arma966/ProgettazioneMeccanica2020/README.md

# ProgettazioneMeccanica2020

Versione SolidWorks: 2018

Versione MathCad: Prime 3.0
