arma966/ProgettazioneMeccanica2020/Relazione/imgs/Mathcad7.pdf

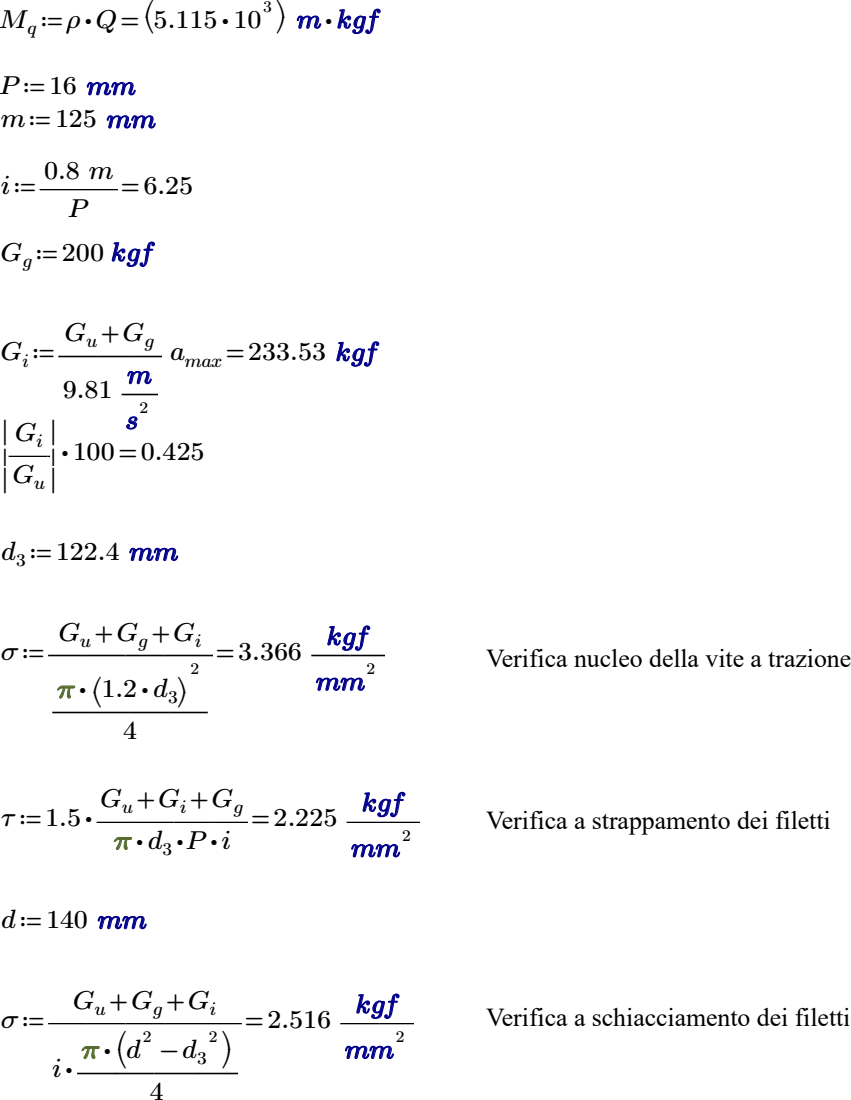
[picture p1: page 1]
m⋅ kgf; Gg≔200 kgf; amax; 233.53 kgf

Verifica nucleo della vite a trazione

Verifica a strappamento dei filetti

Verifica a schiacciamento dei filetti
