arma966/ProgettazioneMeccanica2020/Relazione/ProgettazioneMeccanica.tex

\documentclass[11pt]{article}
\usepackage[italian]{babel}
\usepackage[utf8]{inputenc}
\usepackage[margin=2.54cm]{geometry}
\usepackage{amsfonts,amsmath,amssymb}
\usepackage[none]{hyphenat}
\usepackage{fancyhdr}
\usepackage{booktabs}
\usepackage{graphicx}
\usepackage{float}
\usepackage{parskip}
\usepackage{subcaption}
\usepackage{amsmath}
\usepackage{wrapfig}
\usepackage{multicol}
%\usepackage{chngcntr}
\counterwithin{figure}{section}
\counterwithin{equation}{section}
\usepackage{quoting}
\quotingsetup{font=small}
\usepackage[official]{eurosym}
\usepackage{mathtools}
\usepackage{hyperref}
\hypersetup{
    colorlinks,
    citecolor=black,
    filecolor=black,
    linkcolor=black,
    urlcolor=black
}
\usepackage{multirow}
\usepackage{siunitx}

\pagestyle{fancy}
\fancyhead{}
\fancyfoot{}
\fancyhead[L]{\slshape \MakeUppercase{Progettazione meccanica}}
\fancyhead[R]{\slshape Davide Armenante}
\fancyfoot[C]{\thepage}

\begin{document}
\begin{titlepage}

\begin{center}
\vspace{1cm}
\large{\textbf{UNIVERSITA DEGLI STUDI DI TRIESTE}}\\[3mm]
\large{\textbf{Dipartimento di Ingegneria e Architettura}}\\[.7mm]
\large{\textbf{Corso di studi in Ingegneria Meccanica}}\\

\begin{figure}
\centering
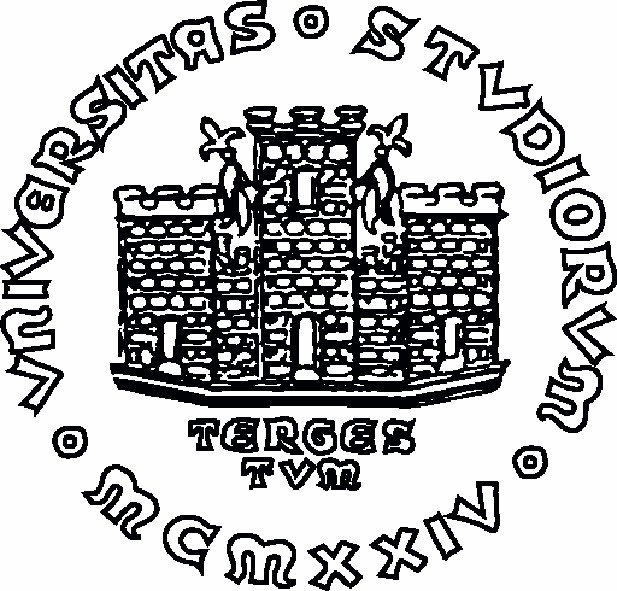
[picture p2: Relazione/imgs/unilogo.jpg]
  
\end{figure}

\vfill
\line(1,0){400}\\
\huge{\textbf{Progettazione di un bozzello con gancio per una portata di 55 tonnellate}}\\
\line(1,0){400}\\
\vfill
\hfill \normalsize Davide Armenante\\
\line(1,0){400}\\
Anno Accademico 2019-2020

\end{center}
\end{titlepage}
\pagebreak
\tableofcontents 
\thispagestyle{empty}
\pagebreak
\setcounter{page}{1}

\include{Capitoli/Introduzione}
\pagebreak
\include{Capitoli/SADT}
\pagebreak
\include{Capitoli/PrelimDim}
\pagebreak
\include{Capitoli/AnalisiFEM}
\pagebreak
\include{Capitoli/ModFin}
\pagebreak
\include{Capitoli/Conclusioni}

\appendix
\section{Golfari}
\begin{figure}[h!]
\centering
  
\end{figure}
\begin{figure}[h!]
\centering
  
\end{figure}

\end{document}
