arma966/ProgettazioneMeccanica2020/Relazione/Capitoli/Ciao.tex

\section{Ciao}
In fase di modellazione sono state modificate le quote del lamone-piastrone per permettere l'accoppiamento con le carrucole e la traversa. 
La distanza tra il foro per l'asse della traversa e quello dell'asse delle carrucole risultavano infatti troppo vicini, il carter superiore andava poi a compenetrare le carrucole.
