arma966/ProgettazioneMeccanica2020/SolidWorks/Ref/carter_circolare_00_assonometria_evidenza_profili.pdf

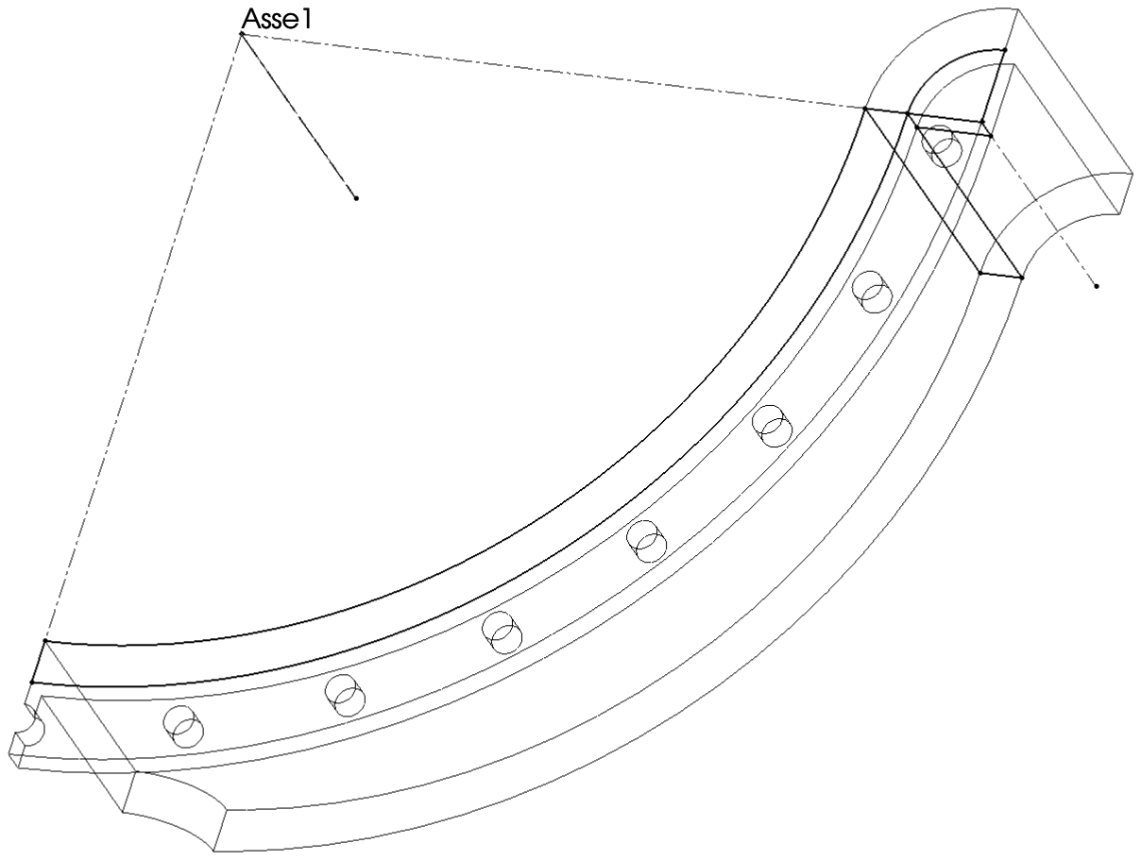
[picture p23: page 1]

Asse1
