arma966/ProgettazioneMeccanica2020/SolidWorks/Ref/irrigidimento_circolare_esterno_00_assonometria.pdf

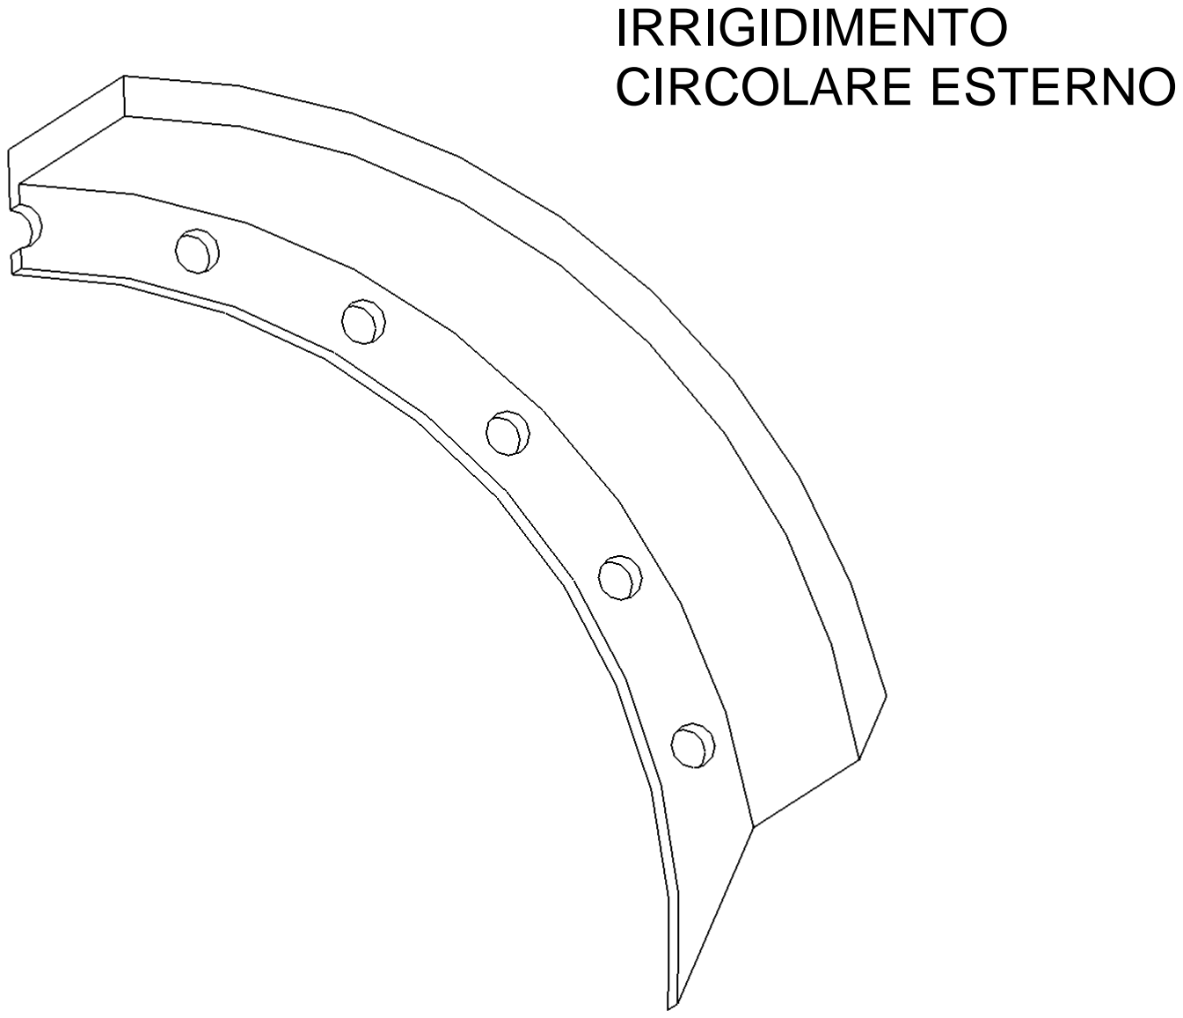
[picture p24: page 1]
