arma966/ProgettazioneMeccanica2020/SolidWorks/Ref/irrigidimento_circolare_esterno_00_evidenza_profili.pdf

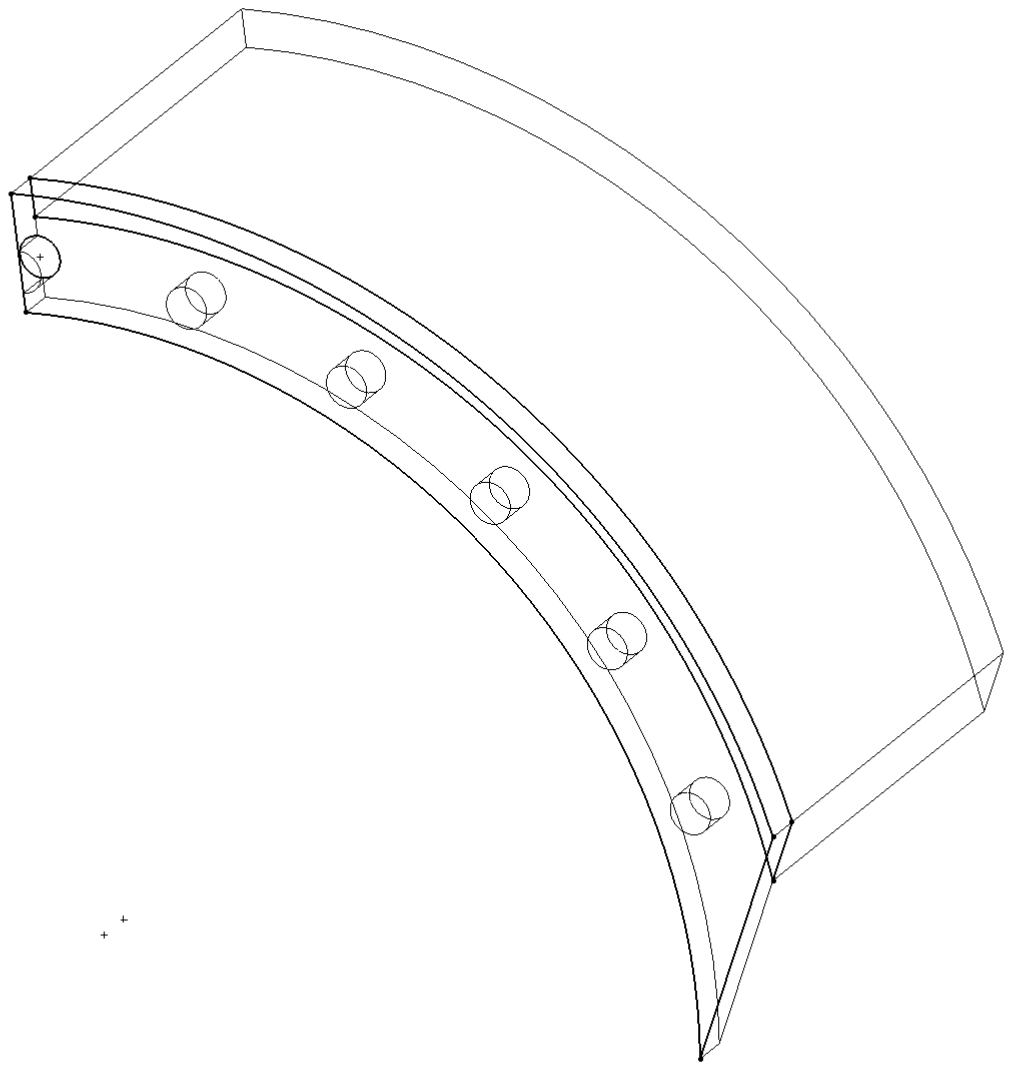
[picture p25: page 1]
