arma966/ProgettazioneMeccanica2020/SolidWorks/Ref/irrigidimento_esterno_00_assonometria.pdf

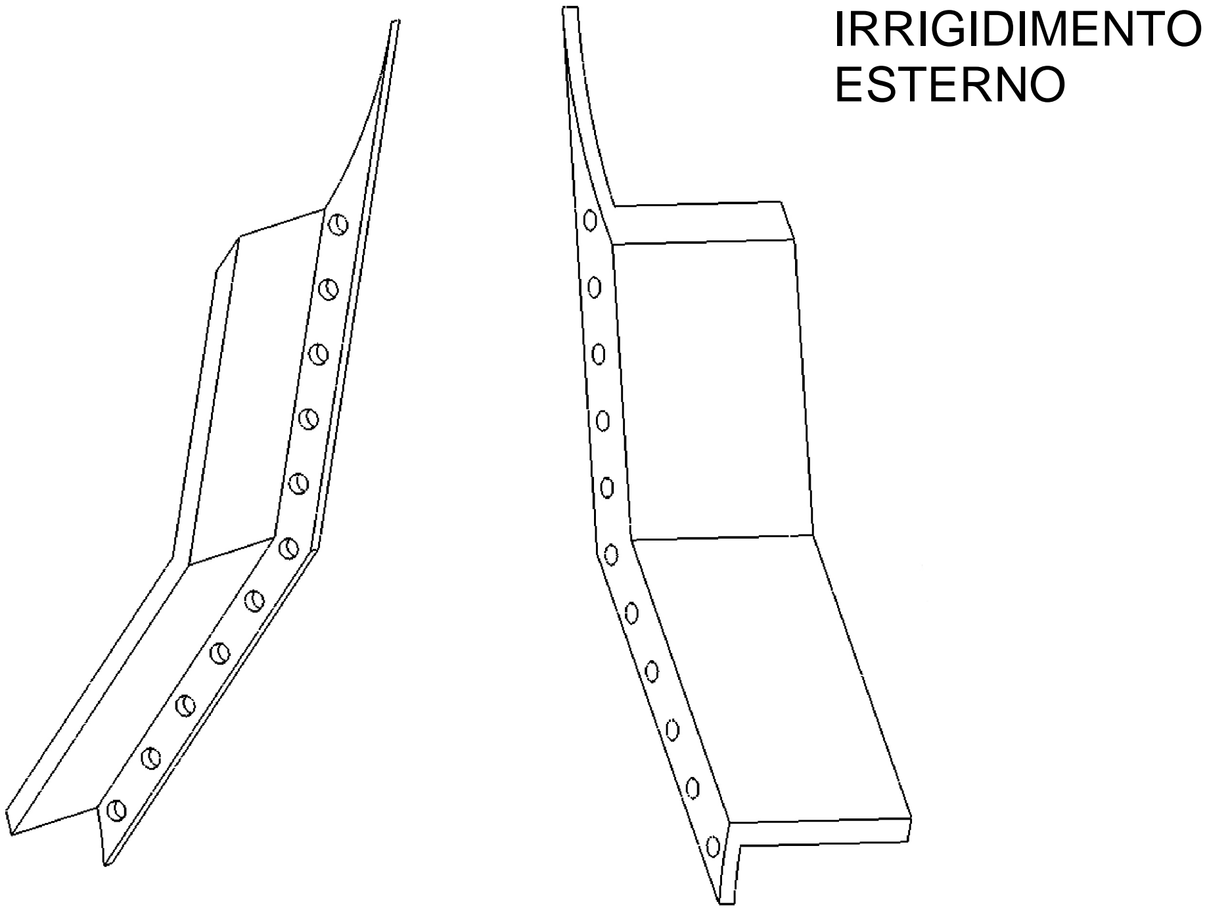
[picture p26: page 1]
