arma966/ProgettazioneMeccanica2020/SolidWorks/Ref/irrigidimento_esterno_00_evidenza_profili.pdf

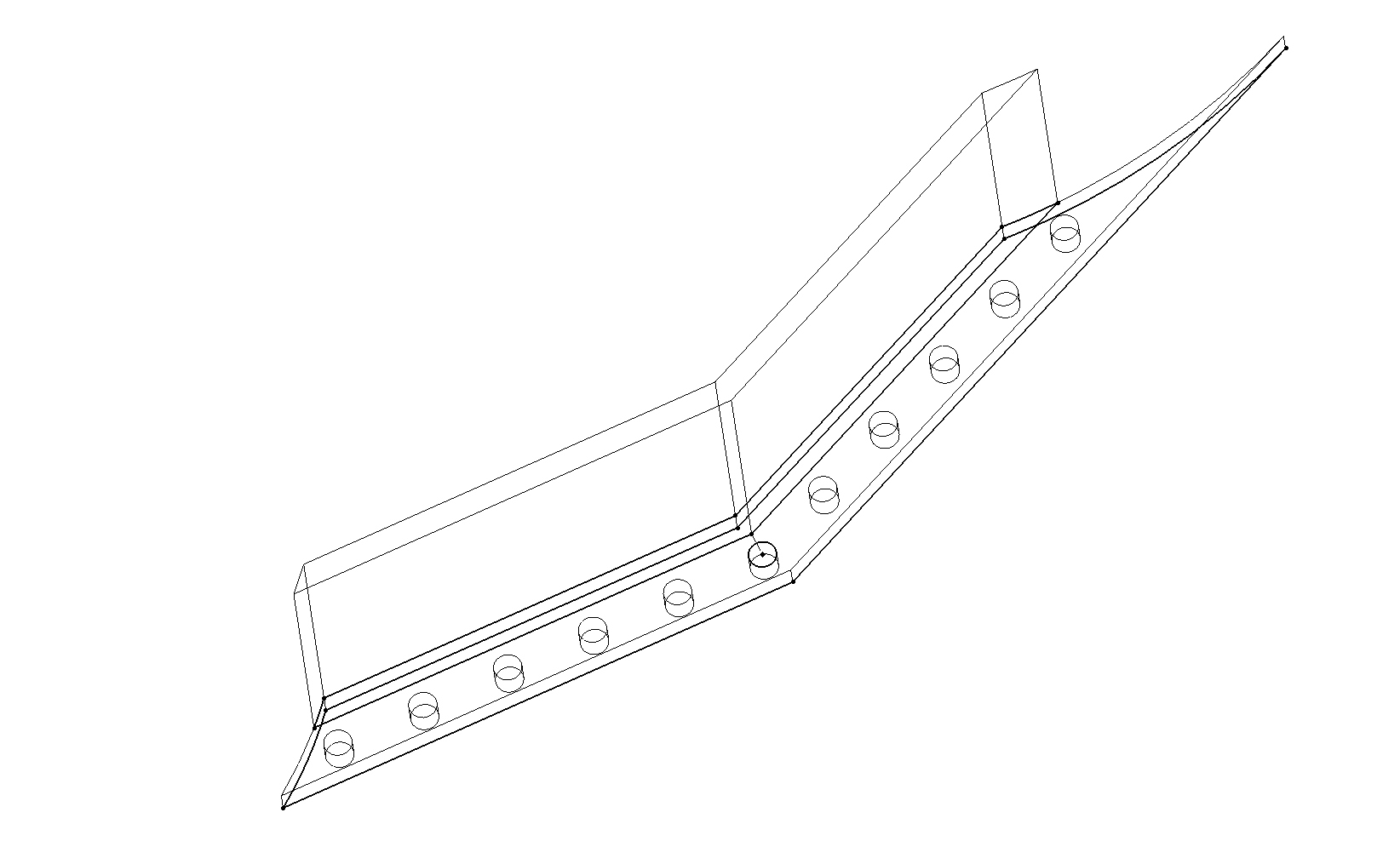
[picture p27: page 1]
