arma966/ProgettazioneMeccanica2020/SolidWorks/Ref/piastrone_00_assonometria.pdf

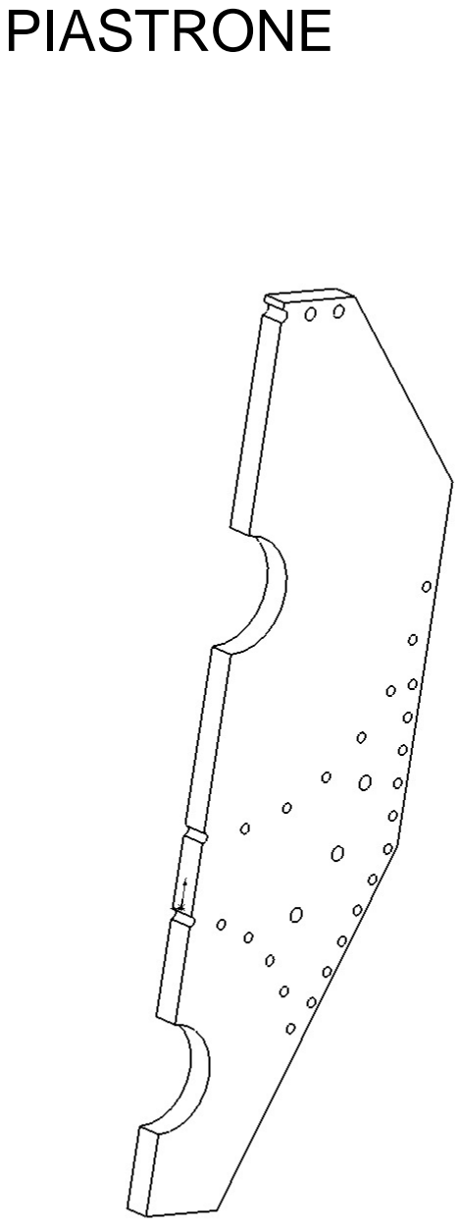
[picture p28: page 1]
