arma966/ProgettazioneMeccanica2020/SolidWorks/Ref/puleggia_00_assonometria.pdf

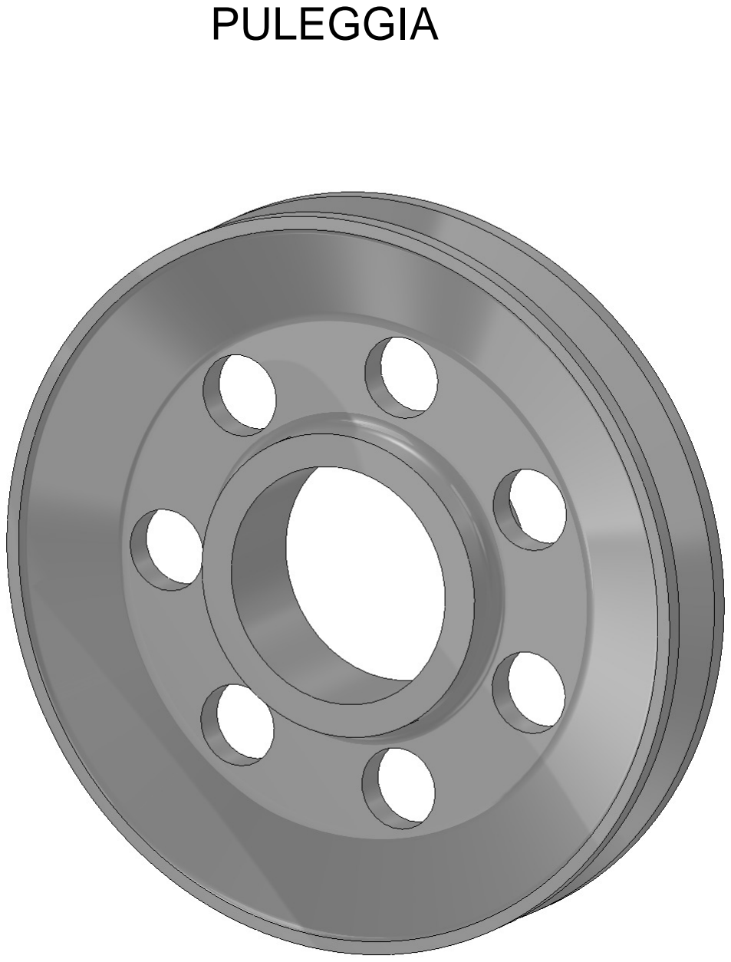
[picture p29: page 1]
