arma966/ProgettazioneMeccanica2020/SolidWorks/Ref/puleggia_00_evidenza_profili.pdf

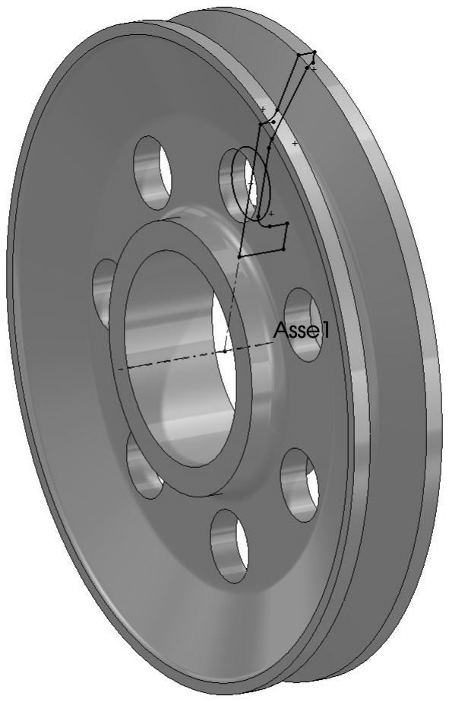
[picture p30: page 1]

Asse1
