arma966/ProgettazioneMeccanica2020/SolidWorks/Ref/traversa_00_assonometria.pdf

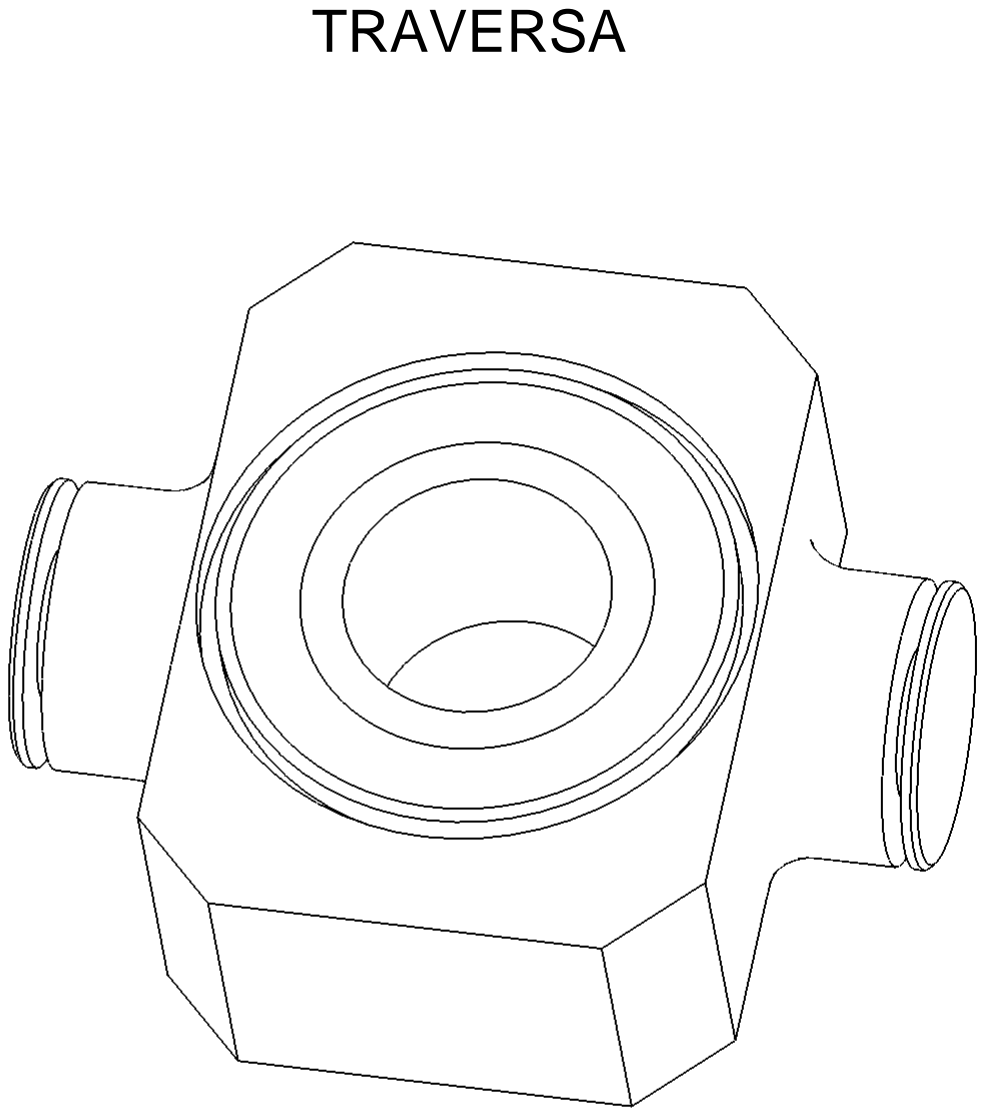
[picture p31: page 1]
