arma966/ProgettazioneMeccanica2020/SolidWorks/Ref/traversa_00_evidenza_profili.pdf

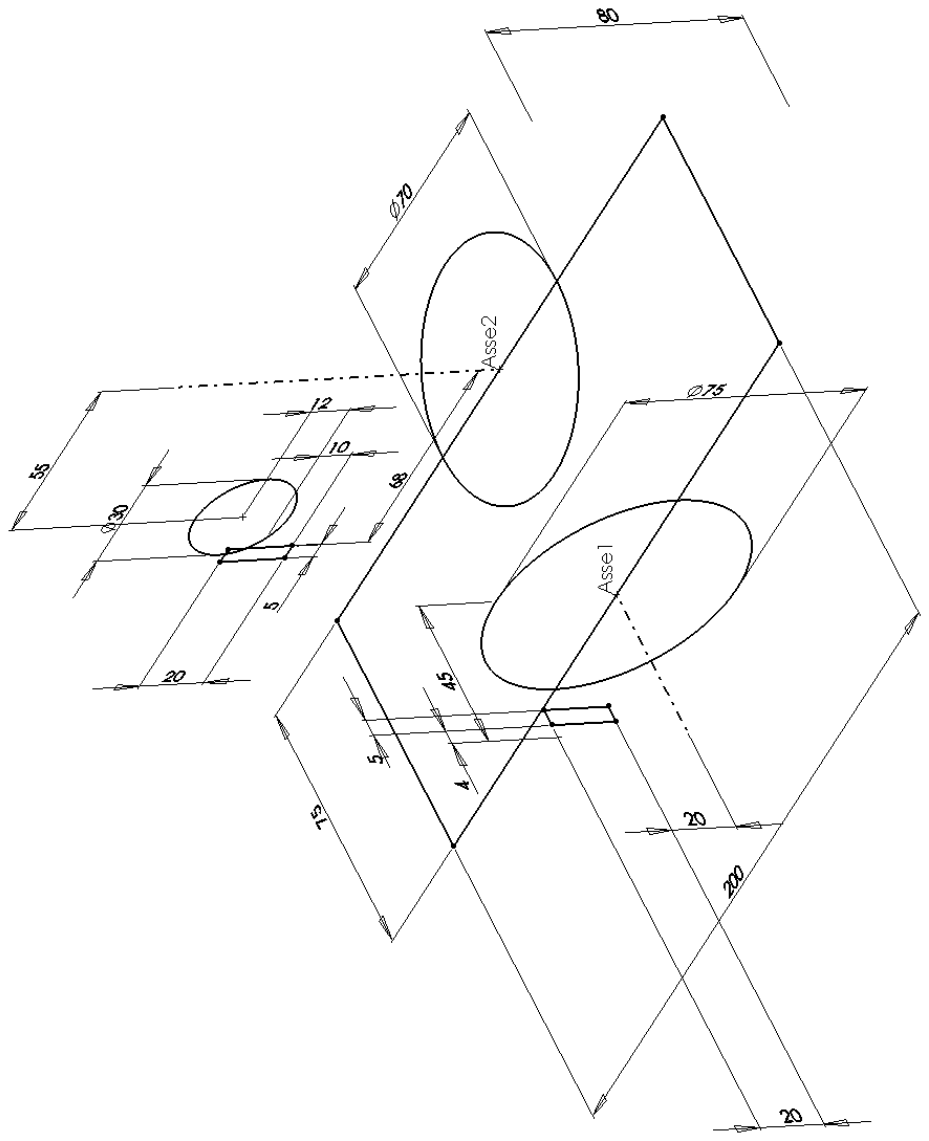
[picture p32: page 1]
