arma966/ProgettazioneMeccanica2020/Relazione/imgs/FilettaturaTabella.pdf

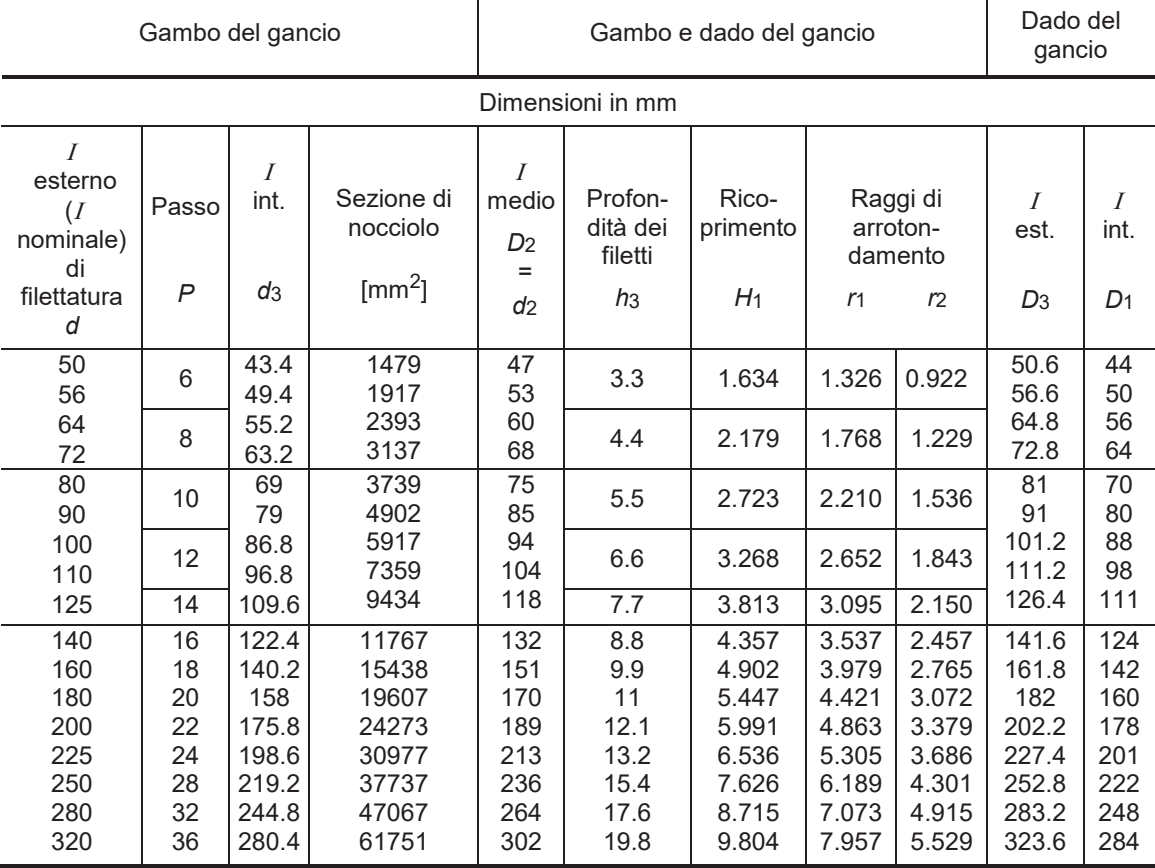
[picture p33: figure]
Gambo del gancio; Gambo e dado del gancio; ado del gancio; Dimensioni in mm;  esterno ( nominale) di filettatura d; Passo;  int.; Sezione di nocciolo; [mm² ];  medio; Profon- dità dei filetti; Rico- primento; Raggi di arroton- damento;  est.
