arma966/ProgettazioneMeccanica2020/Relazione/imgs/MathAsse2.pdf

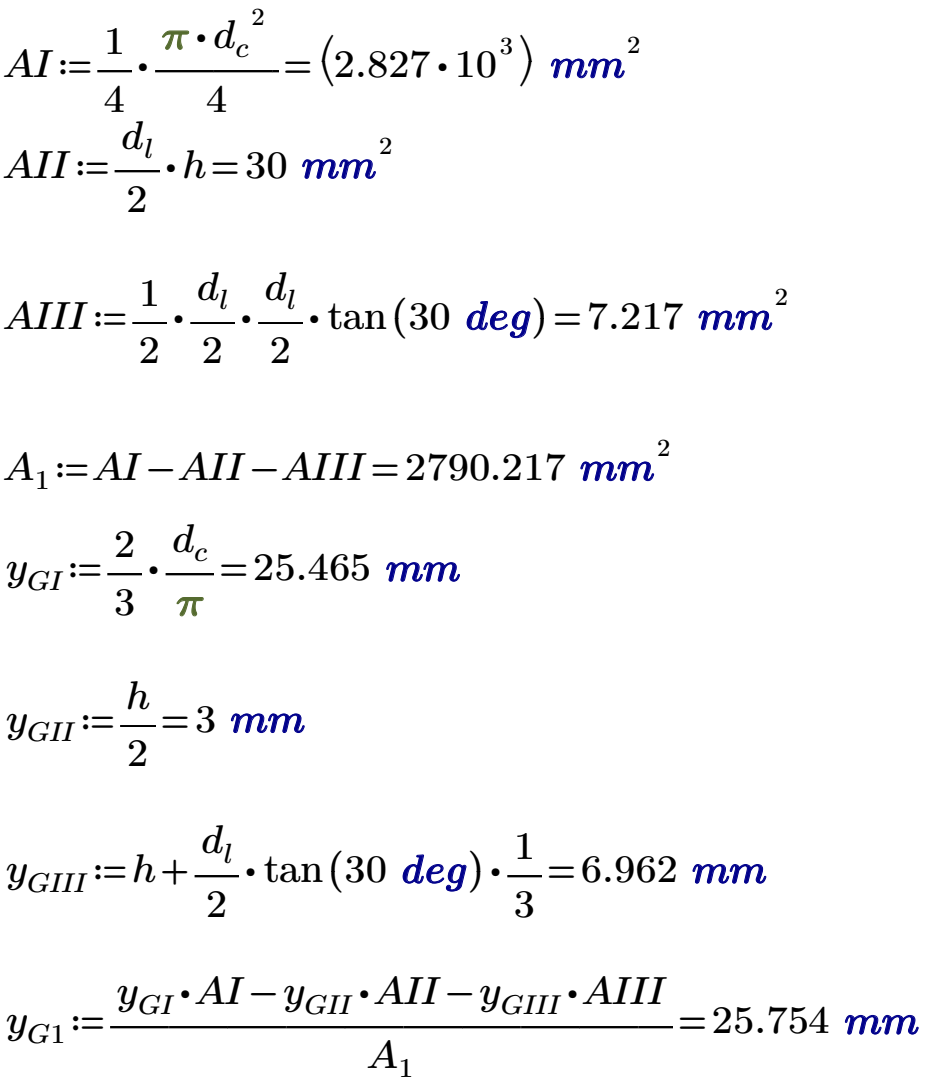
[picture p34: page 1]
AII≔―⋅ = dl 2; AIII≔―⋅ ⋅ ⋅; tan; 30 deg; A1≔AI AII AIII −−; yGI≔―⋅; yGII≔―= h 2; yGIII≔h; ( 30 deg; yG1≔――――――――――= yGI AI yGII ⋅AII−−⋅; yGIII ⋅AIII
