arma966/ProgettazioneMeccanica2020/Relazione/imgs/MathAsse4.pdf

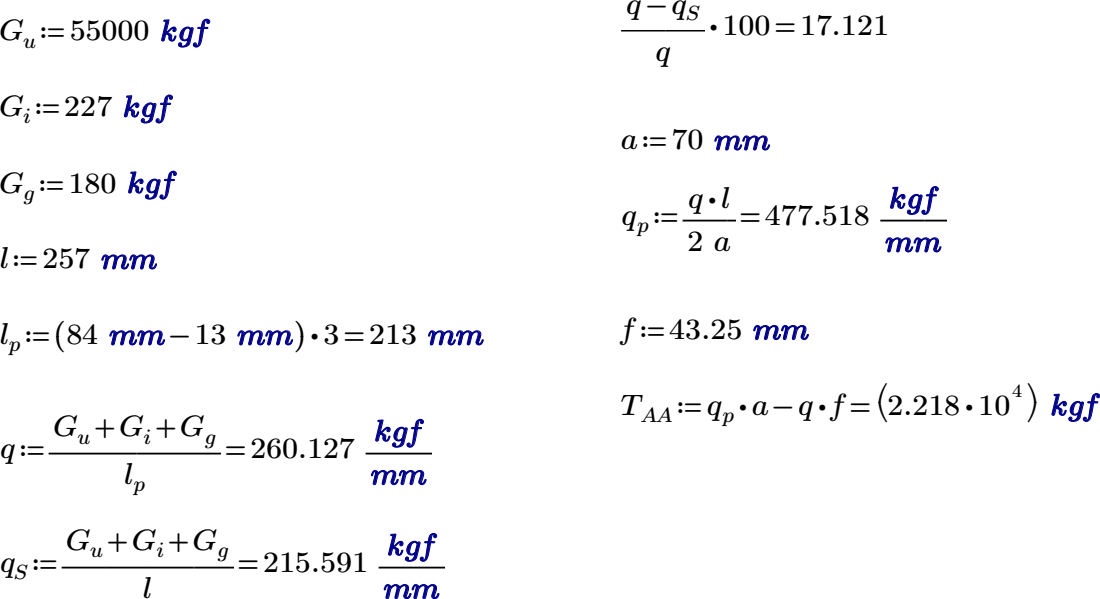
[picture p35: page 1]
Gu≔55000 kgf; Gi≔227 kgf; Gg≔180 kgf; 260.127 ―kgf ―mm; 215.591 ―kgf ―mm; 477.518 ―kgf ―mm; TAA≔qp ⋅a−q f⋅ =⎛ ⎝; kgf
