arma966/ProgettazioneMeccanica2020/Relazione/imgs/MathAsse4_0.pdf

S1ACn

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
H y +
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
y y −
G

⎞⎠

2
r

⎞⎠
y
