arma966/ProgettazioneMeccanica2020/Relazione/imgs/MathAsse5_0.pdf

S2ACn

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
h y −
G

⎞⎠

H y +
Gy
⋅

⎛⎝
−

R

−

2
⎛⎝y y −
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
h y −
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
――――― |y|−⎛⎝
h y −
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
