arma966/ProgettazioneMeccanica2020/Relazione/imgs/MathAsse5_1.pdf

α

⎛⎝
ybr

⎞⎠
≔

――⋅ 180π
atan

⎛⎜⎜⎝

―――――――― ||ybr||+yG br ⎛⎝ybr⎞⎠+――――― ||ybr||−⎛⎝h y − G⎞⎠

tan

(
30
d

e

g

)

⎞⎟⎟⎠
