arma966/ProgettazioneMeccanica2020/Relazione/imgs/MathAsse6_0.pdf

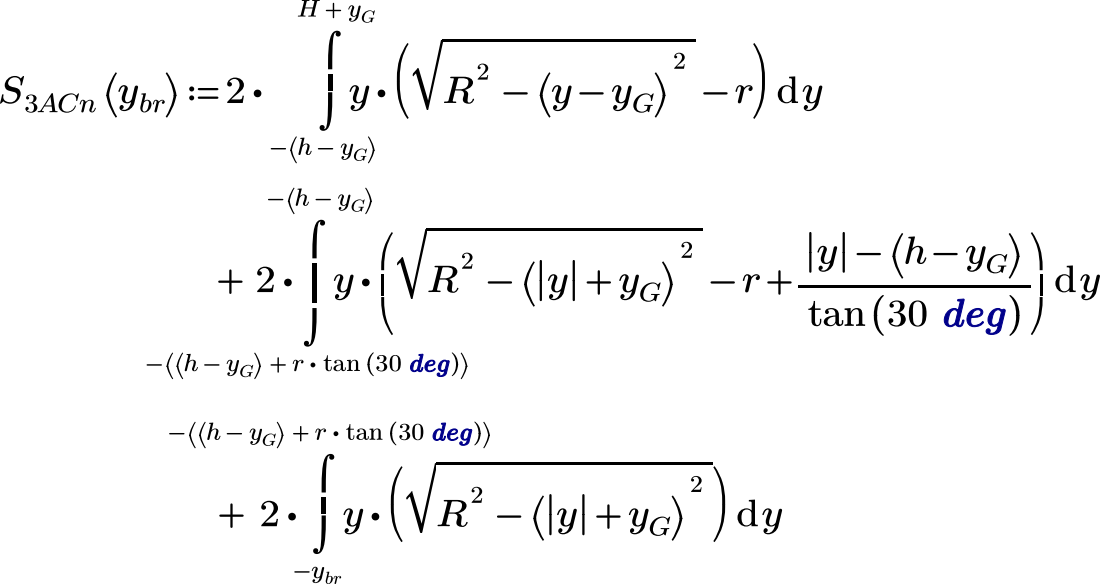
[picture p36: page 1]
