arma966/ProgettazioneMeccanica2020/Relazione/imgs/MathAsse6_1.pdf

br ⎛
⎝

ybr

⎞⎠≔2⋅ R −²
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
⎞⎠≔―180―π

atan⎛
⎜
⎜
⎝

――― ||
ybr
+yG
――― br ⎛
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
