arma966/ProgettazioneMeccanica2020/Relazione/imgs/MathAsse7.pdf

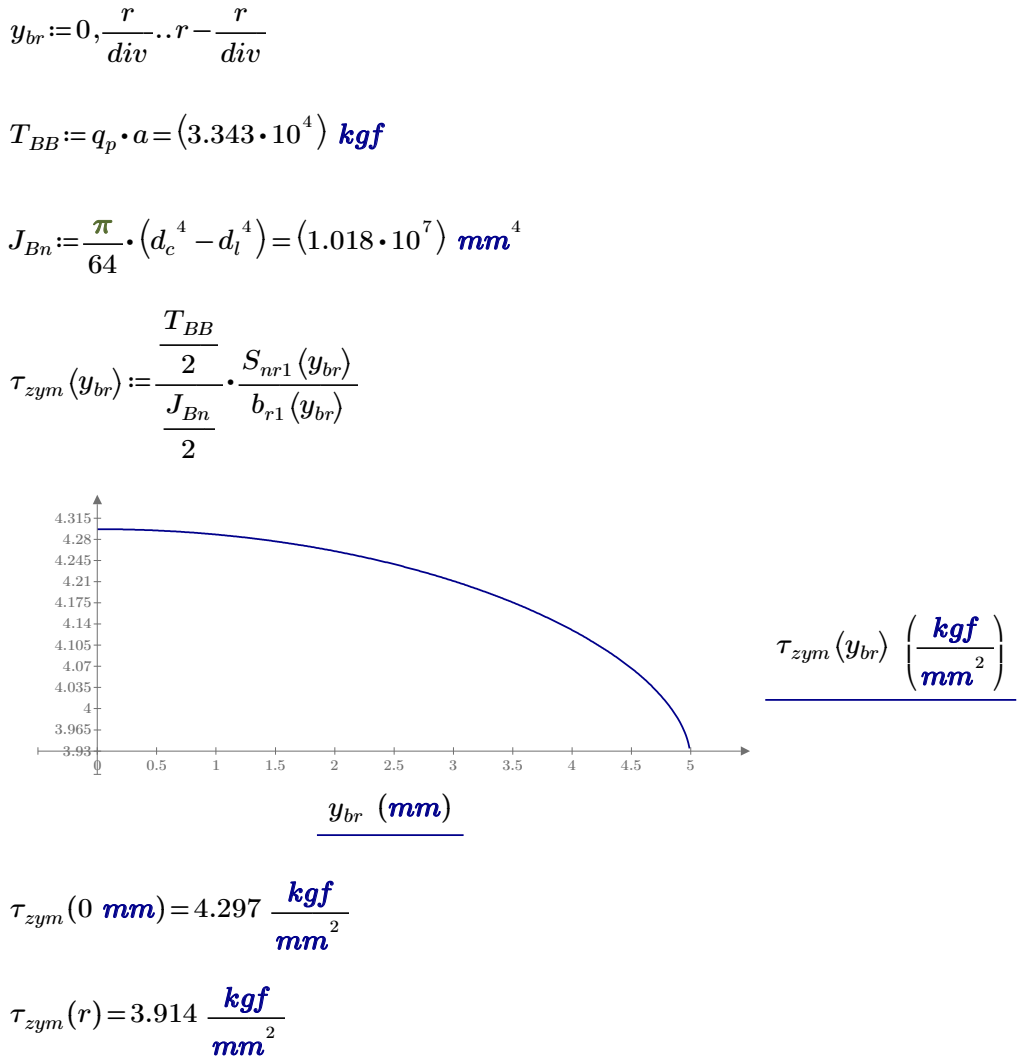
[picture p37: page 1]
TBB≔qp ⋅a=⎛ ⎝; kgf; JBn≔―⋅; τzym; ybr; ――TBB 2 ――JBn 2; ――― Snr1; ybr≔0,――‥ r div; r−―r ―div
