arma966/ProgettazioneMeccanica2020/Relazione/imgs/Mathcad5.pdf

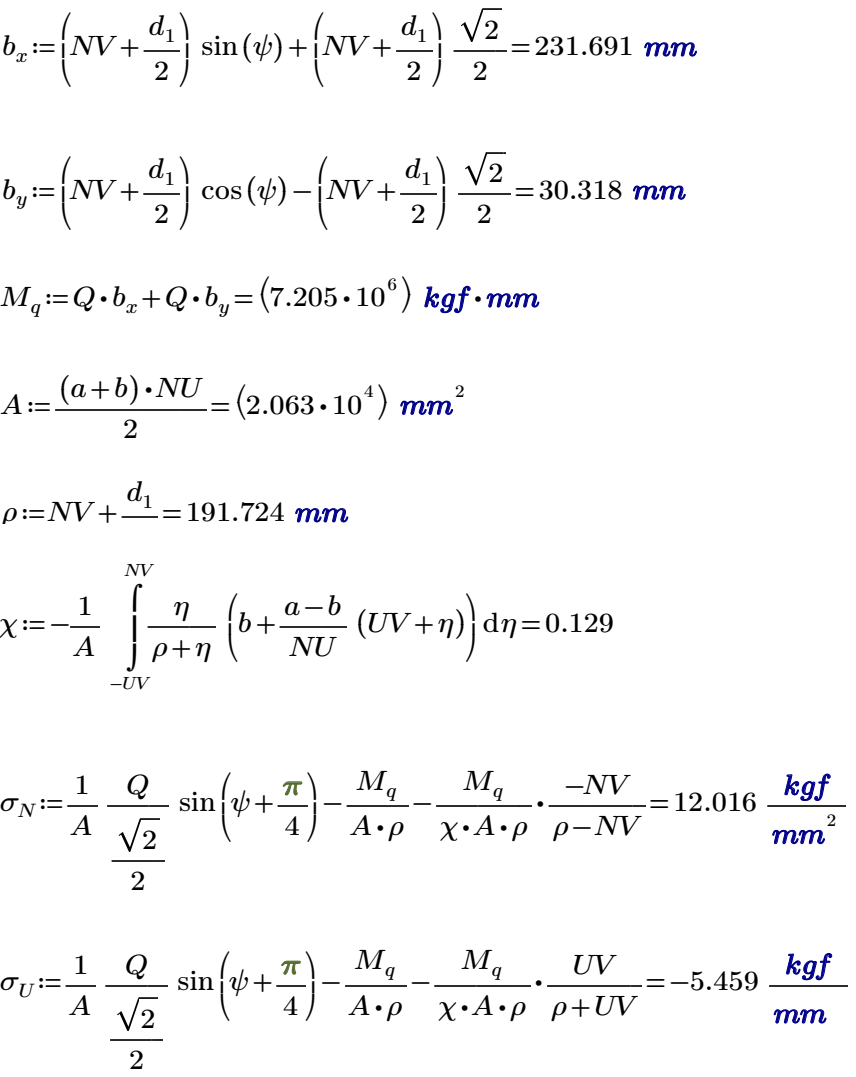
[picture p38: page 1]
sin; cos; kgf ⋅mm; sin⎛ ⎜ ⎝
