arma966/ProgettazioneMeccanica2020/Relazione/imgs/Mathcad6.pdf

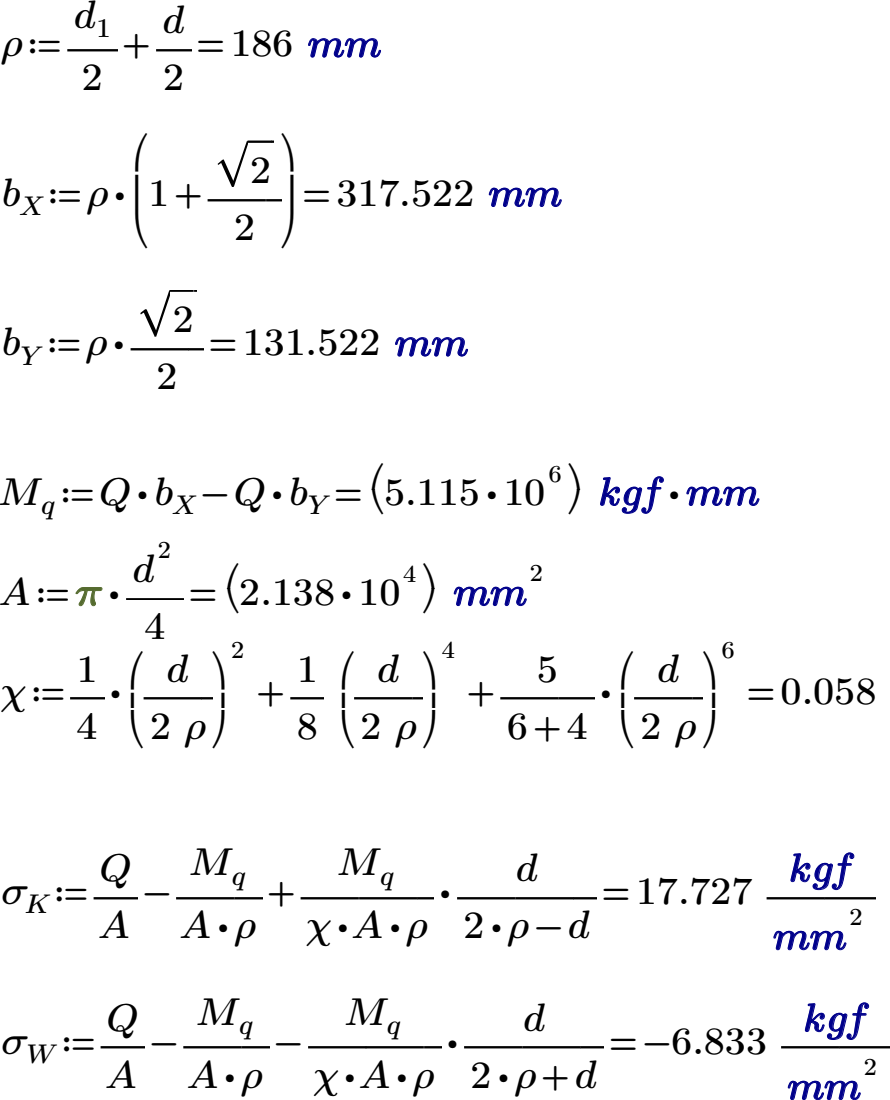
[picture p39: page 1]
kgf ⋅mm
