arma966/ProgettazioneMeccanica2020/Relazione/imgs/MathLP4.pdf

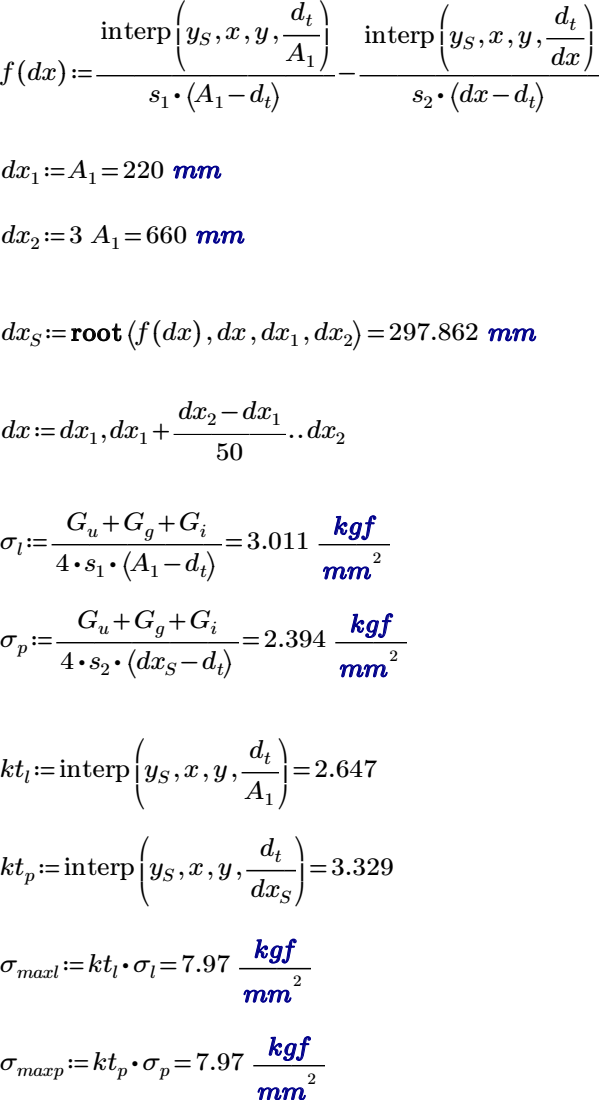
[picture p40: page 1]
interp⎛ ⎜ ⎝; dxS≔ root; dxS−dt; ktl≔; =interp⎛; ktp≔interp; y , , , S x y ――dt dxS

σmaxl≔ktl⋅σl=7.97 ―kg

σmaxp≔ktp ⋅σp=7.97 ―kg
