arma966/ProgettazioneMeccanica2020/Relazione/imgs/MathTrav1.pdf

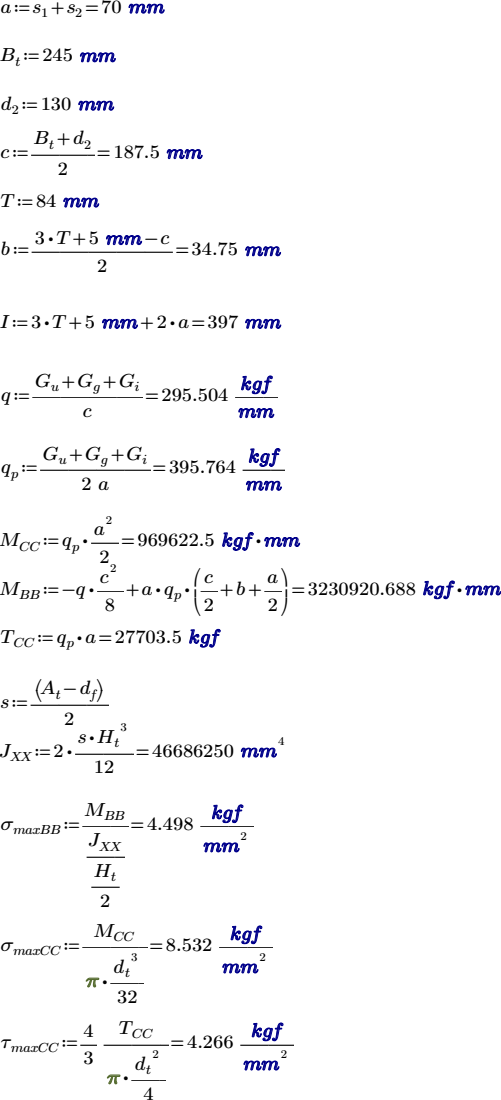
[picture p41: page 1]
295.504 ―kgf ―mm; 395.764 ―kgf ―mm; MCC≔qp ⋅―= a; 969622.5 kgf ⋅mm; MBB≔−q ⋅―; 3230920.688 kgf ⋅ mm; 2 JXX≔2 ⋅―――= s H⋅ t; σmaxBB≔――= MBB ――JXX; σmaxCC≔―――= MCC; τmaxCC≔―; 3 ――― TCC

TCC≔qp ⋅a=27703.5 kgf
