arma966/ProgettazioneMeccanica2020/Relazione/imgs/MathTrav4.pdf

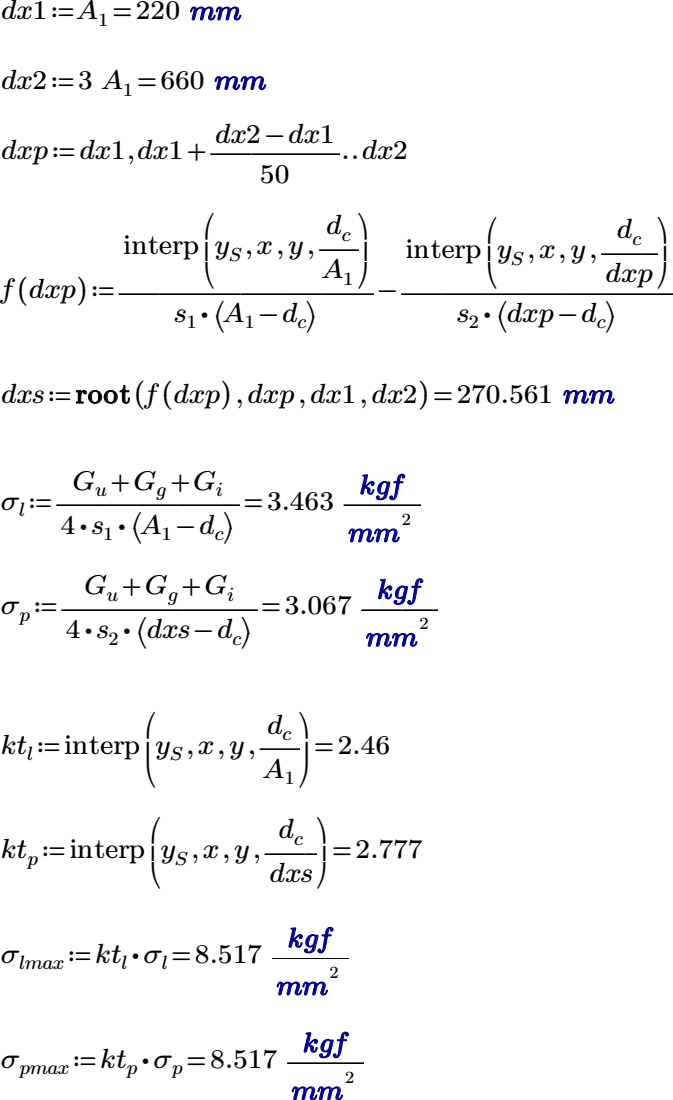
[picture p42: page 1]
dxp≔dx1,dx1+――――‥ dx2 dx1 − 50; dxp; interp⎛ ⎜ ⎝; dxp d − c⎞⎠; dxs≔root; ) ,dxp dx1 dx2 ,; dxs d − c⎞⎠; ktl≔interp; ktp≔interp; dxs

σlmax≔ktl⋅σl=8.517 ―kg

σpmax≔ktp ⋅σp=8.517 ―kg
