arma966/ProgettazioneMeccanica2020/Relazione/imgs/fem/GancioCarico1.jpg

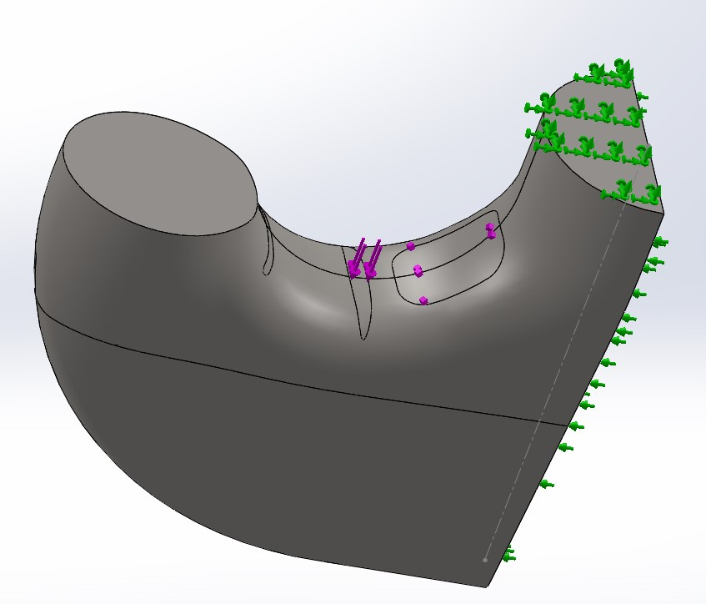
Relazione/imgs/fem/GancioCarico1.jpg
