arma966/ProgettazioneMeccanica2020/Relazione/imgs/fem/GancioCarico2.jpg

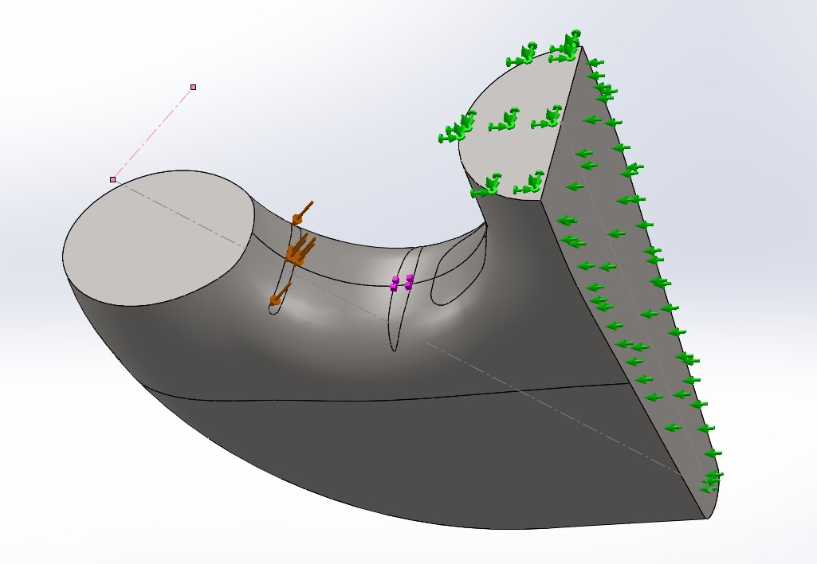
Relazione/imgs/fem/GancioCarico2.jpg
