arma966/ProgettazioneMeccanica2020/Relazione/imgs/fem/QuartoHD.jpg

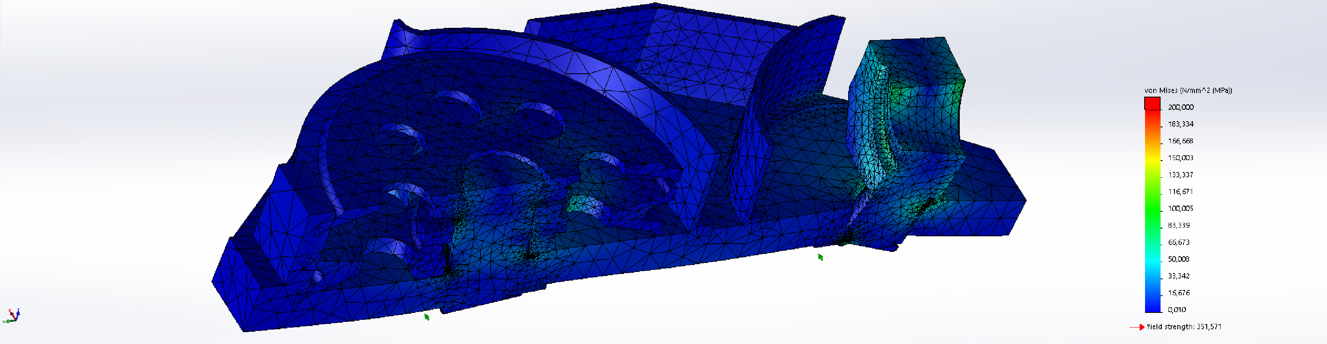
Relazione/imgs/fem/QuartoHD.jpg
