arma966/ProgettazioneMeccanica2020/Relazione/imgs/fem/SimGambo2.PNG

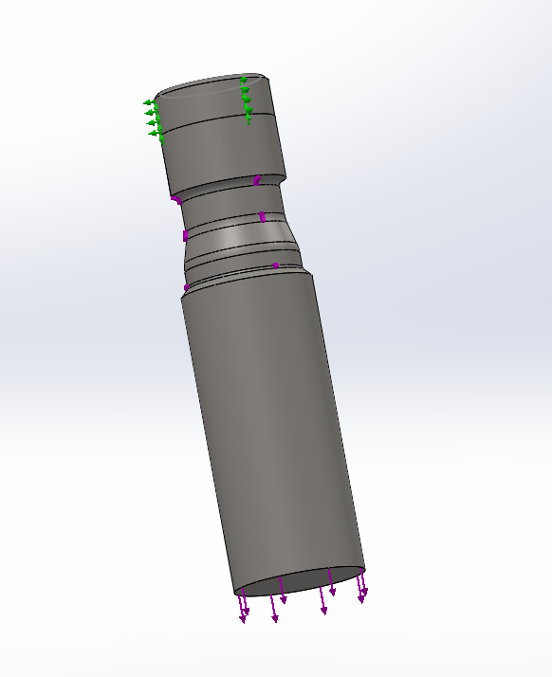
Relazione/imgs/fem/SimGambo2.PNG
