arma966/ProgettazioneMeccanica2020/Relazione/imgs/fem/SimTraversa2.PNG

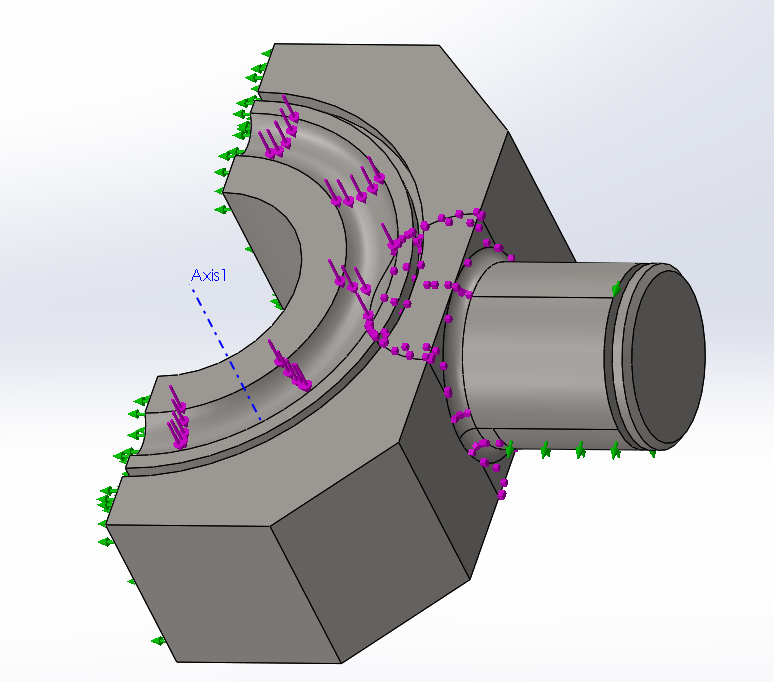
Relazione/imgs/fem/SimTraversa2.PNG
