arma966/ProgettazioneMeccanica2020/Relazione/imgs/fem/SimTraversa3.PNG

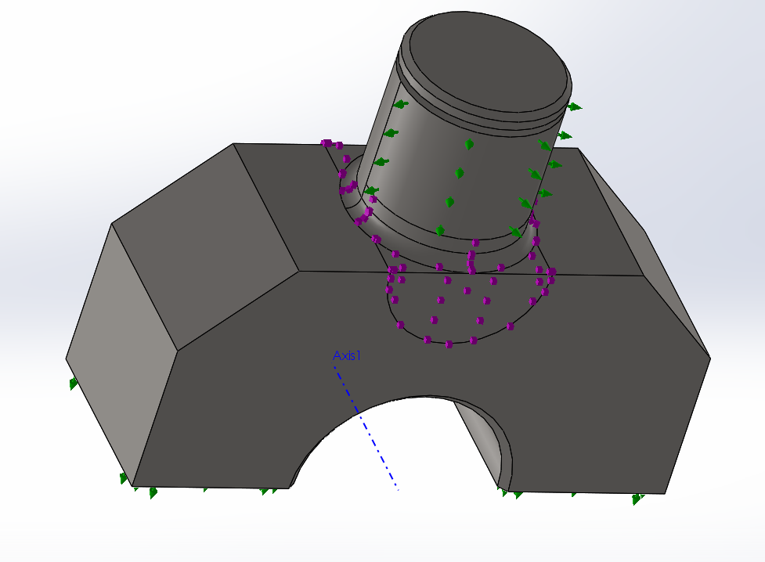
Relazione/imgs/fem/SimTraversa3.PNG
