arma966/ProgettazioneMeccanica2020/Relazione/imgs/fem/TraversaSim1.jpg

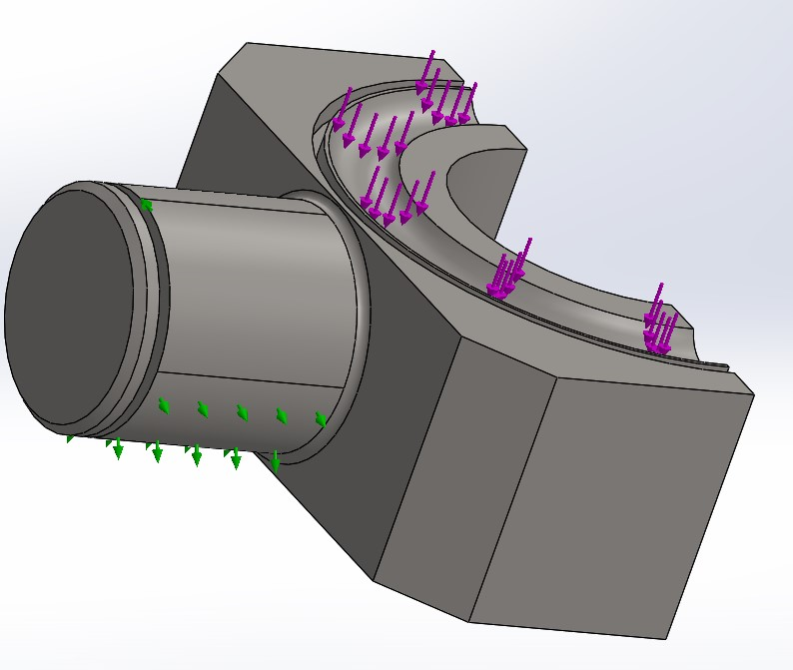
Relazione/imgs/fem/TraversaSim1.jpg
