arma966/ProgettazioneMeccanica2020/Relazione/imgs/fem/TraversaSim1.png

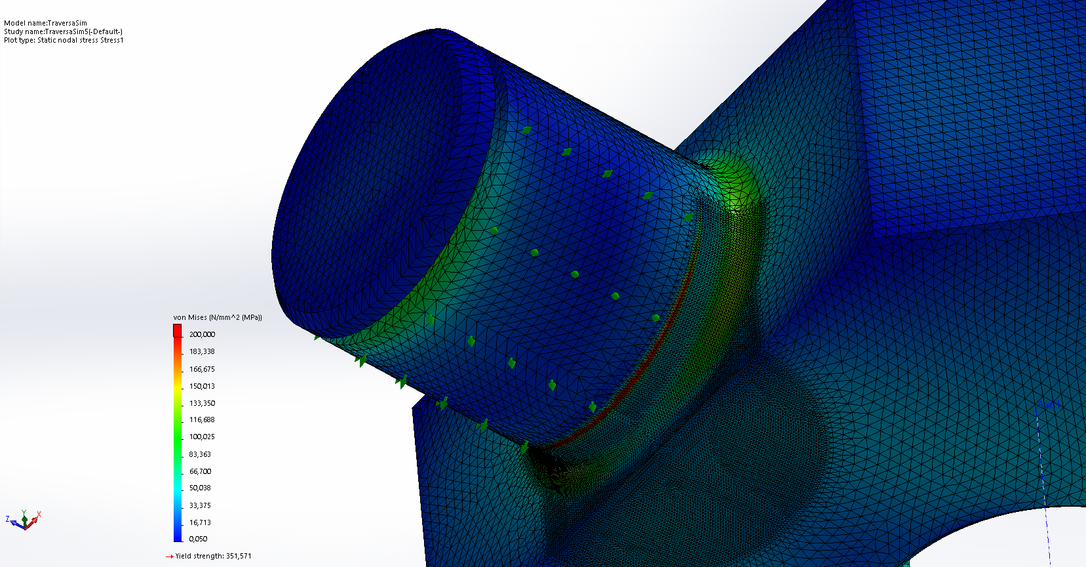
Relazione/imgs/fem/TraversaSim1.png
