arma966/ProgettazioneMeccanica2020/Relazione/render/Gancio1.png

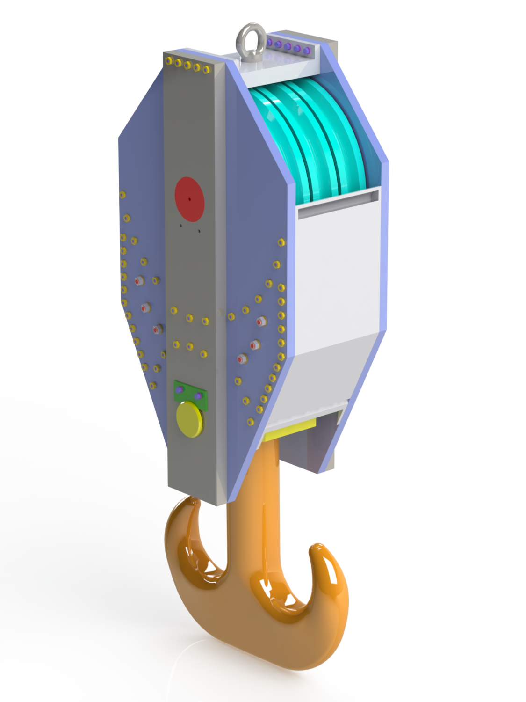
Relazione/render/Gancio1.png
