arma966/ProgettazioneMeccanica2020/Relazione/render/zoom1.png

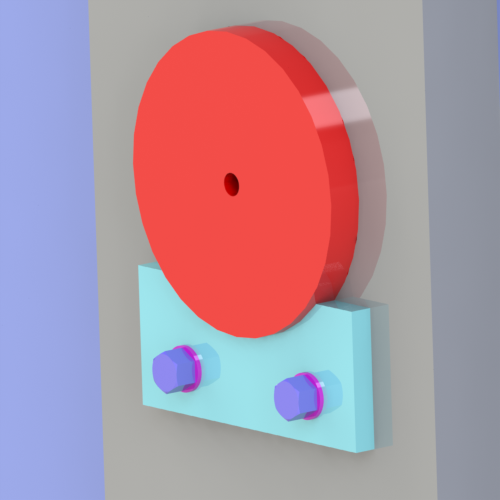
Relazione/render/zoom1.png
