arma966/ProgettazioneMeccanica2020/Relazione/render/zoom2.png

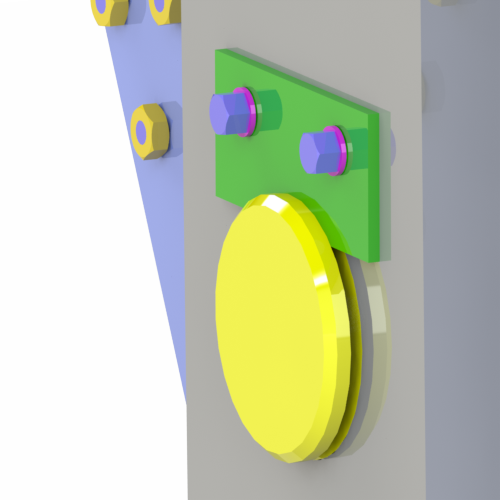
Relazione/render/zoom2.png
