arma966/ProgettazioneMeccanica2020/SolidWorks/Simulazioni/RisultatiGancio/GancioSim-Static 1/GancioFea1.png

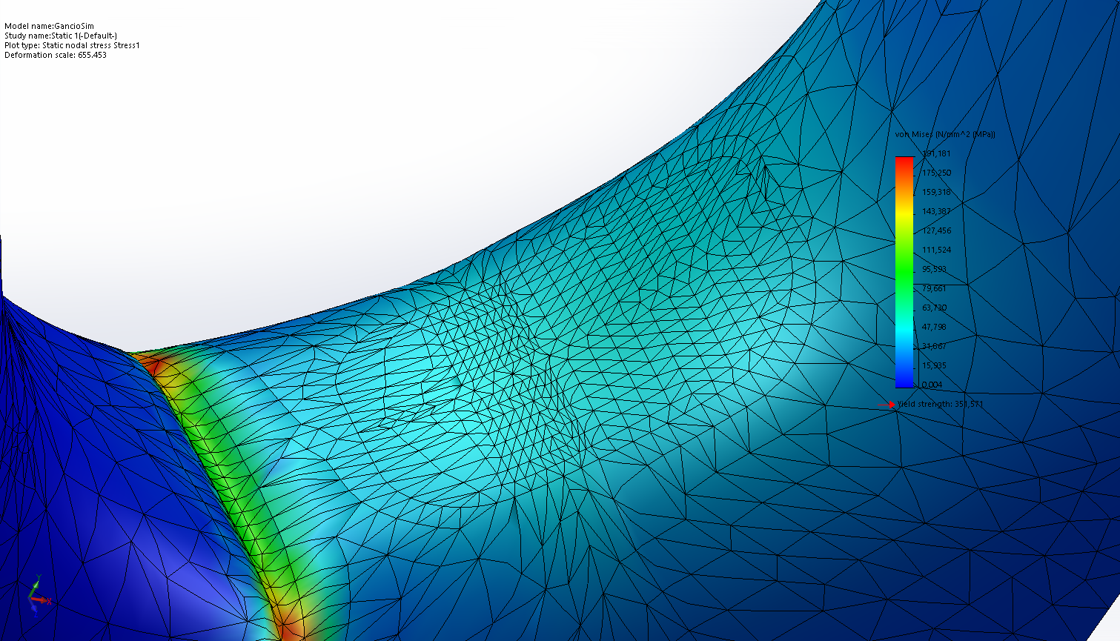
SolidWorks/Simulazioni/RisultatiGancio/GancioSim-Static 1/GancioFea1.png
