arma966/ProgettazioneMeccanica2020/SolidWorks/Simulazioni/RisultatiGancio/GancioSim-Static 1/GancioFEA2.png

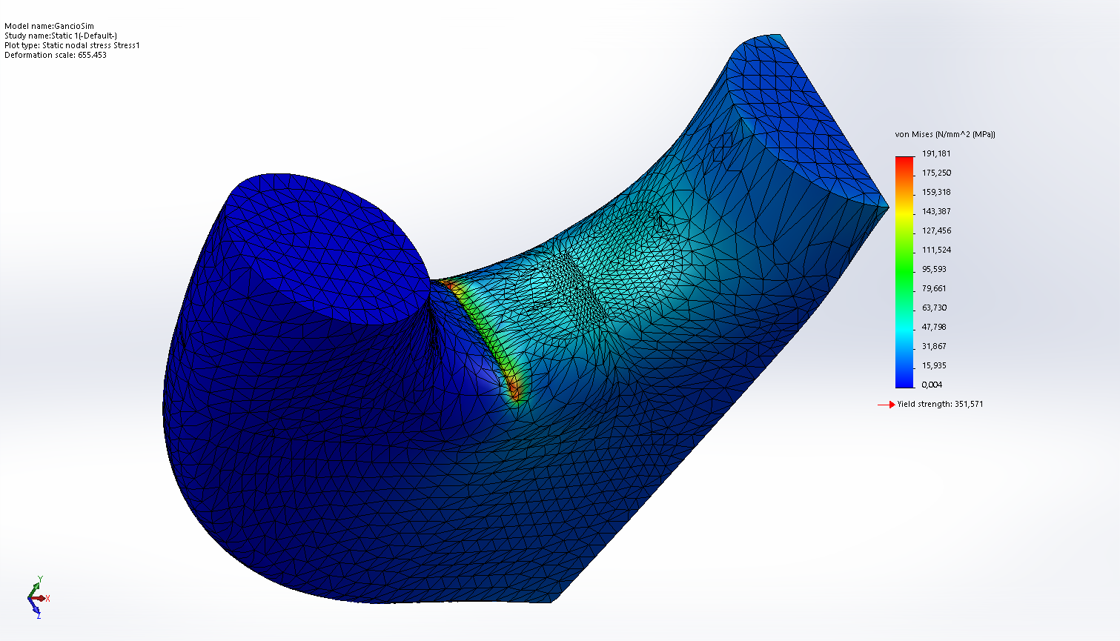
SolidWorks/Simulazioni/RisultatiGancio/GancioSim-Static 1/GancioFEA2.png
