arma966/ProgettazioneMeccanica2020/SolidWorks/Assembly.SLDASM

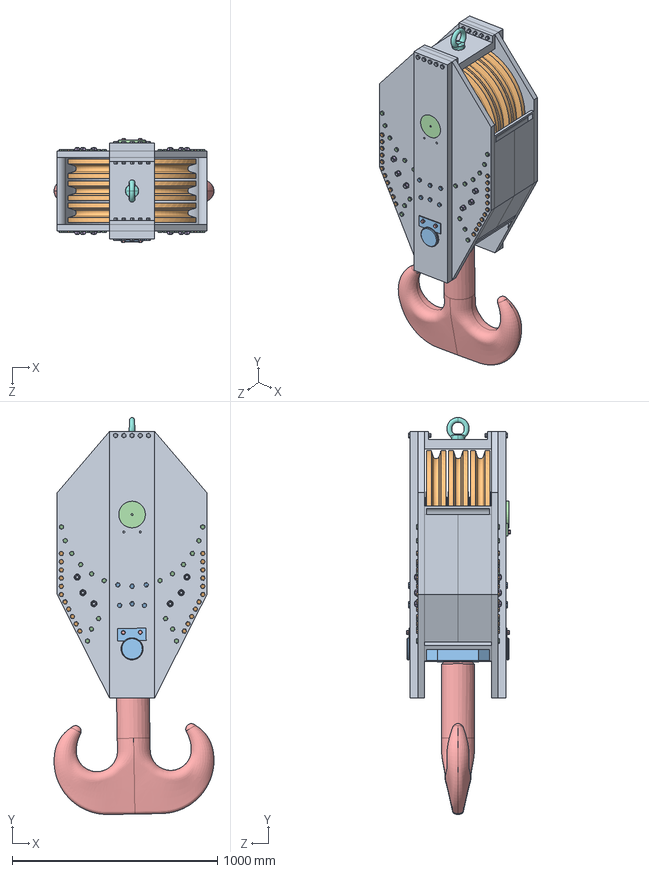
[picture p56: CAD file, 2020-09-05]
SolidWorks/Assembly.SLDASM
779.9 x 1935.7 x 507.0 mm
Piastrone
Puleggia x 3
Traversa
Asse
Gancio
Dado x 15
Boccola x 6
Golfare
M10 x 10
M10 - Corta x 44
M10 - Media x 14
M10 - 50mm x 36
M10 - Mordente x 6
