arma966/ProgettazioneMeccanica2020/SolidWorks/Simulazioni/MezzoBozzello/MezzoBozzelloSM.SLDASM

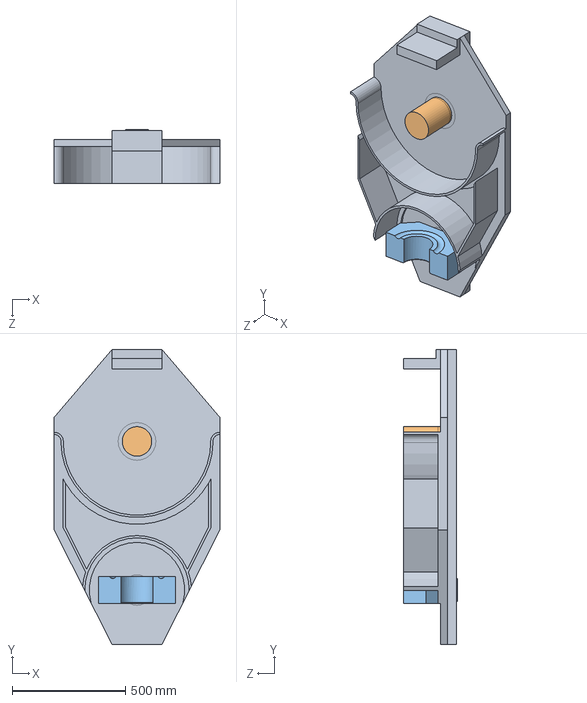
[picture p57: CAD file, 2020-09-05]
SolidWorks/Simulazioni/MezzoBozzello/MezzoBozzelloSM.SLDASM
730.0 x 1300.0 x 240.0 mm
PiastroneMB
AsseMB
