arma966/ProgettazioneMeccanica2020/SolidWorks/Simulazioni/Quarto/QuartoDiBozzello.SLDASM

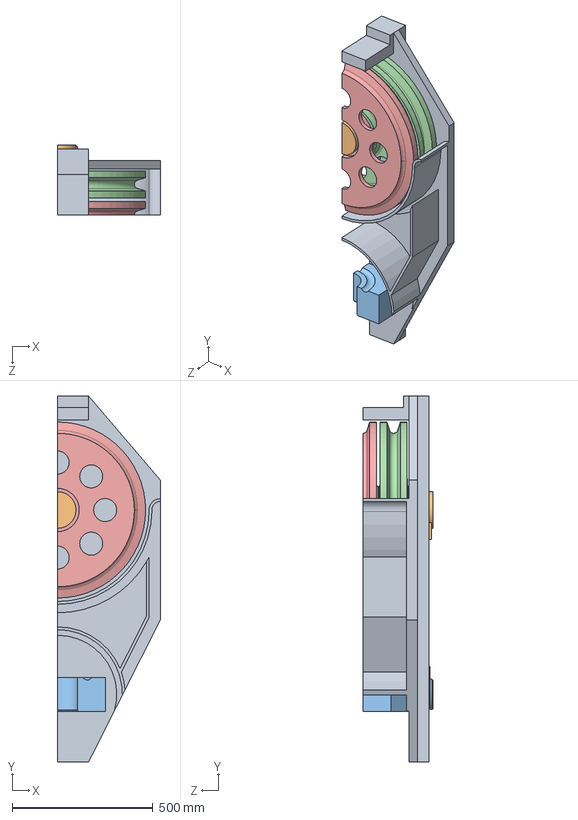
[picture p58: CAD file, 2020-09-05]
SolidWorks/Simulazioni/Quarto/QuartoDiBozzello.SLDASM
365.0 x 1300.0 x 249.0 mm
PiastroneQ
AsseQ
TraversaQ
PuleggiaQ
PuleggiaMezzaQ
