arma966/ProgettazioneMeccanica2020/SolidWorks/M10.SLDPRT

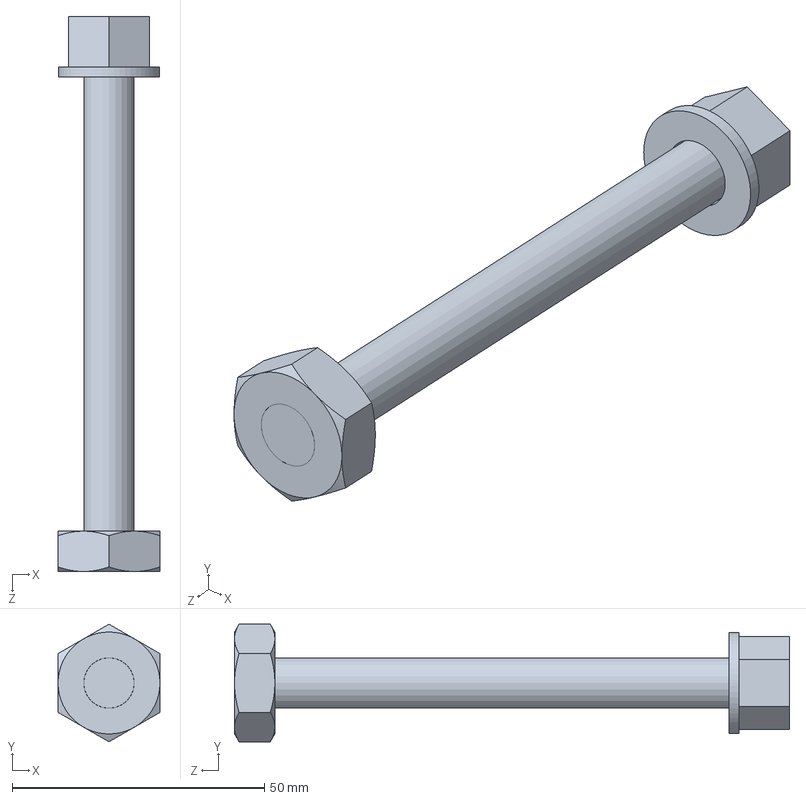
[picture p59: CAD file, 2020-09-05]
SolidWorks/M10.SLDPRT
20.2 x 23.3 x 110.0 mm
