arma966/ProgettazioneMeccanica2020/SolidWorks/Ref/YT_Flangia.SLDPRT

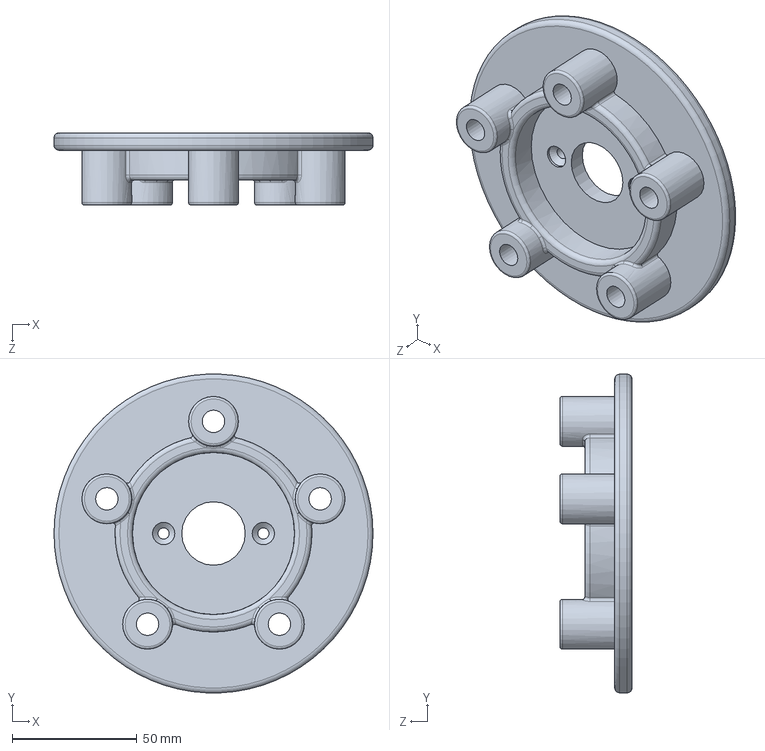
[picture p60: CAD file, 2020-09-05]
SolidWorks/Ref/YT_Flangia.SLDPRT
128.0 x 127.9 x 29.0 mm
