arma966/ProgettazioneMeccanica2020/SolidWorks/Simulazioni/AsseSim.SLDPRT

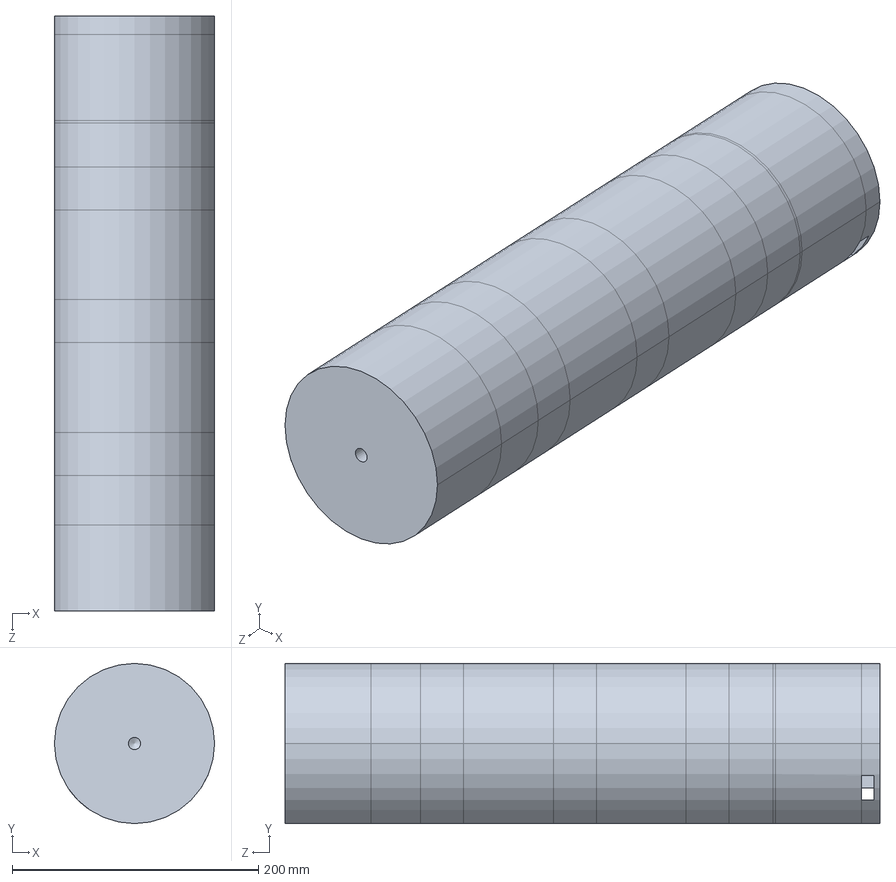
[picture p61: CAD file, 2020-09-05]
SolidWorks/Simulazioni/AsseSim.SLDPRT
130.0 x 130.0 x 483.0 mm
