arma966/ProgettazioneMeccanica2020/SolidWorks/Simulazioni/MezzoBozzello/TraversaMB.SLDPRT

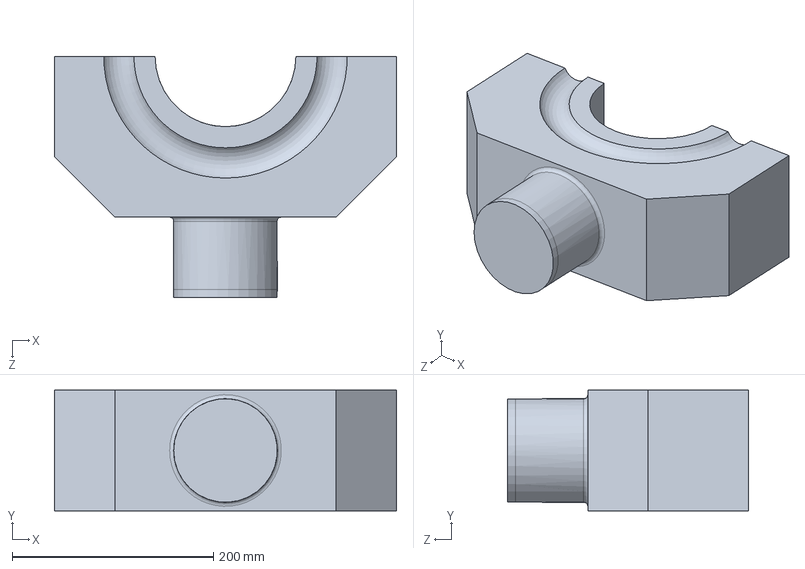
[picture p62: CAD file, 2020-09-05]
SolidWorks/Simulazioni/MezzoBozzello/TraversaMB.SLDPRT
340.0 x 120.0 x 240.0 mm
