arma966/ProgettazioneMeccanica2020/SolidWorks/Simulazioni/Quarto/GancioQ.SLDPRT

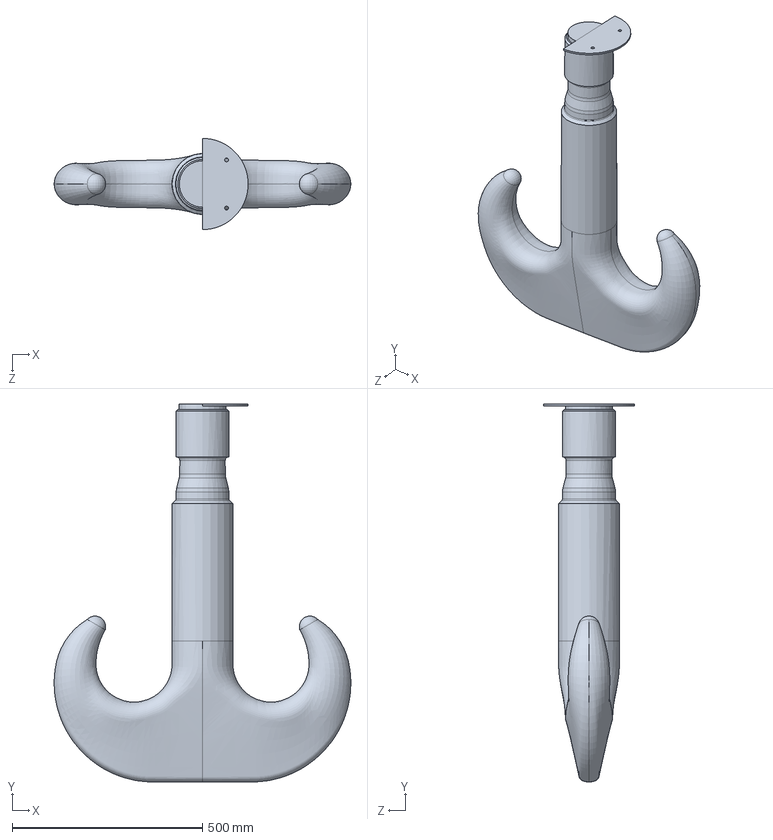
[picture p63: CAD file, 2020-09-05]
SolidWorks/Simulazioni/Quarto/GancioQ.SLDPRT
779.9 x 993.6 x 240.0 mm
