arma966/ProgettazioneMeccanica2020/SolidWorks/Piastrone.SLDPRT

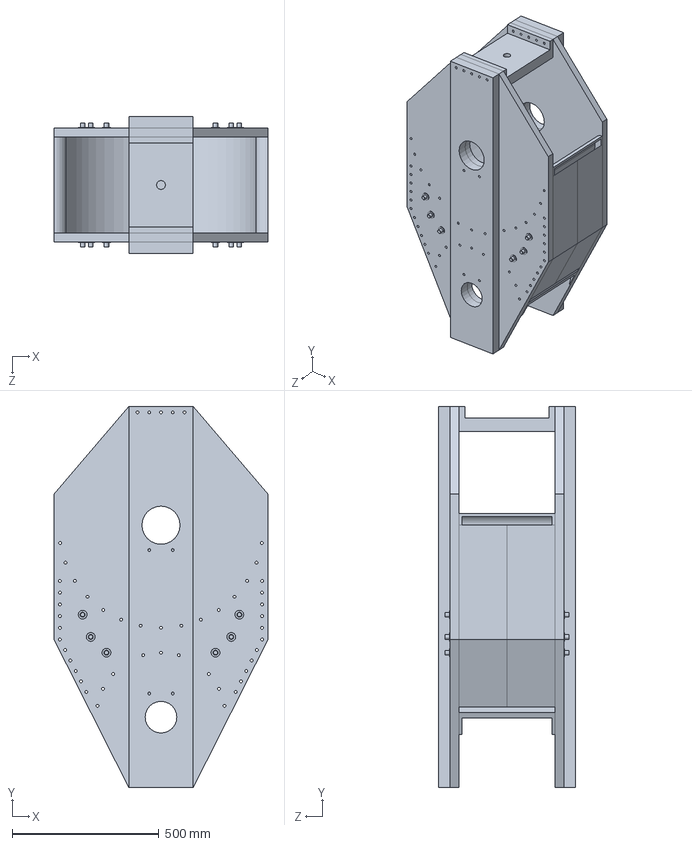
[picture p64: CAD file, 2020-09-05]
SolidWorks/Piastrone.SLDPRT
730.0 x 1300.0 x 468.0 mm
