arma966/ProgettazioneMeccanica2020/SolidWorks/Ref/YT_Lamierapiegata.SLDPRT

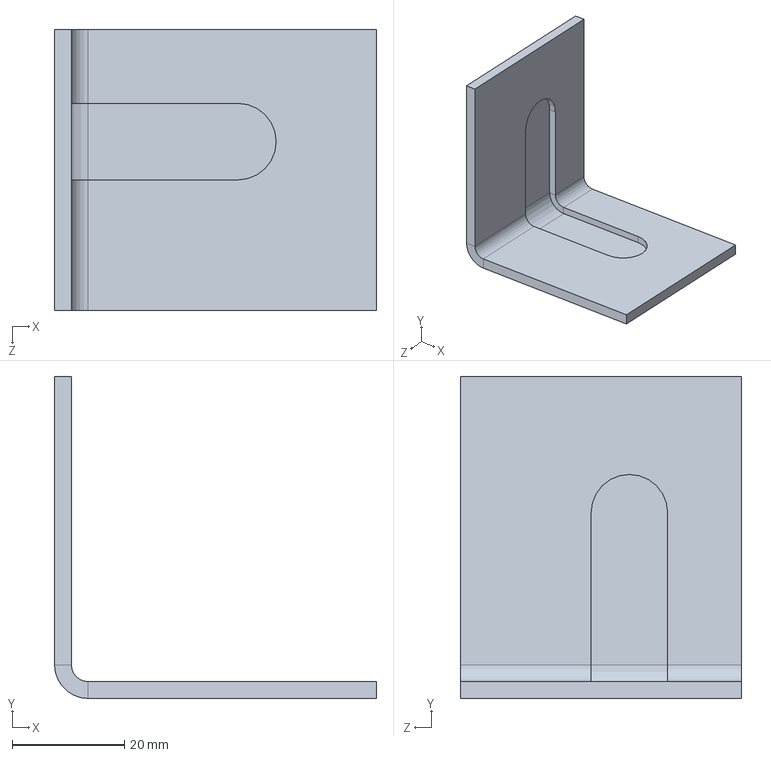
[picture p65: CAD file, 2020-09-05]
SolidWorks/Ref/YT_Lamierapiegata.SLDPRT
57.3 x 57.3 x 50.0 mm
