arma966/ProgettazioneMeccanica2020/SolidWorks/Simulazioni/MezzoBozzello/AsseMB.SLDPRT

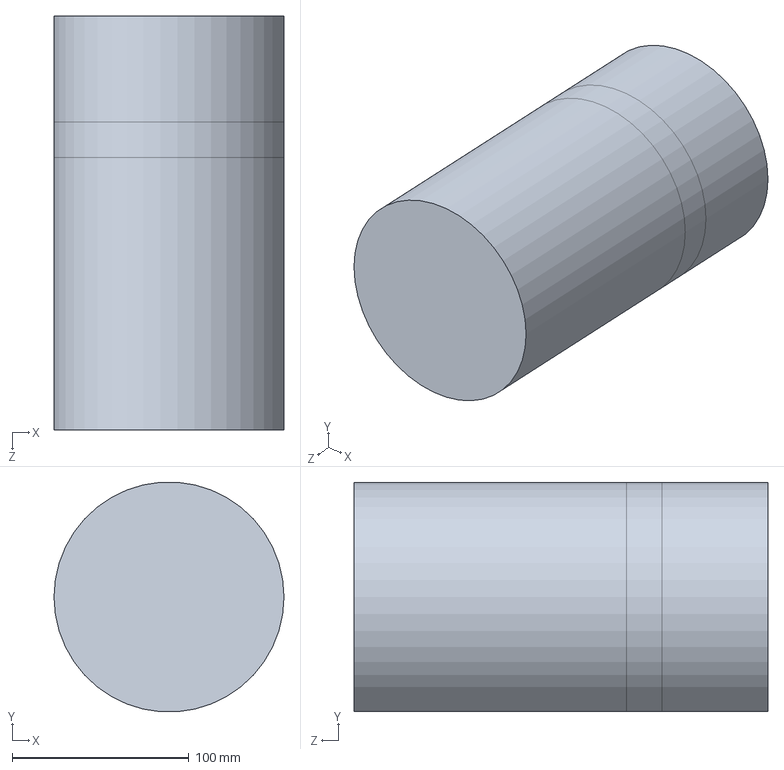
[picture p66: CAD file, 2020-09-05]
SolidWorks/Simulazioni/MezzoBozzello/AsseMB.SLDPRT
130.0 x 129.6 x 234.0 mm
