arma966/ProgettazioneMeccanica2020/SolidWorks/Simulazioni/Quarto/PiastroneQ.SLDPRT

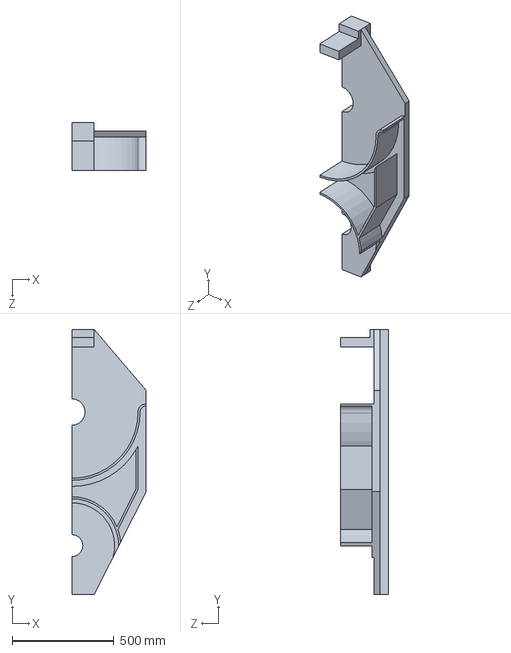
[picture p67: CAD file, 2020-09-05]
SolidWorks/Simulazioni/Quarto/PiastroneQ.SLDPRT
365.0 x 1300.0 x 234.0 mm
