arma966/ProgettazioneMeccanica2020/SolidWorks/Simulazioni/TraversaSim.SLDPRT

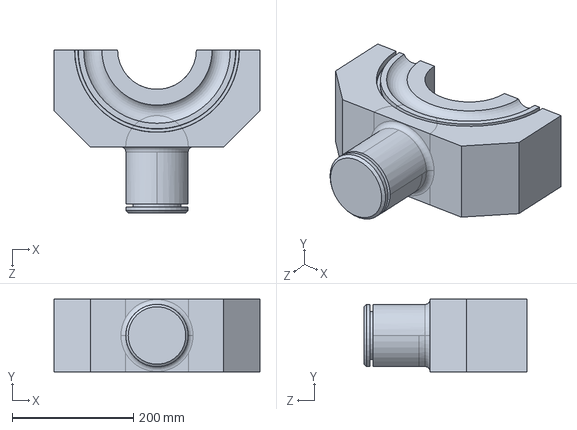
[picture p68: CAD file, 2020-09-05]
SolidWorks/Simulazioni/TraversaSim.SLDPRT
340.0 x 120.0 x 269.0 mm
