arma966/ProgettazioneMeccanica2020/SolidWorks/Asse.SLDPRT

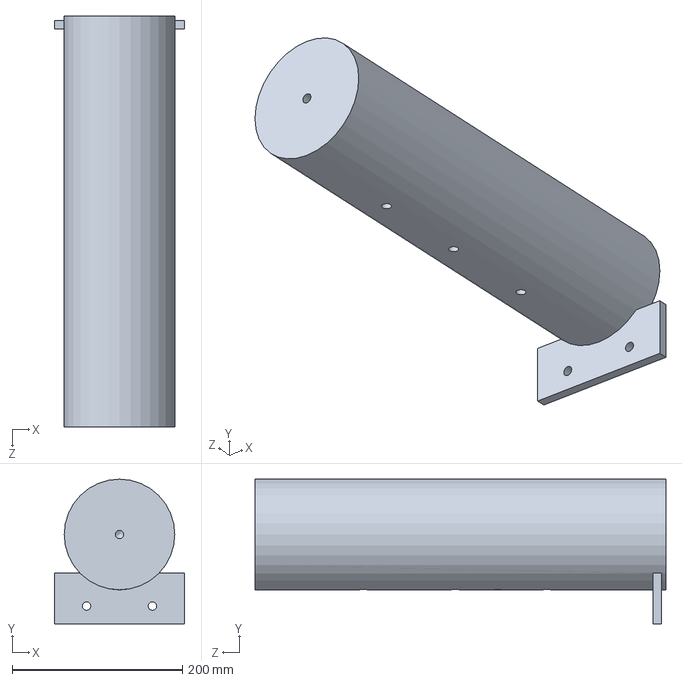
[picture p69: CAD file, 2020-09-05]
SolidWorks/Asse.SLDPRT
153.1 x 170.0 x 483.0 mm
