arma966/ProgettazioneMeccanica2020/SolidWorks/Ref/YT_Rondella.SLDPRT

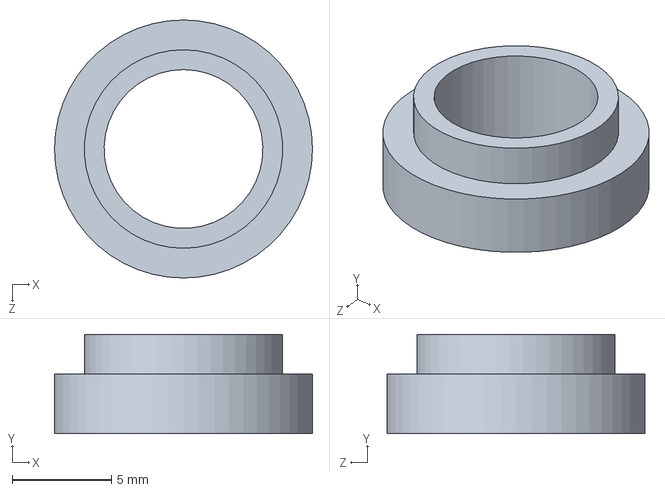
[picture p70: CAD file, 2020-09-05]
SolidWorks/Ref/YT_Rondella.SLDPRT
13.0 x 5.00 x 13.0 mm
