arma966/ProgettazioneMeccanica2020/SolidWorks/Simulazioni/GamboSim.SLDPRT

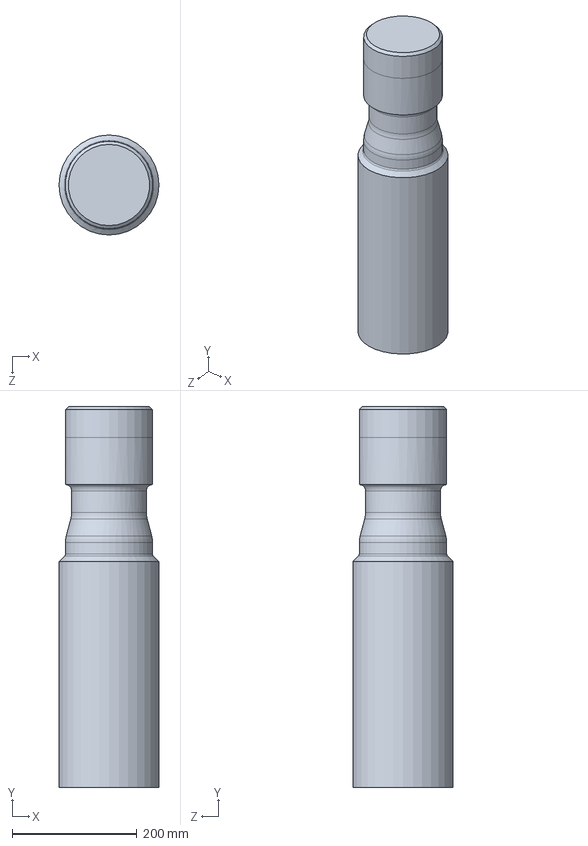
[picture p71: CAD file, 2020-09-05]
SolidWorks/Simulazioni/GamboSim.SLDPRT
160.0 x 609.6 x 160.0 mm
