arma966/ProgettazioneMeccanica2020/SolidWorks/Simulazioni/MezzoBozzello/PiastroneMB.SLDPRT

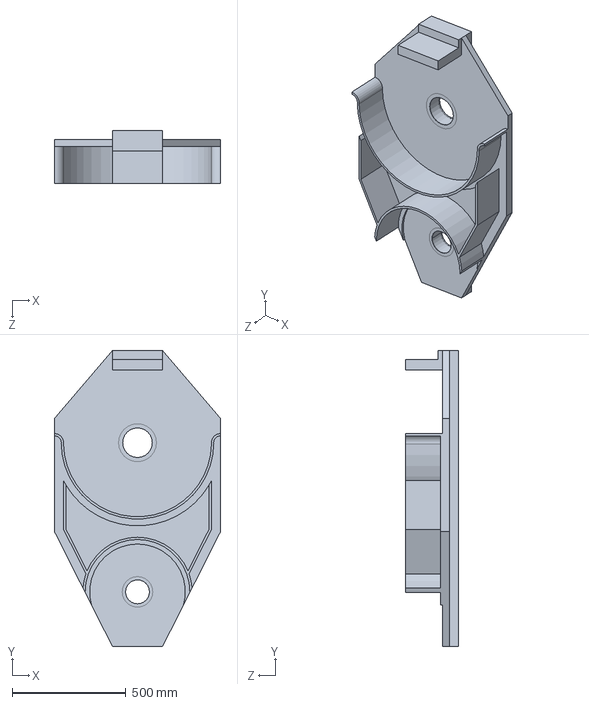
[picture p72: CAD file, 2020-09-05]
SolidWorks/Simulazioni/MezzoBozzello/PiastroneMB.SLDPRT
730.0 x 1300.0 x 234.0 mm
