arma966/ProgettazioneMeccanica2020/SolidWorks/Simulazioni/Quarto/PuleggiaMezzaQ.SLDPRT

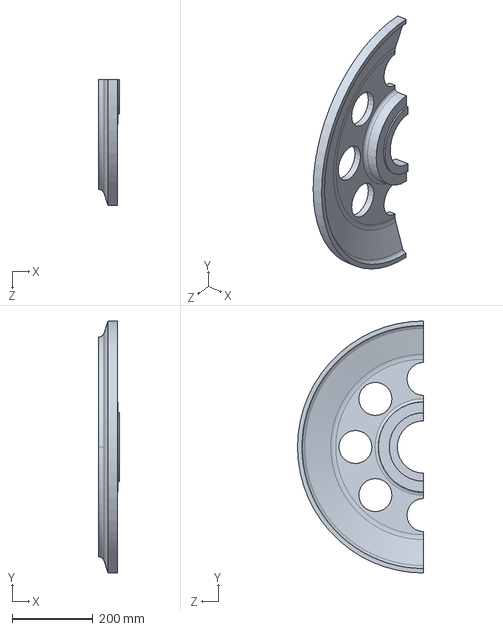
[picture p73: CAD file, 2020-09-05]
SolidWorks/Simulazioni/Quarto/PuleggiaMezzaQ.SLDPRT
52.9 x 625.0 x 312.5 mm
