arma966/ProgettazioneMeccanica2020/SolidWorks/Simulazioni/GancioSim.SLDPRT

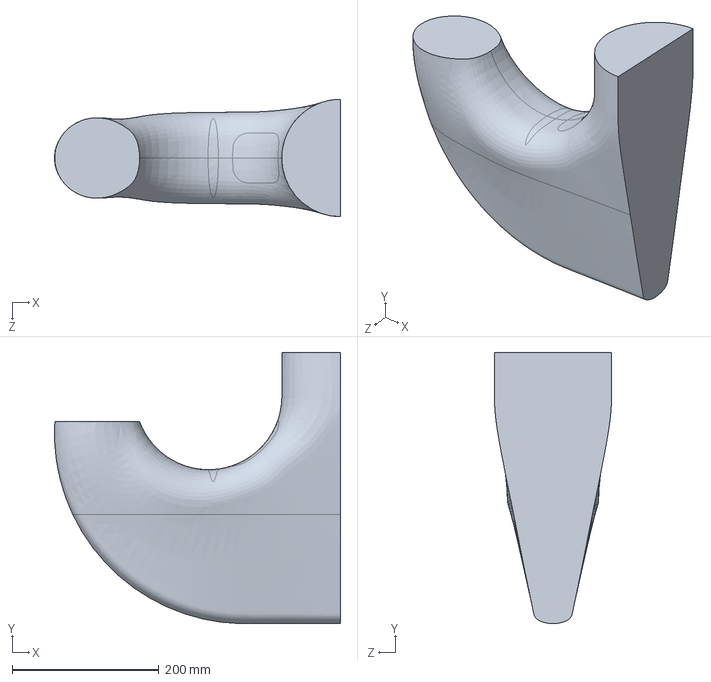
[picture p74: CAD file, 2020-09-05]
SolidWorks/Simulazioni/GancioSim.SLDPRT
389.9 x 370.0 x 160.2 mm
