arma966/ProgettazioneMeccanica2020/SolidWorks/Simulazioni/Quarto/TraversaQ.SLDPRT

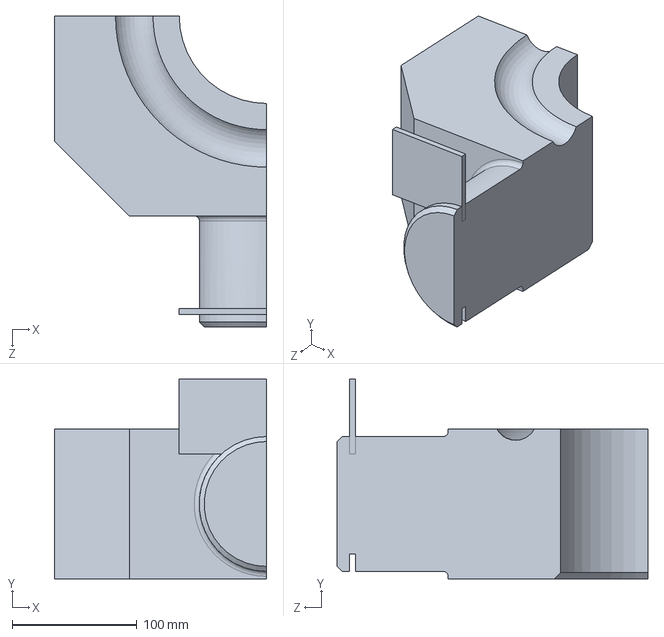
[picture p75: CAD file, 2020-09-05]
SolidWorks/Simulazioni/Quarto/TraversaQ.SLDPRT
170.0 x 160.0 x 249.0 mm
