arma966/ProgettazioneMeccanica2020/SolidWorks/M10 - 50mm.SLDPRT

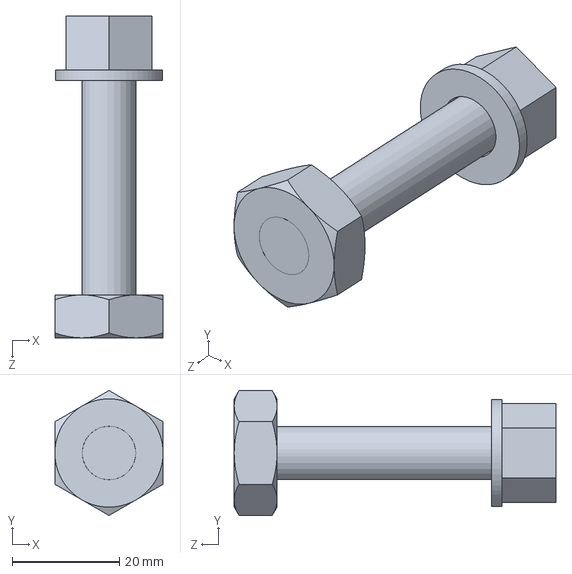
[picture p76: CAD file, 2020-09-05]
SolidWorks/M10 - 50mm.SLDPRT
20.2 x 23.3 x 60.0 mm
