arma966/ProgettazioneMeccanica2020/SolidWorks/Simulazioni/Quarto/BoccolaQ.SLDPRT

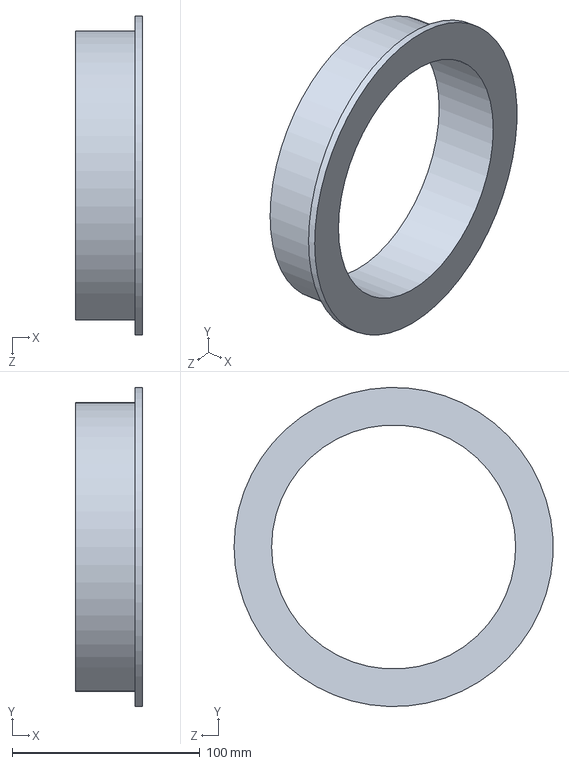
[picture p77: CAD file, 2020-09-05]
SolidWorks/Simulazioni/Quarto/BoccolaQ.SLDPRT
35.5 x 169.9 x 169.9 mm
