arma966/ProgettazioneMeccanica2020/SolidWorks/Simulazioni/Quarto/PuleggiaQ.SLDPRT

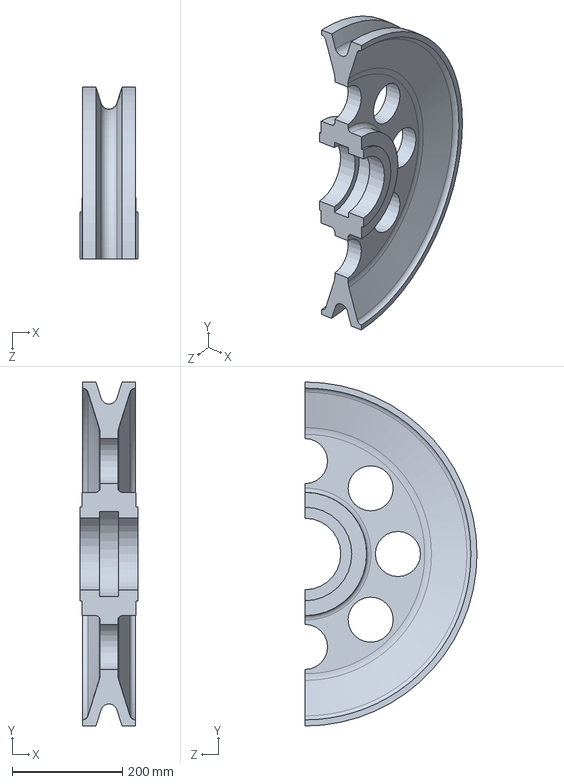
[picture p78: CAD file, 2020-09-05]
SolidWorks/Simulazioni/Quarto/PuleggiaQ.SLDPRT
105.8 x 625.0 x 312.5 mm
