arma966/ProgettazioneMeccanica2020/SolidWorks/Dado.SLDPRT

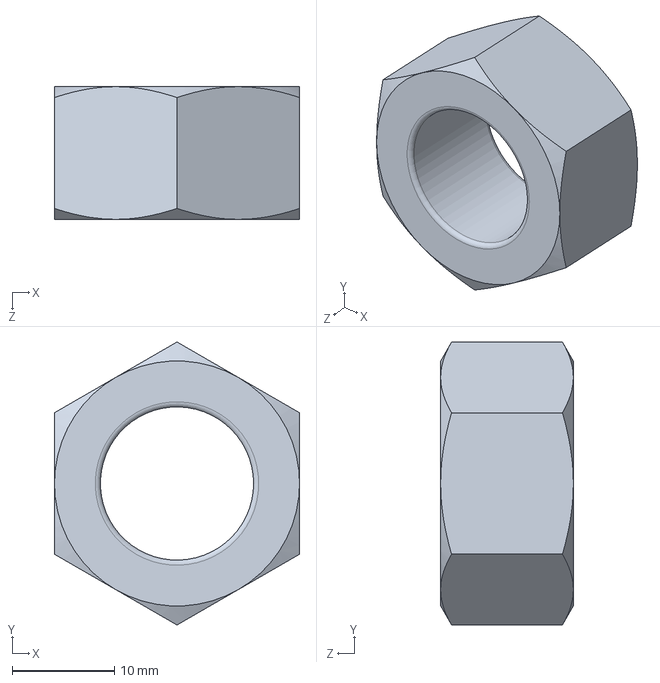
[picture p79: CAD file, 2020-09-05]
SolidWorks/Dado.SLDPRT
24.0 x 27.7 x 13.0 mm
