arma966/ProgettazioneMeccanica2020/SolidWorks/Simulazioni/Quarto/AsseQ.SLDPRT

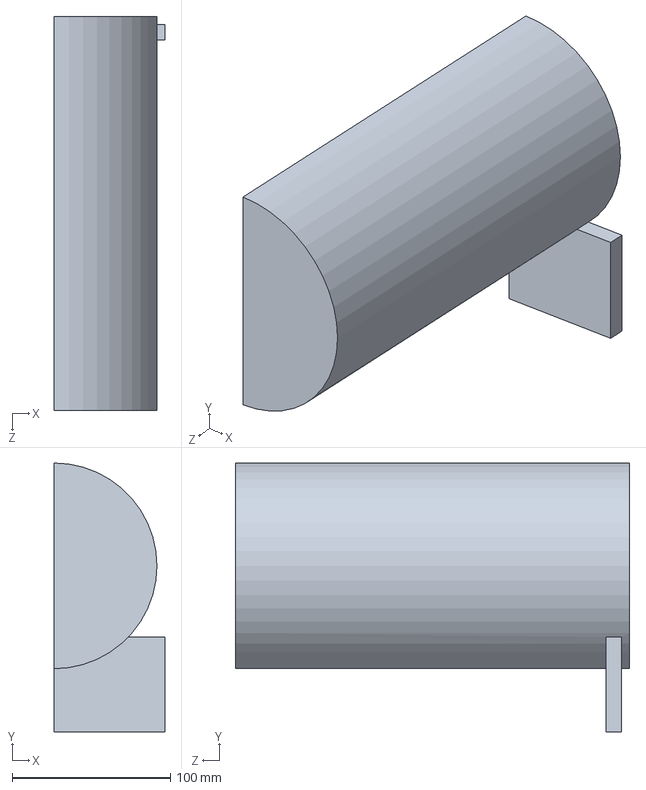
[picture p80: CAD file, 2020-09-05]
SolidWorks/Simulazioni/Quarto/AsseQ.SLDPRT
70.0 x 170.0 x 249.0 mm
