arma966/ProgettazioneMeccanica2020/SolidWorks/Traversa.SLDPRT

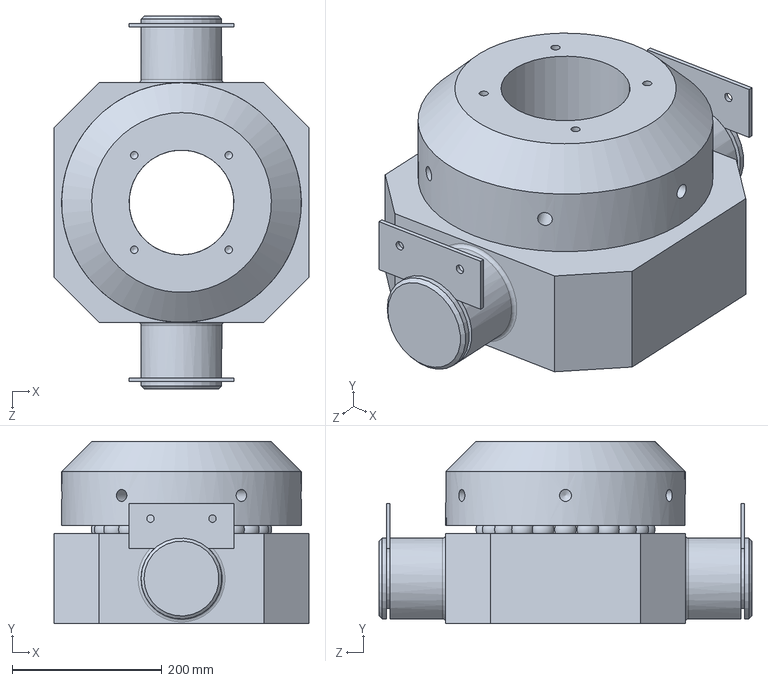
[picture p81: CAD file, 2020-09-05]
SolidWorks/Traversa.SLDPRT
340.0 x 243.0 x 498.0 mm
