arma966/ProgettazioneMeccanica2020/SolidWorks/M10 - Mordente.SLDPRT

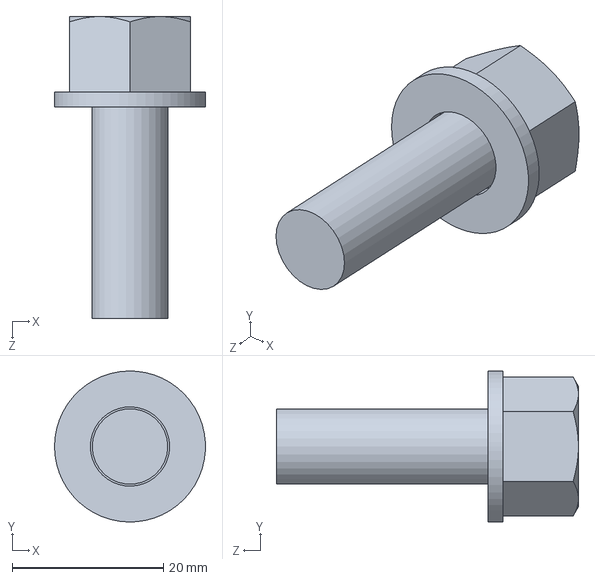
[picture p82: CAD file, 2020-09-05]
SolidWorks/M10 - Mordente.SLDPRT
20.0 x 20.0 x 40.0 mm
