arma966/ProgettazioneMeccanica2020/SolidWorks/Gancio.SLDPRT

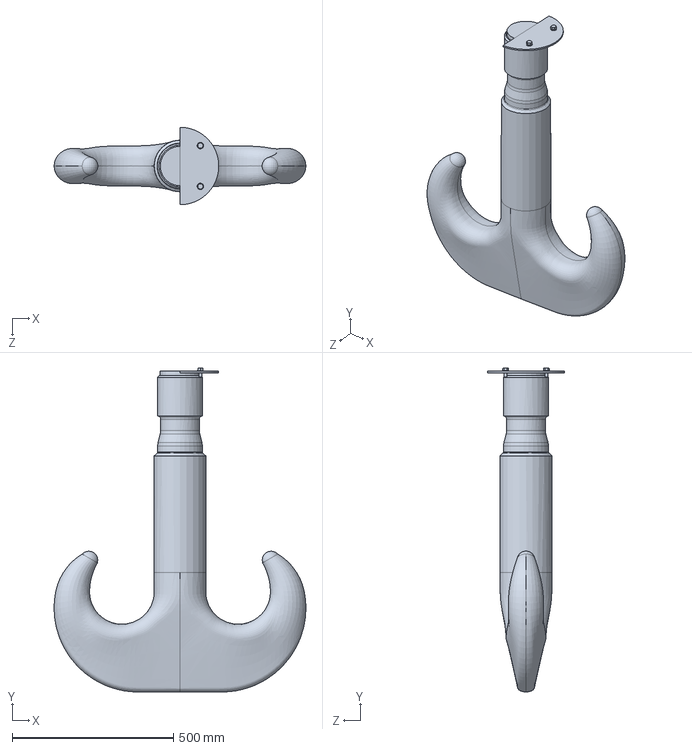
[picture p83: CAD file, 2020-09-05]
SolidWorks/Gancio.SLDPRT
779.9 x 1003.6 x 240.0 mm
