arma966/ProgettazioneMeccanica2020/SolidWorks/Golfare.SLDPRT

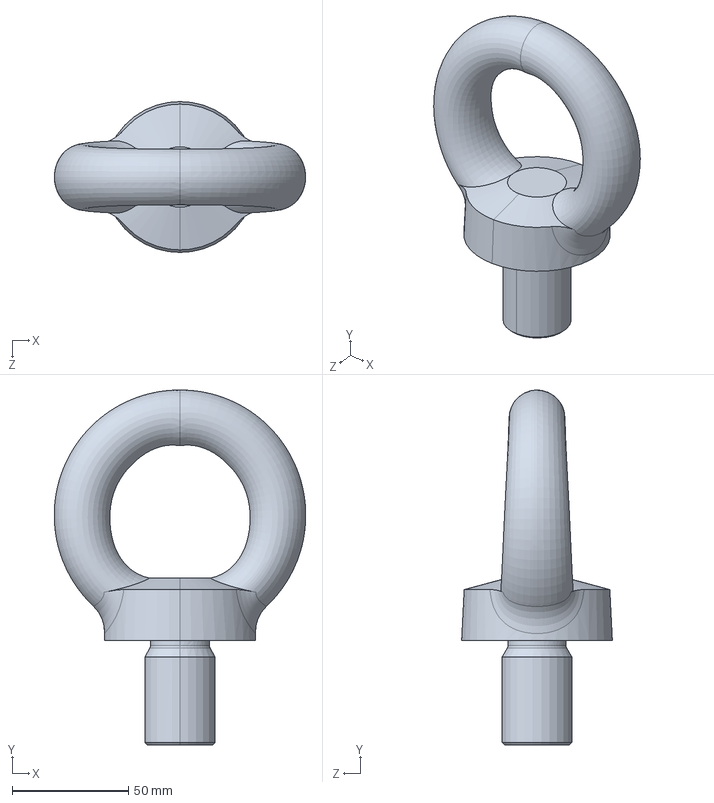
[picture p84: CAD file, 2020-09-05]
SolidWorks/Golfare.SLDPRT
108.4 x 153.0 x 65.0 mm
