arma966/ProgettazioneMeccanica2020/SolidWorks/M10 - Media.SLDPRT

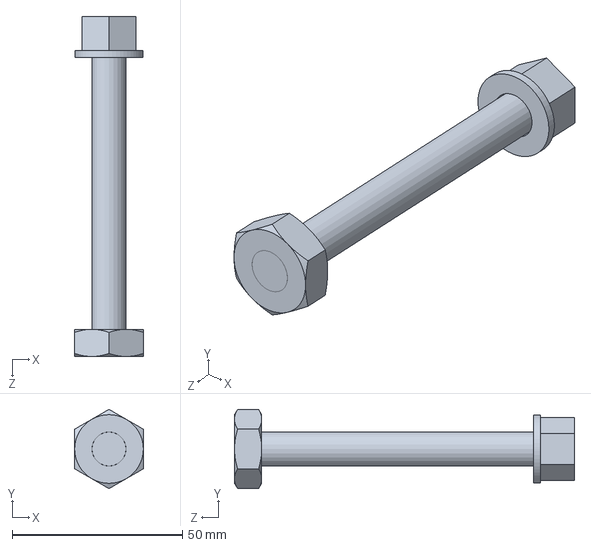
[picture p85: CAD file, 2020-09-05]
SolidWorks/M10 - Media.SLDPRT
20.2 x 23.3 x 100.0 mm
