arma966/ProgettazioneMeccanica2020/SolidWorks/Puleggia.SLDPRT

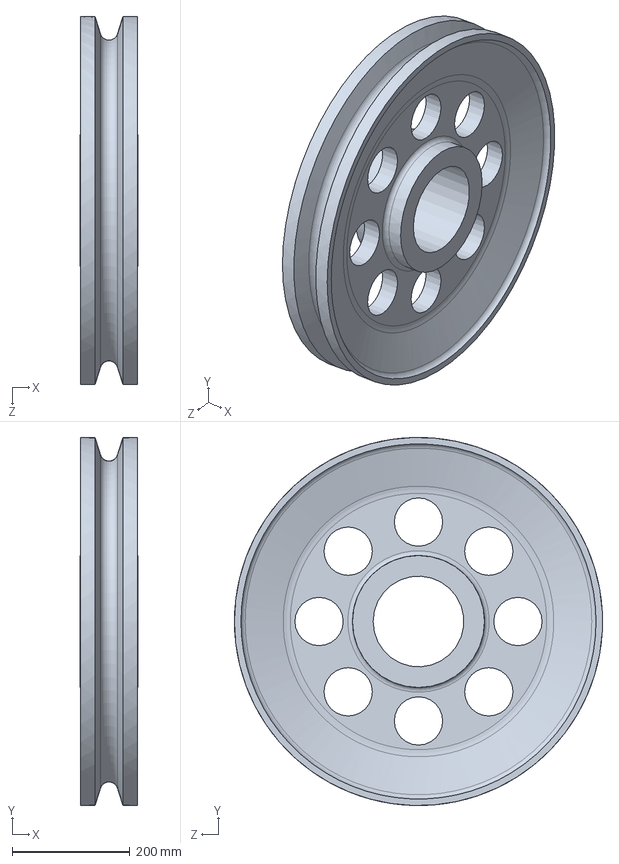
[picture p86: CAD file, 2020-09-05]
SolidWorks/Puleggia.SLDPRT
97.8 x 624.7 x 625.0 mm
