arma966/ProgettazioneMeccanica2020/(list of files, cad)

Other CAD files:
SolidWorks/M10 - Corta.SLDPRT
SolidWorks/Boccola.SLDPRT
Relazione/Doc/Asse.SLDPRT
Relazione/Doc/Piastrone.SLDPRT
Relazione/Doc/Traversa.SLDPRT
