arma966/ProgettazioneMeccanica2020/Mathcad/Verifica asse_print.pdf

dc≔120 mm

div≔500

dl≔10 mm

R≔―

dc
2

r≔―

dl
2
H≔ | =

R −

2
r

2
59.791 mm
SA2x≔ | =

⌠
⌡ | d

0

H
y⋅

⎛
⎝ | −

R −

2
y

2

| r ⎞
| ⎠ y 63020.811 mm

3

A2≔ | =

⌠
⌡ | d

0

R r −
⎛
⎝ | −

R −

2
y

2
r

⎞
⎠ y 2471.812 mm

2

yG2≔――=

SA2x
A2

25.496 mm

h≔6 mm

AI≔―⋅ | =

1
4 | ―――

π⋅dc

2
4

⎛
⎝2.827 10 ⋅

3 ⎞
⎠ mm

2

AII≔―⋅ =

dl
2 | h 30 mm

2

AIII≔―⋅ | ⋅ | ⋅ | =

1
2 | ―

dl
2
| | ―

dl
2
| | | tan(30 deg) 7.217 mm

2

A1≔AI AII AIII − | − | =2790.217 mm

2

yGI≔―⋅ =

2
3

―

dc
π

25.465 mm

yGII≔―=

h
2

### 3 mm

yGIII≔h+―⋅ | ⋅ =

dl

2 | tan(30 deg) ―1
| 3 6.962 mm

yG1≔――――――――――=

yGI ⋅AI−yGII ⋅AII−yGIII ⋅AIII

A1

| 25.754 mm

ypG≔―――――=

A ⋅ 2

⎛⎝yG1+yG2⎞⎠ A1+A2 | 24.074 mm

yG≔yG1−ypG =1.68 mm

JA2n≔2⋅ | =

⌠
⎮⌡ | d

0

H y + G

y ⋅

2

⎛
⎝ | −

R −

2
⎛⎝y y − G

⎞⎠

2
r

⎞
⎠ y

⎛
⎝4.81 10 ⋅

6 ⎞
⎠ mm

4

JA1pn≔ ⋅2 | =

⌠
⎮⌡

d

0

R y − G

y ⋅

2 ⎛
⎝ | −

R −

2
⎛⎝y y + G

⎞⎠

2
r

⎞
⎠ y

⎛
⎝3.96 10 ⋅

6 ⎞
⎠ mm

4

Jrn≔――――+ | =

d ⋅l

⎛⎝h y − G

⎞⎠

3

12

⎛⎝h y − G

⎞⎠ ⋅d ⋅l

⎛
⎜
⎝
| ―――

h y − G
2

⎞
⎟
⎠

2
268.783 mm

4

JTn≔―――――――+ | =

d ⋅l

(r ⋅ tan(30 deg))

3

36

――――――⋅

d ⋅ ⋅ l

r tan(30 deg)
2

⎛
⎜
⎝

―――――+

r ⋅ tan(30 deg)
3

⎛⎝h y − G

⎞⎠

⎞
⎟
⎠

2
409.452 mm

4

JACn≔JA2n+JA1pn−Jrn−JTn=⎛
⎝8.769 10 ⋅

6 ⎞
⎠ mm

4

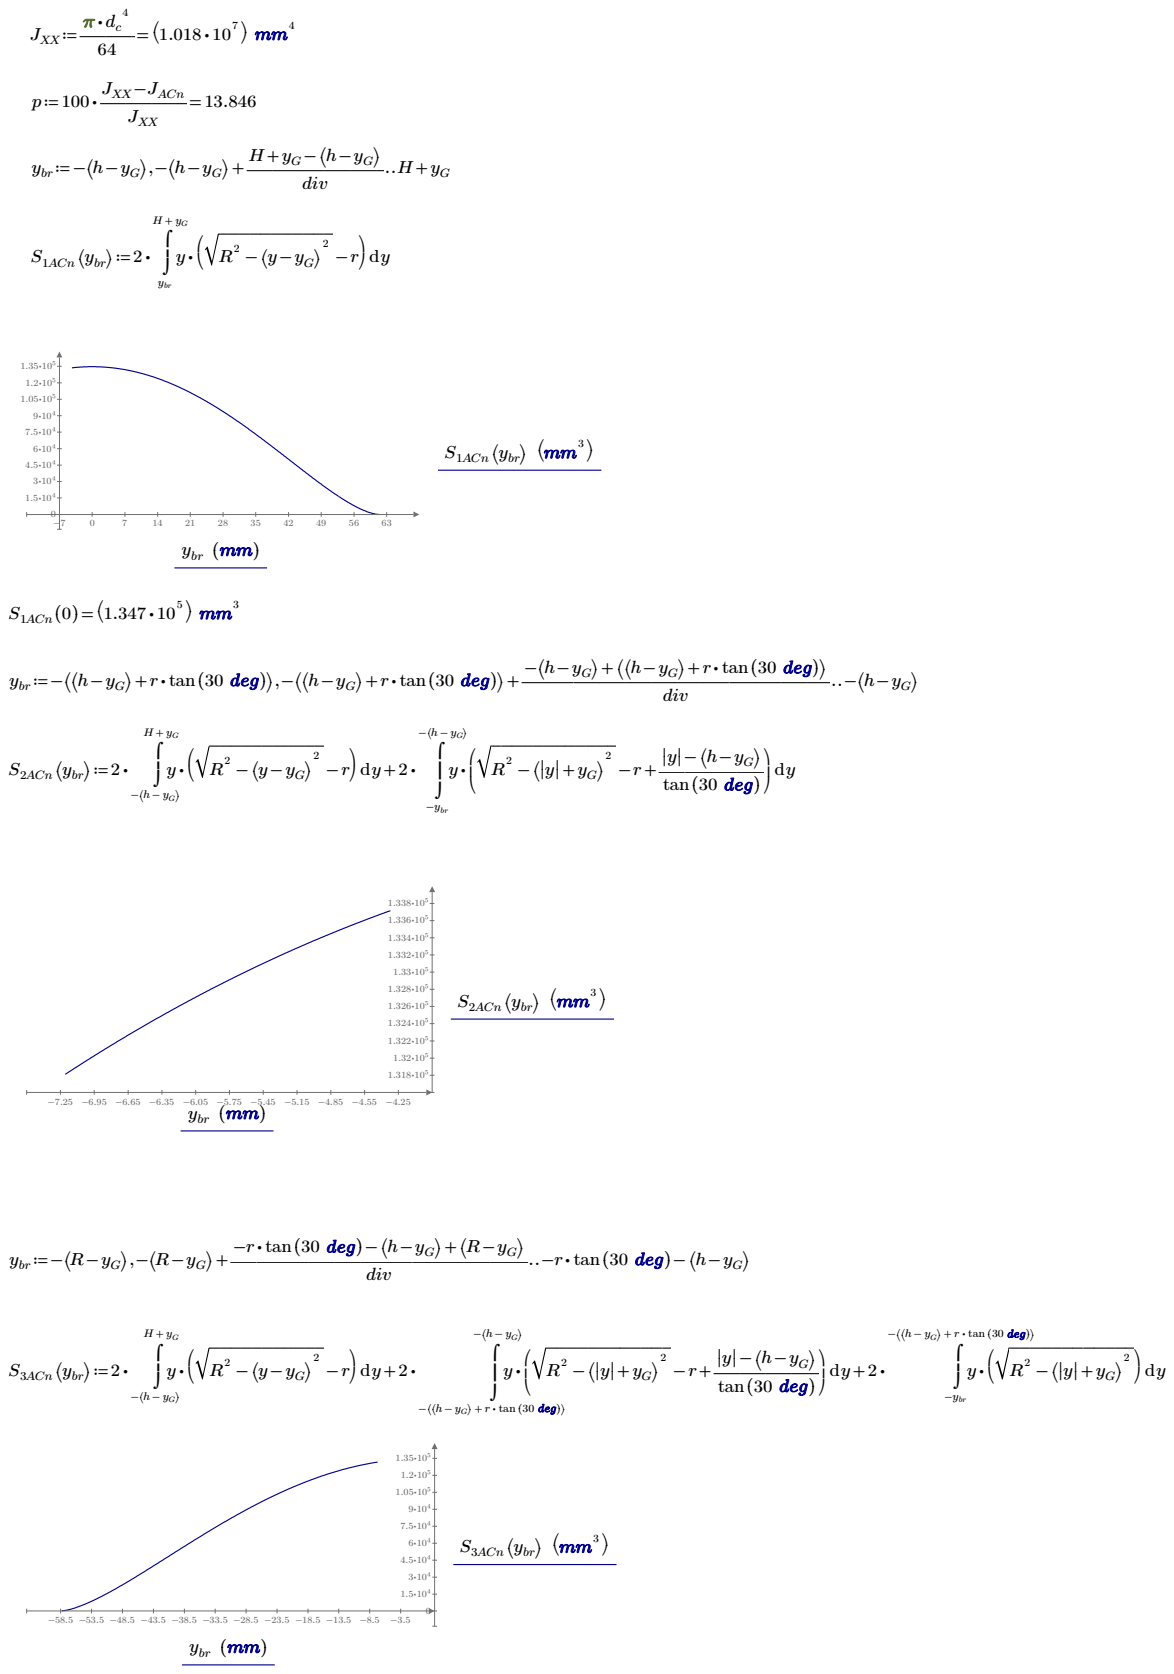
[picture p102: page 2]
JXX≔―――=; JXX −JACn; JXX; ybr≔−⎛⎝h y − G; div; S1ACn ⎛⎝ybr⎞⎠≔2 ⋅; ybr; ybr (mm); S1ACn ⎛⎝ybr⎞⎠; S1ACn (0)=⎛ ⎝1.347 10 ⋅; ybr≔−⎛⎝; ⎛⎝h y − G⎞⎠+r ⋅ tan(30 deg)⎞⎠,−⎛⎝; ⎛⎝h y − G⎞⎠+r ⋅ tan(30 deg)⎞⎠+――――――――――――‥; ⎞⎠+r ⋅ tan(30 deg)⎞⎠; S2ACn ⎛⎝ybr⎞⎠≔2⋅; −ybr; ⎞⎠ tan(30 deg); -7.25 -6.95 -6.65 -6.35 -6.05 -5.75 -5.45 -5.15 -4.85 -4.55 -4.25 ybr (mm); S2ACn ⎛⎝ybr⎞⎠; ybr≔−⎛⎝R y − G; −r ⋅ tan(30 deg)−⎛⎝h y − G; S3ACn ⎛⎝ybr⎞⎠≔2⋅; y − G⎞⎠ + r ⋅ tan (30 deg)⎞⎠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

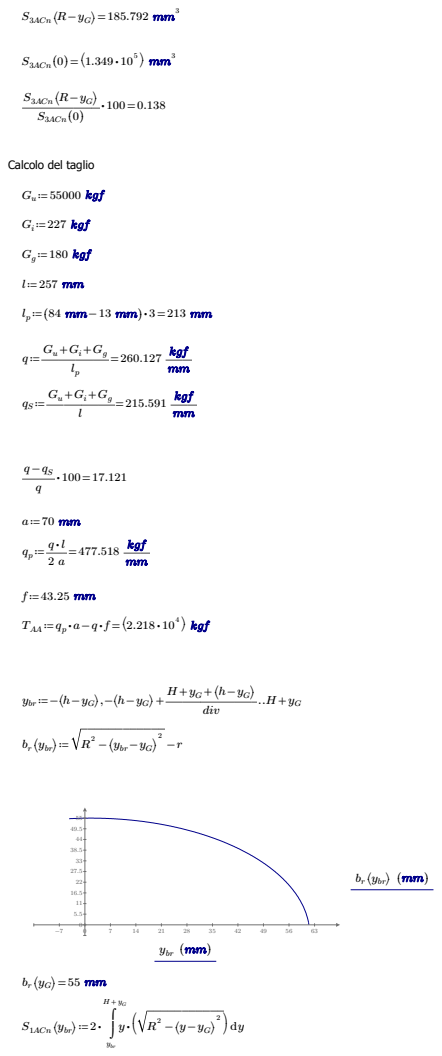
[picture p103: page 3]
S3ACn ⎛⎝R y − G; S3ACn (0)=⎛ ⎝1.349 10 ⋅; S3ACn (0); Gu≔55000 kgf; Gi≔227 kgf; Gg≔180 kgf; 260.127 ―kgf―mm; 215.591 ―kgf―mm; 477.518 ―kgf―mm; TAA≔qp; 4 ⎞ ⎠ kgf; ybr≔−⎛⎝h y − G; div; ⎛⎝ybr⎞⎠≔; ⎛⎝ybr−yG; ybr (mm); ⎛⎝ybr⎞⎠; S1ACn ⎛⎝ybr⎞⎠≔ ⋅2; ybr

Calcolo del taglio

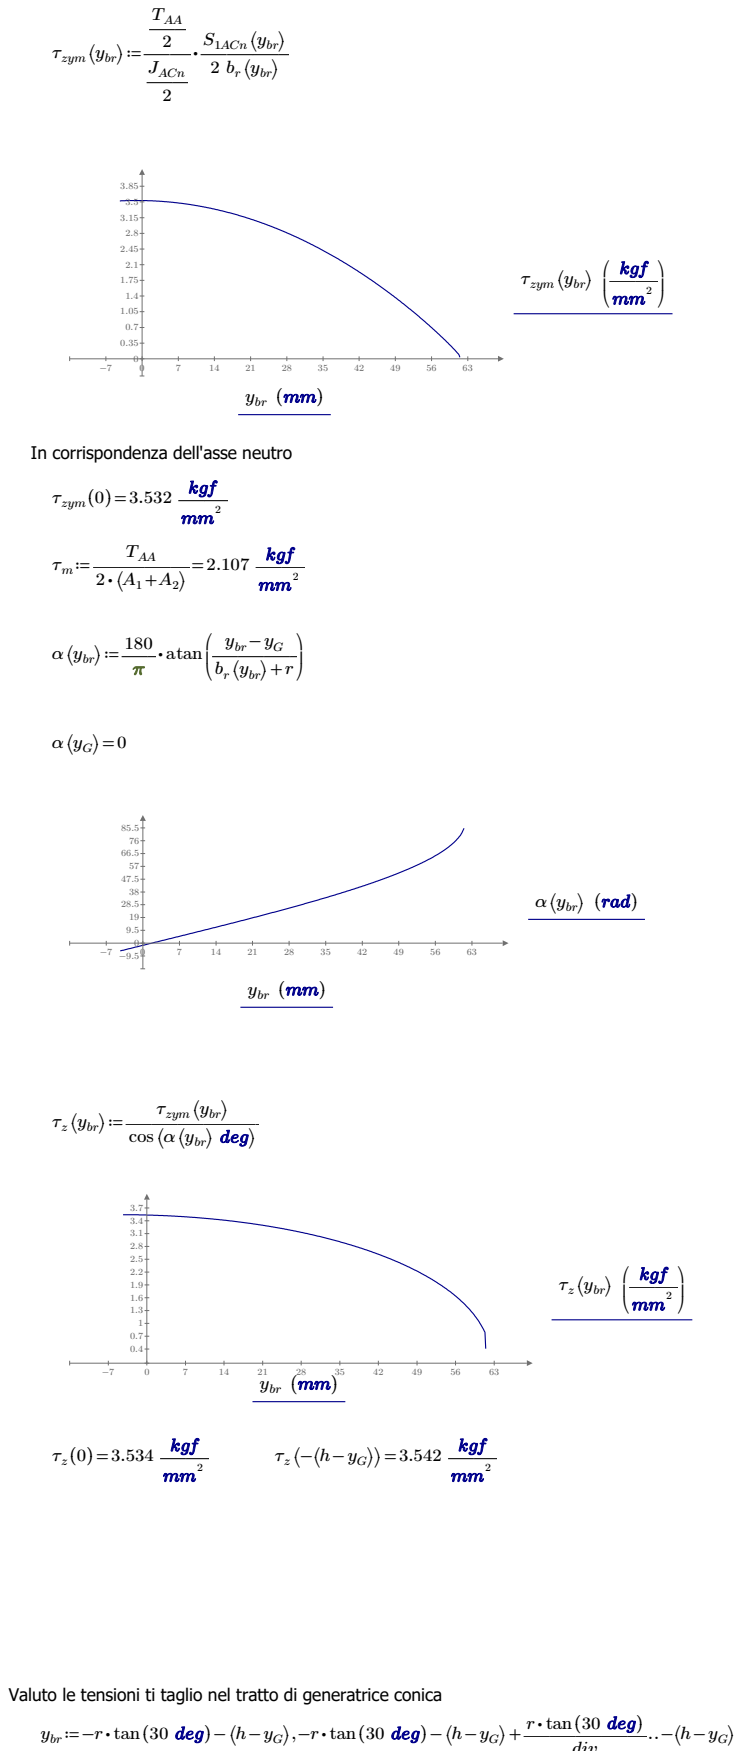
[picture p104: page 4]
τzym ⎛⎝ybr⎞⎠≔――⋅; TAA 2; JACn 2; S1ACn ⎛⎝ybr⎞⎠ 2 br; ⎛⎝ybr⎞⎠; ybr (mm); τzym ⎛⎝ybr⎞⎠; ―kgf―mm; TAA 2⋅ ⎛⎝A1+A2; 2.107 ―kgf―mm; α⎛⎝ybr⎞⎠≔――⋅; atan; ybr−yG; ⎛⎝ybr⎞⎠+r; α⎛⎝ybr⎞⎠; (rad); ⎛⎝ybr⎞⎠≔――――――; (0)=3.534 ―kgf―mm; ⎞⎠=3.542 ―kgf―mm; ⎞⎠,−r ⋅ tan(30 deg)−⎛⎝h y − G; r ⋅ tan(30 deg); div

In corrispondenza dell'asse neutro
τzym (0)=3.532 ―kgf―mm

τzym ⎛⎝ybr⎞⎠
cos ⎛⎝α⎛⎝ybr⎞⎠ deg⎞⎠

Valuto le tensioni ti taglio nel tratto di generatrice conica
ybr≔−r ⋅ tan(30 deg)−⎛⎝h y − G

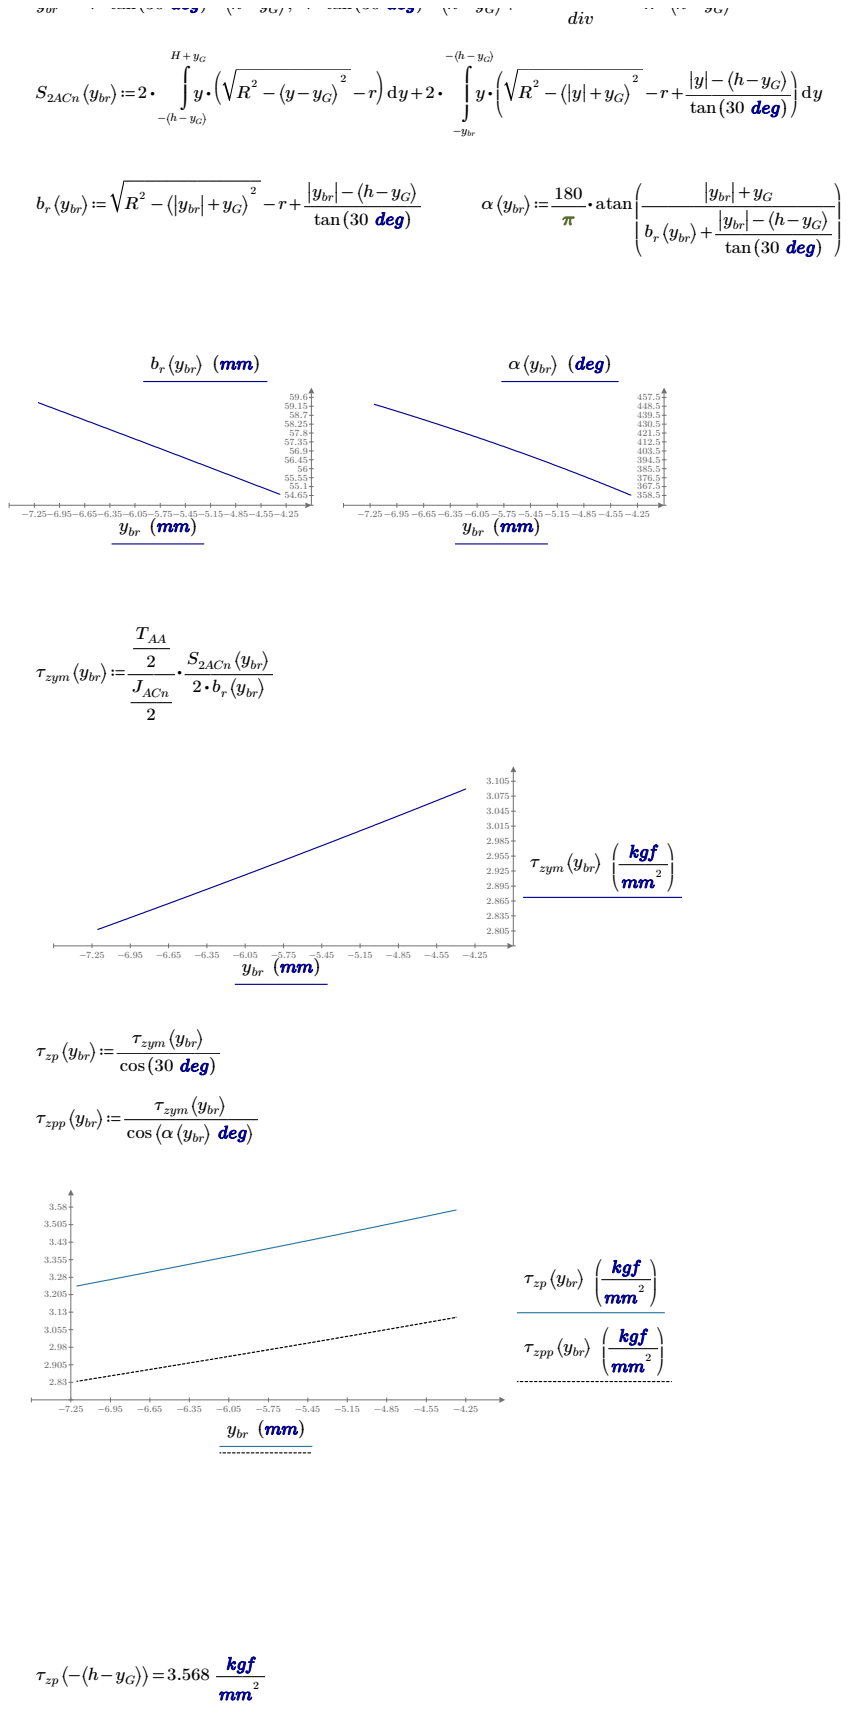
[picture p105: page 5]
div; S2ACn ⎛⎝ybr⎞⎠≔ ⋅2; −ybr; ⎞⎠ tan(30 deg); ⎛⎝ybr⎞⎠≔; ||ybr||+yG; ||ybr||−⎛⎝h y − G ⎞⎠ tan(30 deg); α⎛⎝ybr⎞⎠≔――⋅; atan; ⎛⎝ybr⎞⎠+―――――; ||ybr||−⎛⎝h y − G; -7.25-6.95-6.65-6.35-6.05-5.75-5.45-5.15-4.85-4.55-4.25 ybr (mm); ⎛⎝ybr⎞⎠; -7.25 -6.95 -6.65 -6.35 -6.05 -5.75 -5.45 -5.15 -4.85 -4.55 -4.25 ybr (mm); α⎛⎝ybr⎞⎠; (deg); τzym ⎛⎝ybr⎞⎠≔――⋅; TAA 2; JACn 2; S2ACn ⎛⎝ybr⎞⎠ ⋅2 br; ybr (mm); τzym ⎛⎝ybr⎞⎠; ―kgf―mm; τzp ⎛⎝ybr⎞⎠≔――――; τzym ⎛⎝ybr⎞⎠ cos (30 deg); τzpp ⎛⎝ybr⎞⎠≔――――――; τzp ⎛⎝ybr⎞⎠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

τzym ⎛⎝ybr⎞⎠
cos ⎛⎝α⎛⎝ybr⎞⎠ deg⎞⎠

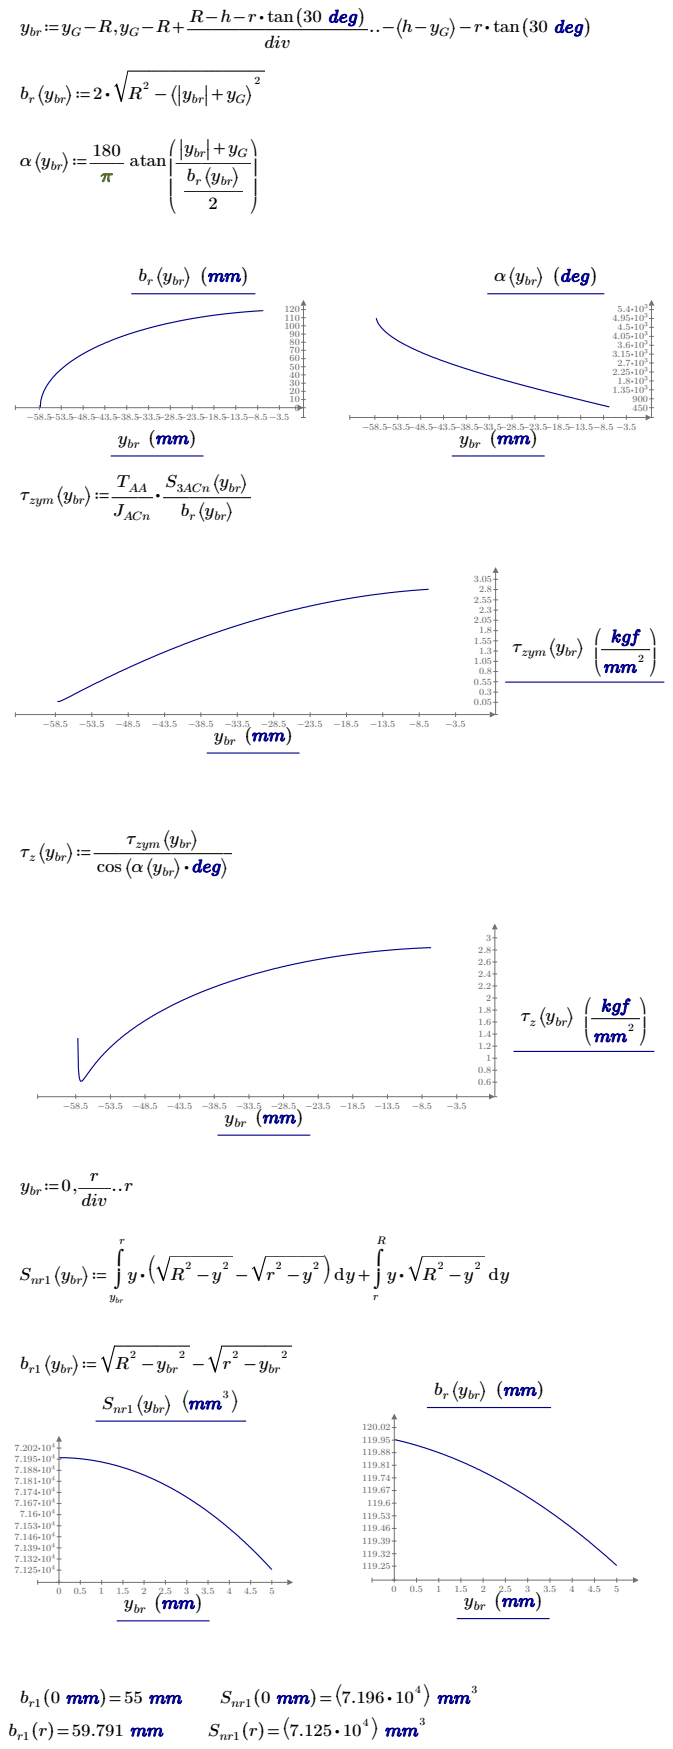
[picture p106: page 6]
ybr≔yG −R,; ‥ yG −R+―R h −―−―r ⋅―tan―(30―deg―); div; ⎞⎠−r ⋅ tan(30 deg); ⎛⎝ybr⎞⎠≔2⋅; ||ybr||+yG; α⎛⎝ybr⎞⎠≔―180―π atan; ⎛⎝ybr⎞⎠ 2; -58.5-53.5-48.5-43.5-38.5-33.5-28.5-23.5-18.5-13.5-8.5 -3.5 ybr (mm); ⎛⎝ybr⎞⎠; α⎛⎝ybr⎞⎠; (deg); τzym ⎛⎝ybr⎞⎠≔――⋅; TAA; JACn; S3ACn ⎛⎝ybr⎞⎠; ybr (mm); τzym ⎛⎝ybr⎞⎠; ―kgf―mm; ⎛⎝ybr⎞⎠≔――――――; cos ⎛⎝α⎛⎝y; ⋅ br⎞⎠ deg⎞⎠; ybr≔0,――‥; Snr1 ⎛⎝ybr⎞⎠≔; ybr; 0 0.5 1 1.5 2 2.5 3 3.5 4 4.5 5 ybr (mm); Snr1 ⎛⎝ybr⎞⎠; br1 ⎛⎝ybr⎞⎠≔; Snr1 (0 mm)=⎛; Snr1 (r)=⎛ ⎝7.125 10 ⋅

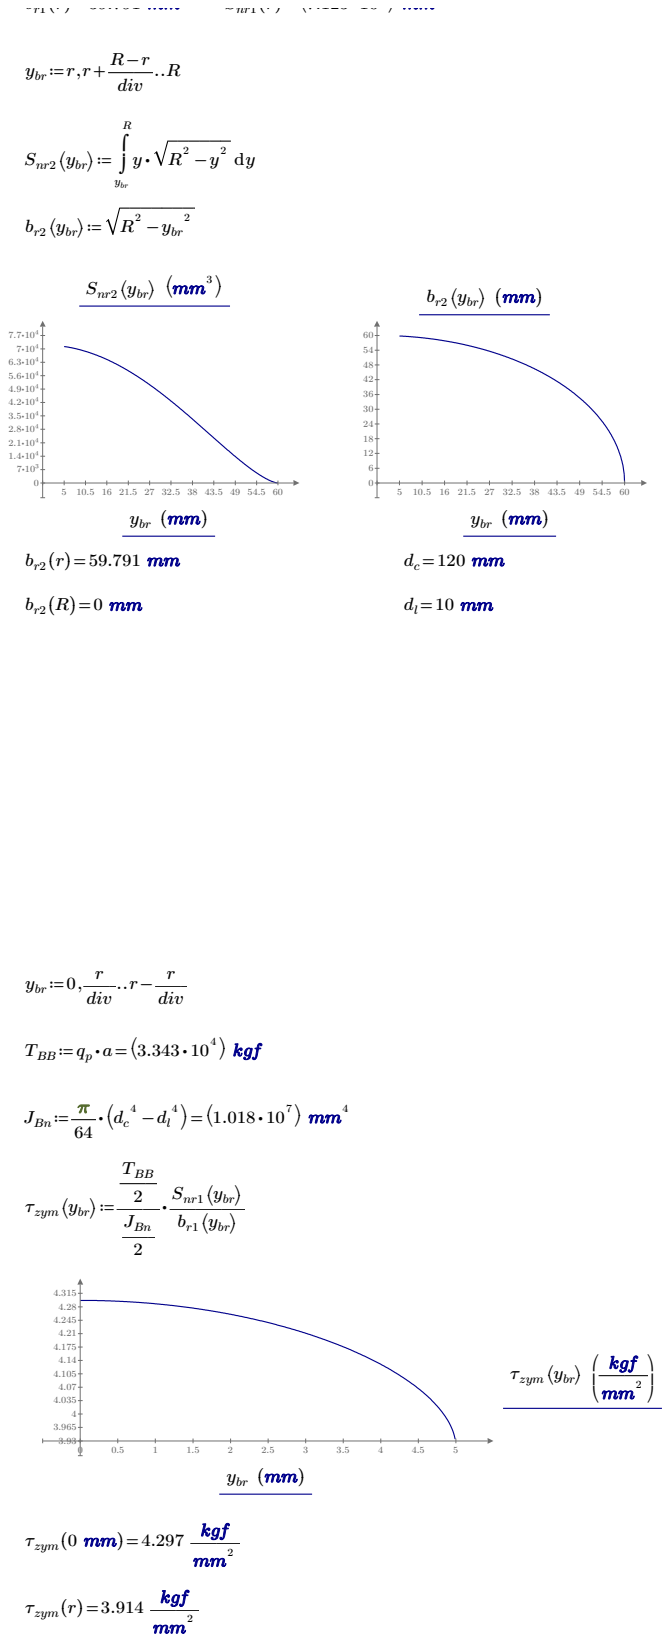
[picture p107: page 7]
ybr≔r,; ‥ r+―R r −―div; Snr2 ⎛⎝ybr⎞⎠≔; ybr; 5 10.5 16 21.5 27 32.5 38 43.5 49 54.5 60 ybr (mm); Snr2 ⎛⎝ybr⎞⎠; br2 ⎛⎝ybr⎞⎠≔; br2 ⎛⎝ybr⎞⎠; TBB≔qp; 4 ⎞ ⎠ kgf; JBn≔―⋅; τzym ⎛⎝ybr⎞⎠≔――⋅; TBB 2; JBn 2; Snr1 ⎛⎝ybr⎞⎠; br1 ⎛⎝ybr⎞⎠; ybr≔0,――‥; div; r−―r ―div; ybr (mm); τzym ⎛⎝ybr⎞⎠; ―kgf―mm

τzym (0 mm)=4.297 ―kgf―mm

τzym (r)=3.914 ―kgf―mm

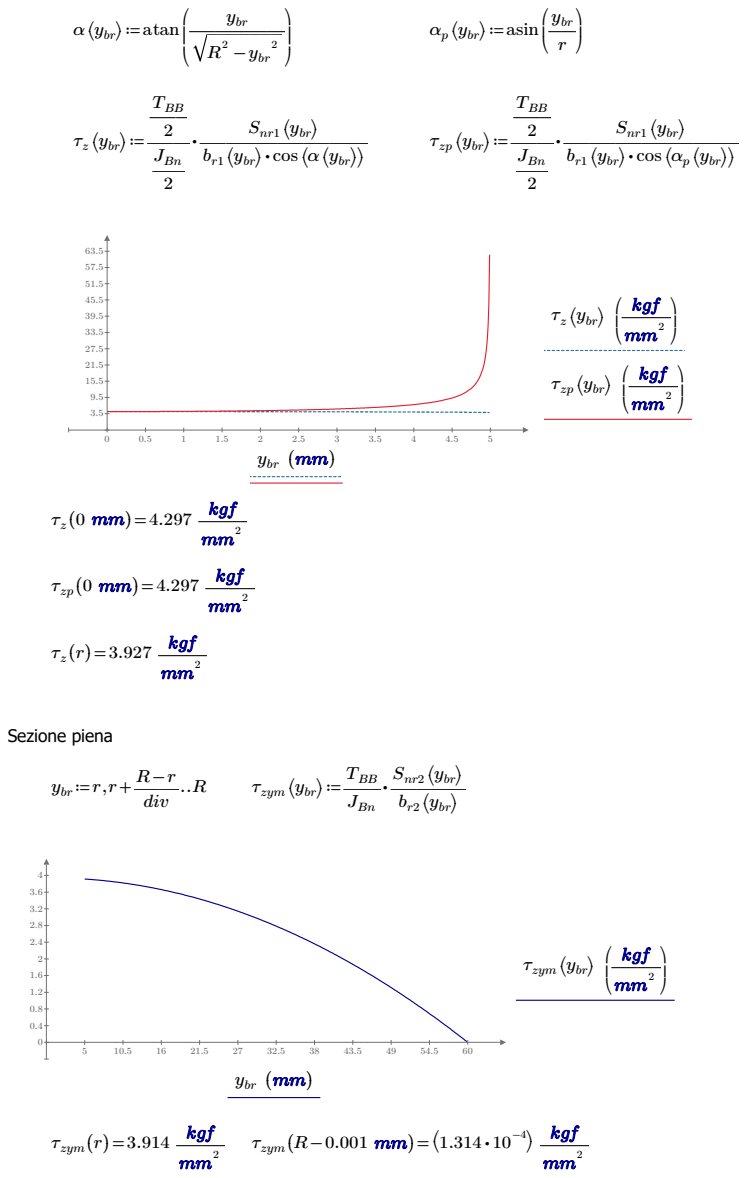
[picture p108: page 8]
α⎛⎝ybr⎞⎠≔atan; ybr; ⎛⎝ybr⎞⎠≔asin; ⎛⎝ybr⎞⎠≔――⋅; TBB 2; JBn 2; Snr1 ⎛⎝ybr⎞⎠; ⋅ r1 ⎛⎝ybr⎞⎠ cos ⎛⎝α⎛⎝ybr⎞⎠; τzp ⎛⎝ybr⎞⎠≔――⋅; ⋅ r1 ⎛⎝ybr⎞⎠ cos ⎛⎝αp; ⎛⎝ybr⎞⎠; ybr (mm); ―kgf―mm; τzp ⎛⎝ybr⎞⎠; (r)=3.927 ―kgf―mm; Sezione piena; ybr≔r,; ‥ r+―R r −―div; R τzym ⎛⎝ybr⎞⎠≔――⋅; TBB; JBn; Snr2 ⎛⎝ybr⎞⎠; br2 ⎛⎝ybr⎞⎠; τzym ⎛⎝ybr⎞⎠; τzym (R−0.001 mm)=⎛ ⎝1.314 10 ⋅; ⎠ ―kgf―mm

(0 mm)=4.297 ―kgf―mm

τzp (0 mm)=4.297 ―kgf―mm

τzym (r)=3.914 ―kgf―mm

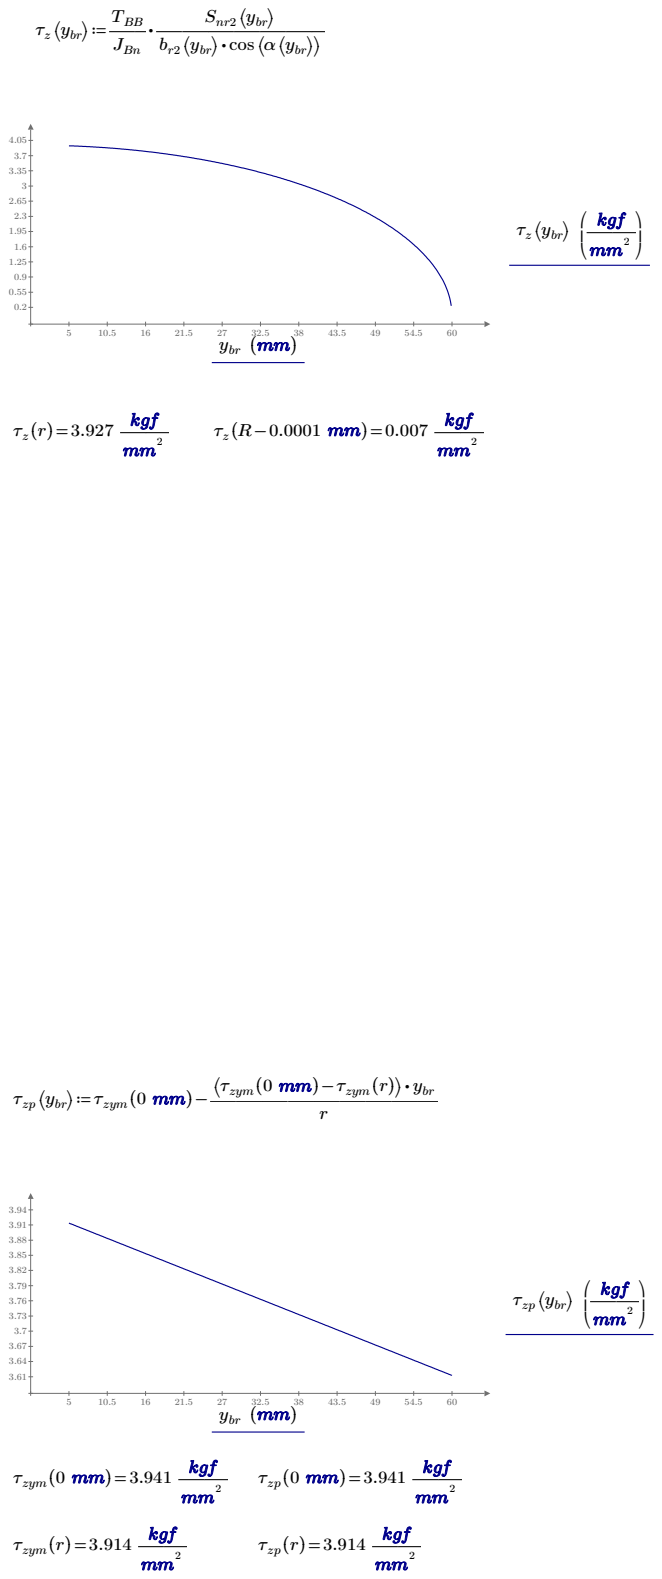
[picture p109: page 9]
⎛⎝ybr⎞⎠≔――⋅; TBB; JBn; Snr2 ⎛⎝ybr⎞⎠; ⋅ r2 ⎛⎝ybr⎞⎠ cos ⎛⎝α⎛⎝ybr⎞⎠; ybr (mm); ⎛⎝ybr⎞⎠; ―kgf―mm; (r)=3.927 ―kgf―mm; ⋅ zym (0 mm) τzym (r)⎞⎠ ybr; τzp ⎛⎝ybr⎞⎠

(R−0.0001 mm)=0.007 ―kgf―mm

τzp ⎛⎝ybr⎞⎠≔τzym (0 mm)−―――――――――

τzym (0 mm)=3.941 ―kgf―mm

τzp (0 mm)=3.941 ―kgf―mm

τzym (r)=3.914 ―kgf―mm

τzp (r)=3.914 ―kgf―mm

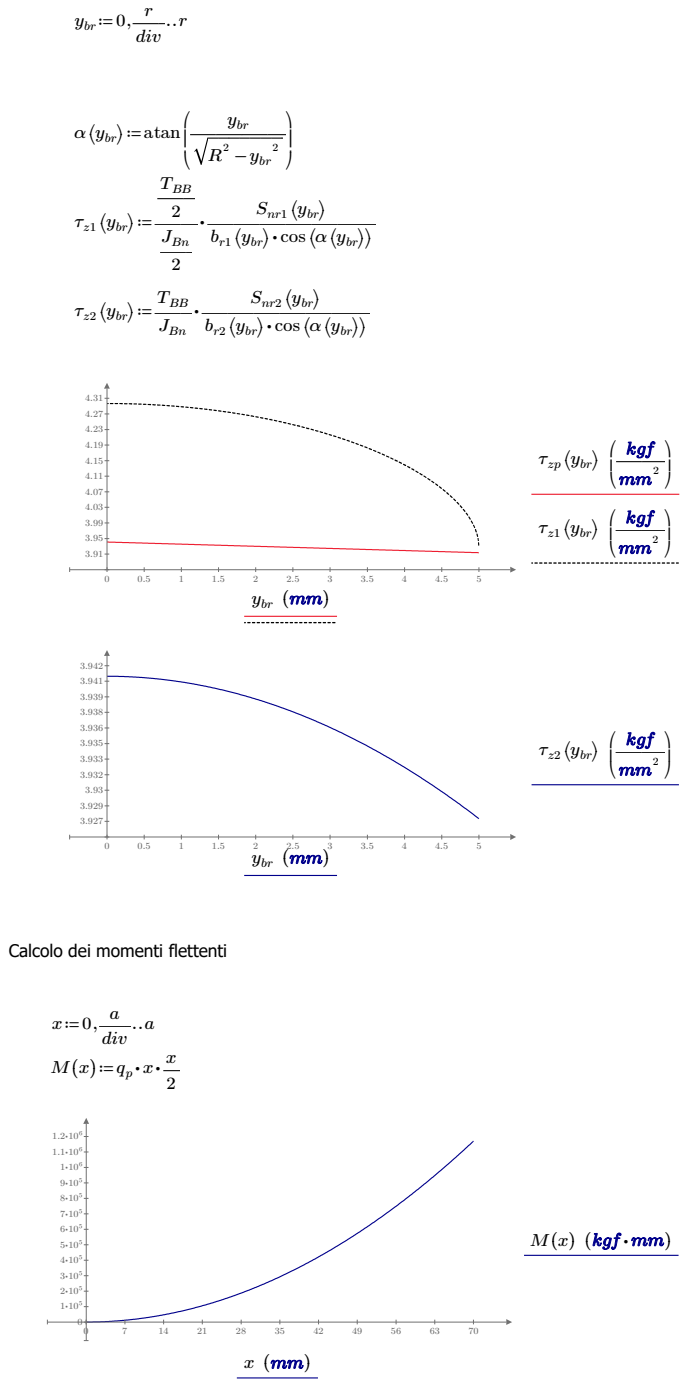
[picture p110: page 10]
ybr≔0,――‥; div; α⎛⎝ybr⎞⎠≔atan; ybr; τz1 ⎛⎝ybr⎞⎠≔――⋅; TBB 2; JBn 2; Snr1 ⎛⎝ybr⎞⎠; ⋅ r1 ⎛⎝ybr⎞⎠ cos ⎛⎝α⎛⎝ybr⎞⎠; τz2 ⎛⎝ybr⎞⎠≔――⋅; TBB; JBn; Snr2 ⎛⎝ybr⎞⎠; ⋅ r2 ⎛⎝ybr⎞⎠ cos ⎛⎝α⎛⎝ybr⎞⎠; ybr (mm); τzp ⎛⎝ybr⎞⎠; ―kgf―mm; τz1 ⎛⎝ybr⎞⎠; τz2 ⎛⎝ybr⎞⎠; M(x) (kgf ⋅mm)

Calcolo dei momenti flettenti

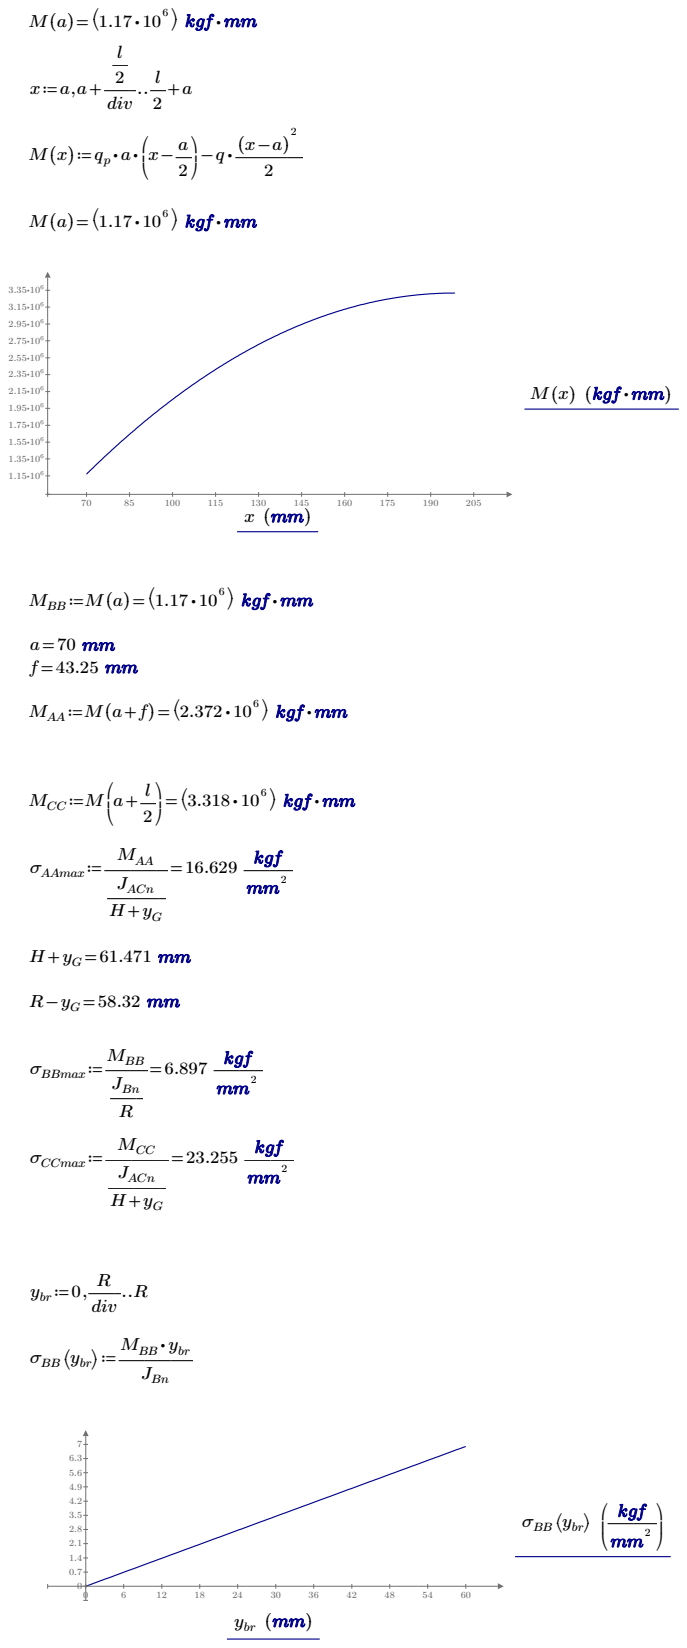
[picture p111: page 11]
6 ⎞ ⎠ kgf ⋅mm; div; M(x) (kgf ⋅mm); MBB≔M(a)=⎛ ⎝1.17 10 ⋅; MAA≔M(a f + )=⎛ ⎝2.372 10 ⋅; MCC≔M; σAAmax≔―――=; MAA; JACn; 16.629 ―kgf―mm; σBBmax≔――=; MBB; JBn; 6.897 ―kgf―mm; σCCmax≔―――=; MCC; 23.255 ―kgf―mm; ybr≔0,――‥; σBB ⎛⎝ybr⎞⎠≔―――; MBB ⋅ybr; ybr (mm); σBB ⎛⎝ybr⎞⎠; ―kgf―mm

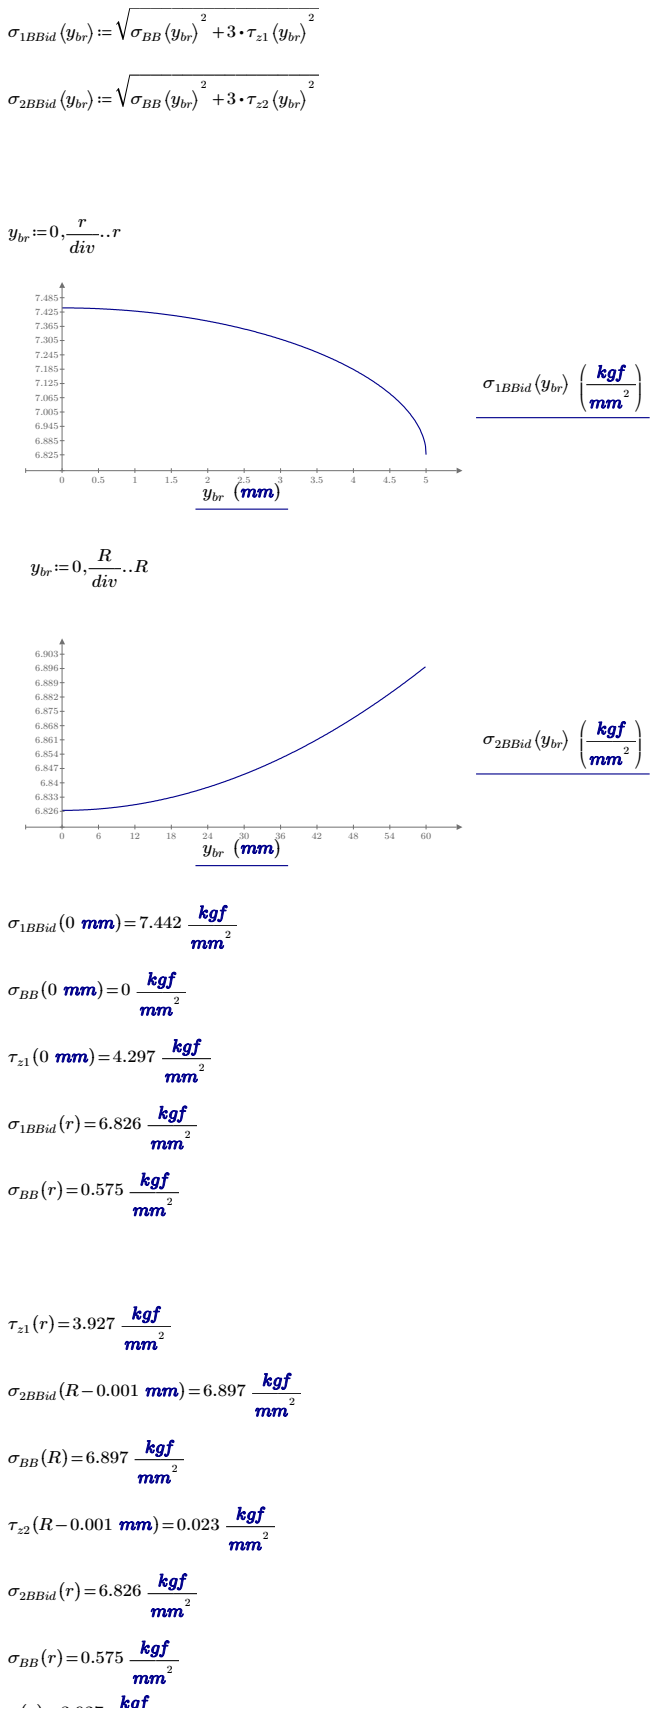
[picture p112: page 12]
σ1BBid ⎛⎝ybr⎞⎠≔; σBB ⎛⎝ybr⎞⎠ +; 3 ⋅τz1 ⎛⎝ybr⎞⎠; σ2BBid ⎛⎝ybr⎞⎠≔; 3 ⋅τz2 ⎛⎝ybr⎞⎠; ybr≔0,――‥; div; ybr (mm); σ1BBid ⎛⎝ybr⎞⎠; ―kgf―mm; σ2BBid ⎛⎝ybr⎞⎠; σ1BBid (r)=6.826 ―kgf―mm; τz1 (r)=3.927 ―kgf―mm; σ2BBid (r)=6.826 ―kgf―mm; kgf

σ1BBid (0 mm)=7.442 ―kgf―mm

σBB (0 mm)=0 ―kgf―mm

τz1 (0 mm)=4.297 ―kgf―mm

σBB (r)=0.575 ―kgf―mm

σ2BBid (R−0.001 mm)=6.897 ―kgf―mm

σBB (R)=6.897 ―kgf―mm

τz2 (R−0.001 mm)=0.023 ―kgf―mm

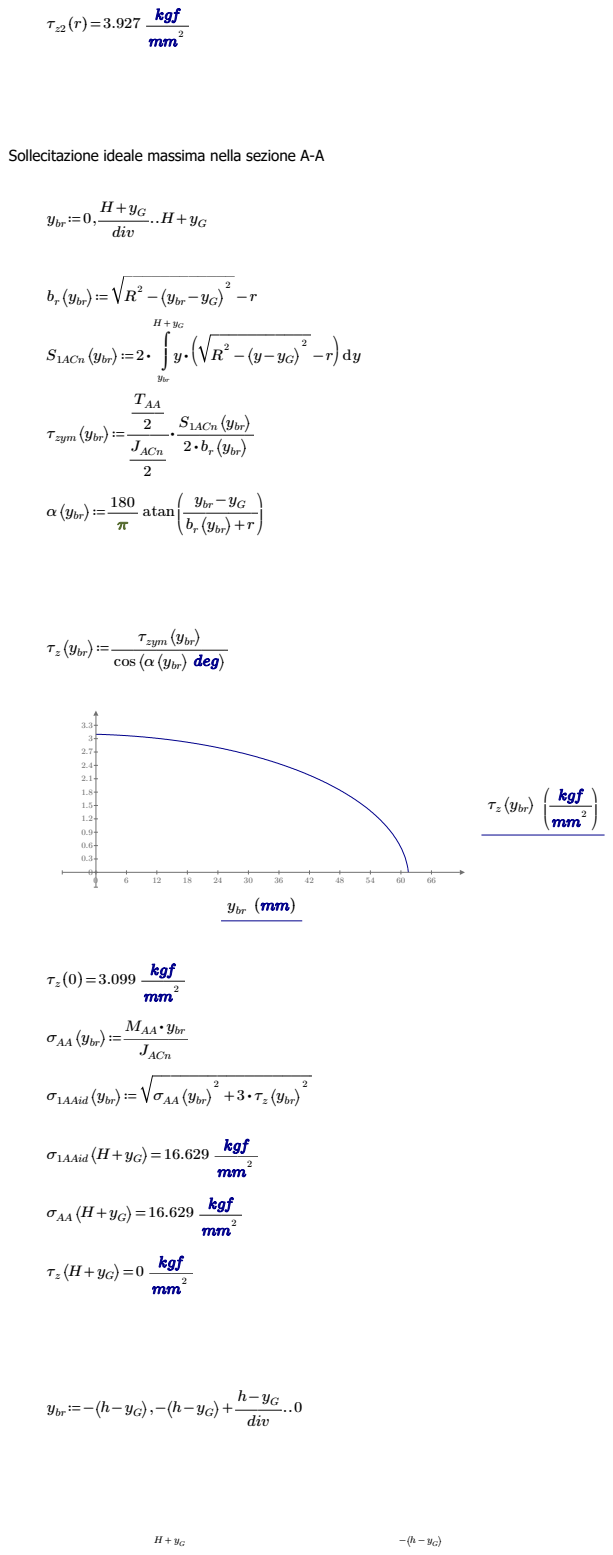
[picture p113: page 13]
τz2 (r)=3.927 ―kgf―mm; ybr≔0,―――‥; div; ⎛⎝ybr⎞⎠≔; ⎛⎝ybr−yG; S1ACn ⎛⎝ybr⎞⎠≔ ⋅2; ybr; τzym ⎛⎝ybr⎞⎠≔――⋅; TAA 2; JACn 2; S1ACn ⎛⎝ybr⎞⎠ ⋅2 br; ⎛⎝ybr⎞⎠; α⎛⎝ybr⎞⎠≔―180―π atan; ybr−yG; ⎛⎝ybr⎞⎠+r; ⎛⎝ybr⎞⎠≔――――――; ybr (mm); ―kgf―mm; (0)=3.099 ―kgf―mm; σAA ⎛⎝ybr⎞⎠≔―――; MAA ⋅ybr; JACn; σ1AAid ⎛⎝ybr⎞⎠≔; σAA ⎛⎝ybr⎞⎠ +; σ1AAid ⎛⎝H y + G⎞⎠=16.629 ―kgf―mm; σAA ⎛⎝H y + G; ⎞⎠=16.629 ―kgf―mm; ⎞⎠=0 ―kgf―mm; ybr≔−⎛⎝h y − G

Sollecitazione ideale massima nella sezione A-A

τzym ⎛⎝ybr⎞⎠
cos ⎛⎝α⎛⎝ybr⎞⎠ deg⎞⎠

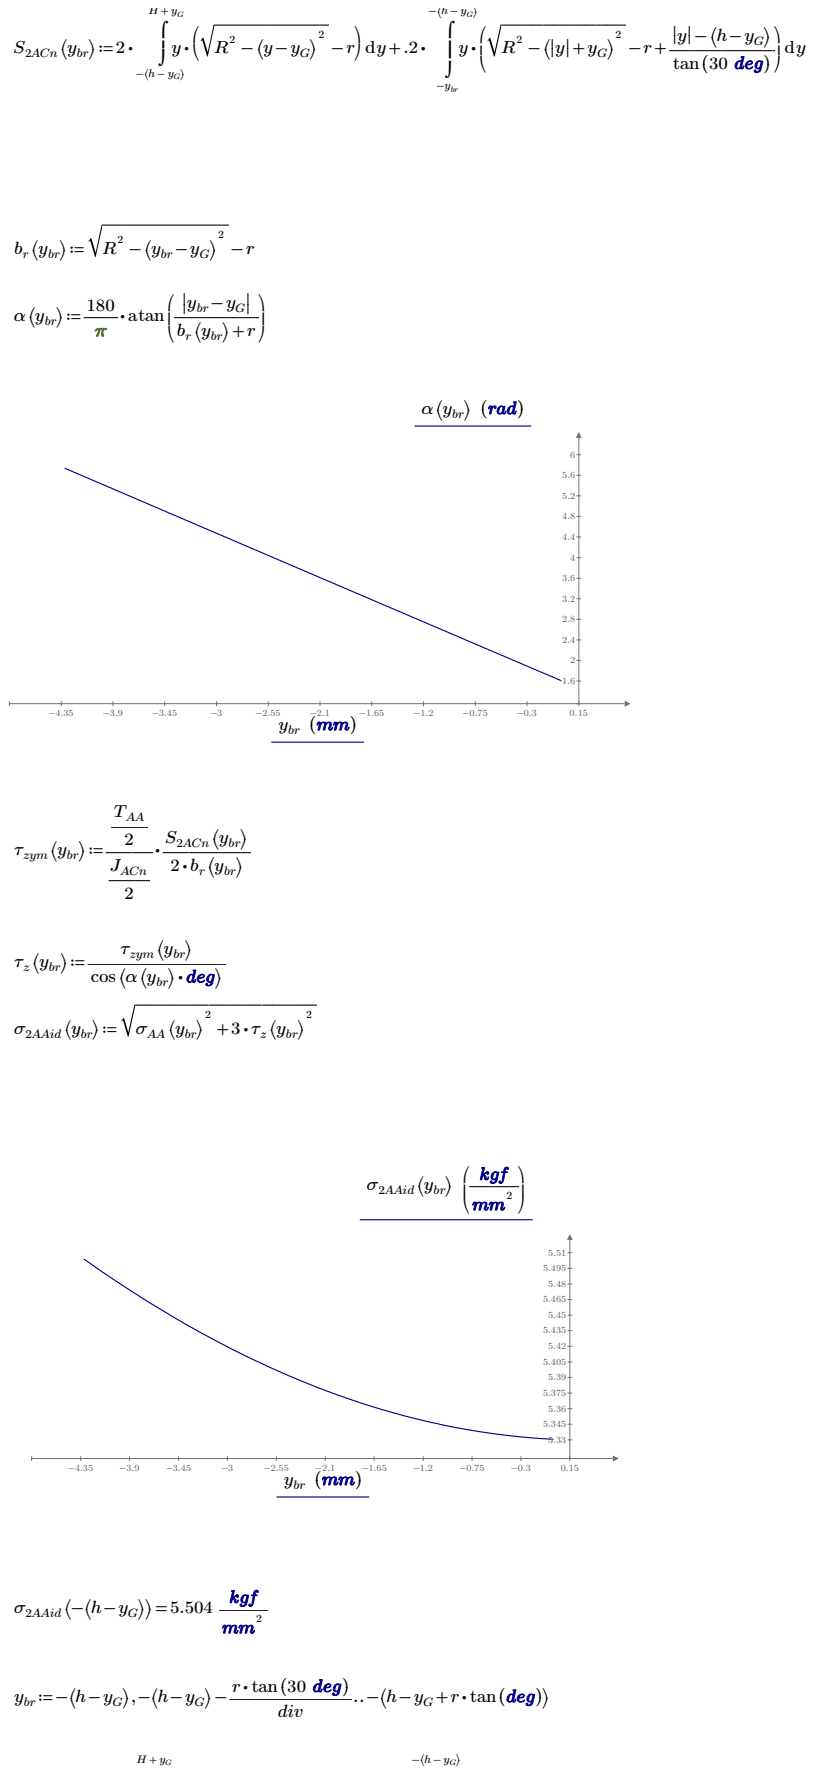
[picture p114: page 14]
S2ACn ⎛⎝ybr⎞⎠≔ ⋅2; −ybr; |y|−⎛⎝h y − G⎞⎠ tan(30 deg); ⎛⎝ybr⎞⎠≔; ⎛⎝ybr−yG; α⎛⎝ybr⎞⎠≔――⋅; atan; ||ybr−yG; ⎛⎝ybr⎞⎠+r; ybr (mm); α⎛⎝ybr⎞⎠; (rad); τzym ⎛⎝ybr⎞⎠≔――⋅; TAA 2; JACn 2; S2ACn ⎛⎝ybr⎞⎠ ⋅2 br; ⎛⎝ybr⎞⎠; ⎛⎝ybr⎞⎠≔――――――; τzym ⎛⎝ybr⎞⎠; cos ⎛⎝α⎛⎝y; ⋅ br⎞⎠ deg⎞⎠; σ2AAid ⎛⎝ybr⎞⎠≔; σAA ⎛⎝ybr⎞⎠ +; σ2AAid ⎛⎝ybr⎞⎠; ―kgf―mm; σ2AAid ⎛⎝−⎛⎝h y − G; ⎞⎠=5.504 ―kgf―mm; ybr≔−⎛⎝h y − G; ⎞⎠−―r ⋅ tan―(―30―deg―); div; −⎛⎝h y − G +r ⋅ tan(deg)⎞⎠

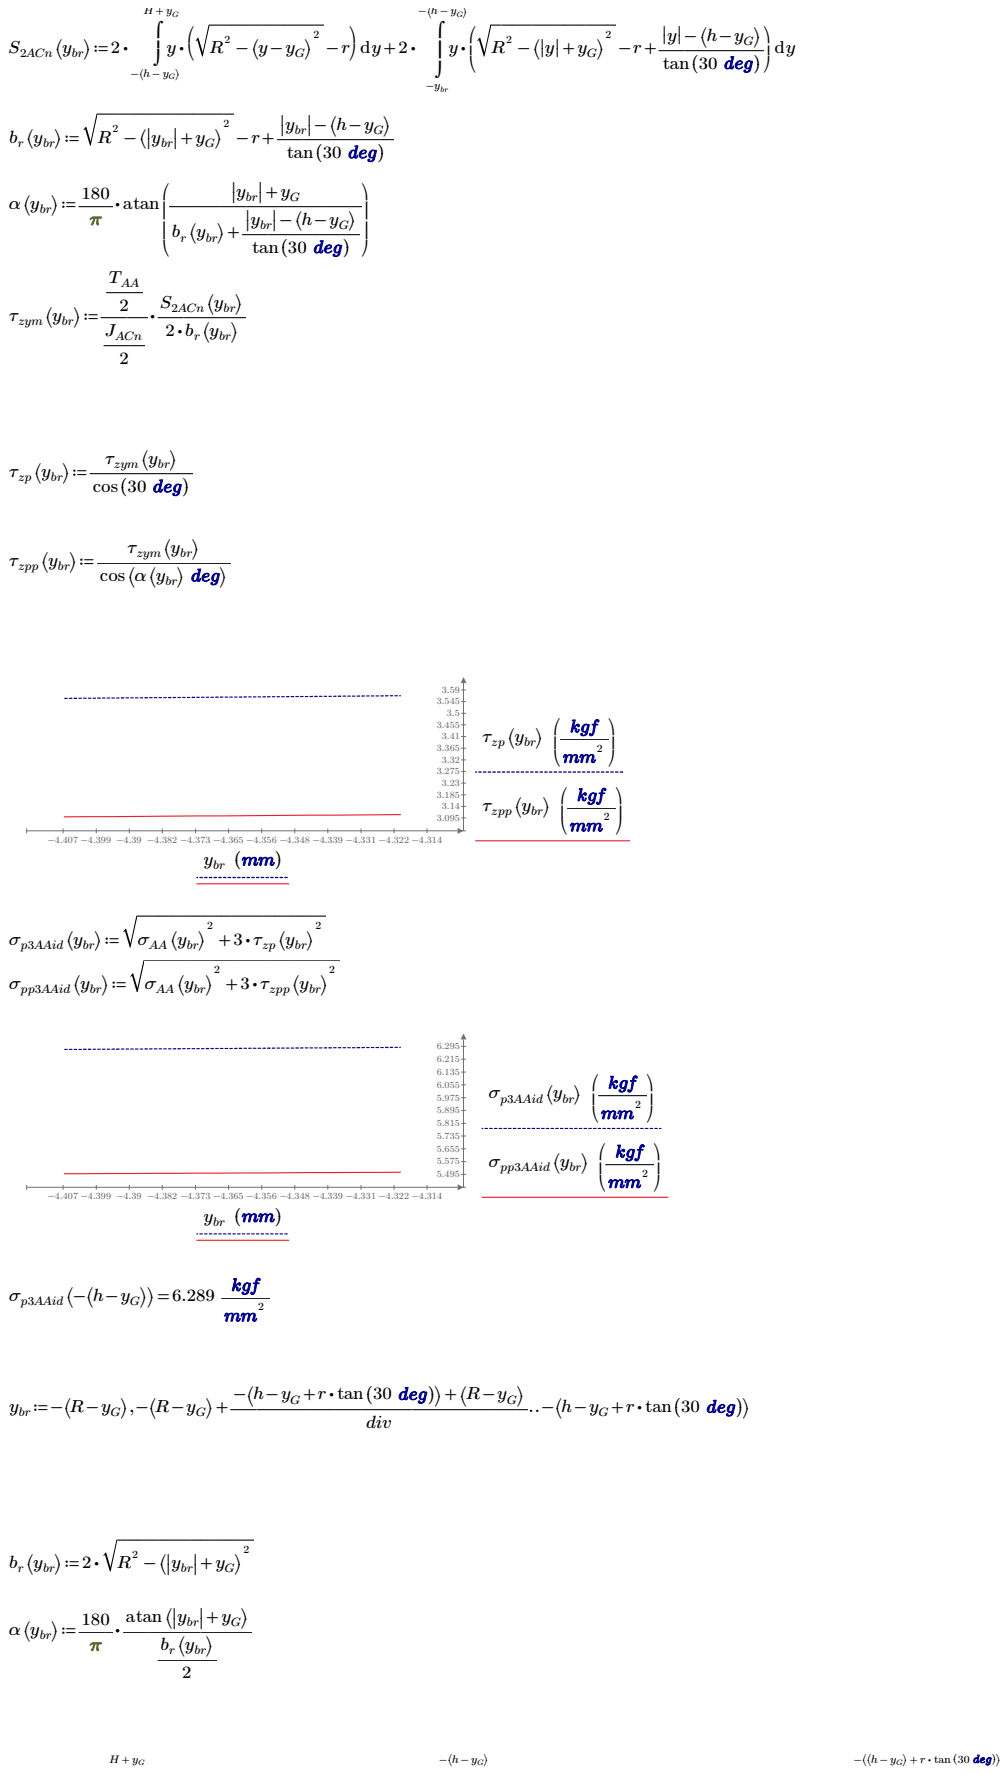
[picture p115: page 15]
S2ACn ⎛⎝ybr⎞⎠≔ ⋅2; −ybr; |y|−⎛⎝h y − G⎞⎠ tan(30 deg); ⎛⎝ybr⎞⎠≔; ||ybr||+yG; ||ybr||−⎛⎝h y − G ⎞⎠ tan(30 deg); α⎛⎝ybr⎞⎠≔――⋅; atan; ⎛⎝ybr⎞⎠+―――――; τzym ⎛⎝ybr⎞⎠≔――⋅; TAA 2; JACn 2; S2ACn ⎛⎝ybr⎞⎠ 2⋅ br; ⎛⎝ybr⎞⎠; τzp ⎛⎝ybr⎞⎠≔――――; τzym ⎛⎝ybr⎞⎠ cos (30 deg); τzpp ⎛⎝ybr⎞⎠≔――――――; -4.407 -4.399 -4.39 -4.382 -4.373 -4.365 -4.356 -4.348 -4.339 -4.331 -4.322 -4.314 ybr (mm); τzp ⎛⎝ybr⎞⎠; ―kgf―mm; τzpp ⎛⎝ybr⎞⎠; σp3AAid ⎛⎝ybr⎞⎠≔; σAA ⎛⎝ybr⎞⎠ +; 3⋅τzp ⎛⎝ybr⎞⎠; σpp3AAid ⎛⎝ybr⎞⎠≔; 3⋅τzpp ⎛⎝ybr⎞⎠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

τzym ⎛⎝ybr⎞⎠
cos ⎛⎝α⎛⎝ybr⎞⎠ deg⎞⎠

S3ACn ⎛⎝ybr⎞⎠≔ ⋅2 | + | +

⌠
⎮⌡

d

−⎛⎝h y − G⎞⎠

H + yG

y⋅

⎛
⎝ | −

R −

⎛⎝y y − G

⎞⎠
r

⎞
| ⎠ y 2 ⋅

⌠
⎮
⌡

d

−⎛⎝⎛⎝h y − G⎞⎠ + r ⋅ tan (30 deg)⎞⎠

−⎛⎝h − yG⎞⎠

y⋅

⎛
⎜
⎝

− +

R −

⎛⎝

|y|+yG
⎞⎠
r ―――――

|y|−⎛⎝h y − G⎞⎠
tan(30 deg)

⎞
⎟
⎠

y 2 ⋅

⌠
⎮⌡

d

−ybr

−⎛⎝⎛⎝h − yG⎞⎠ + r ⋅ tan (30 deg)⎞⎠

y⋅

⎛
⎝

R −

⎛⎝

|y|+yG
⎞⎠

2 ⎞
⎠ y

τzym ⎛⎝ybr⎞⎠≔――⋅

TAA

JACn

――――

S3ACn ⎛⎝ybr⎞⎠

br

⎛⎝ybr⎞⎠

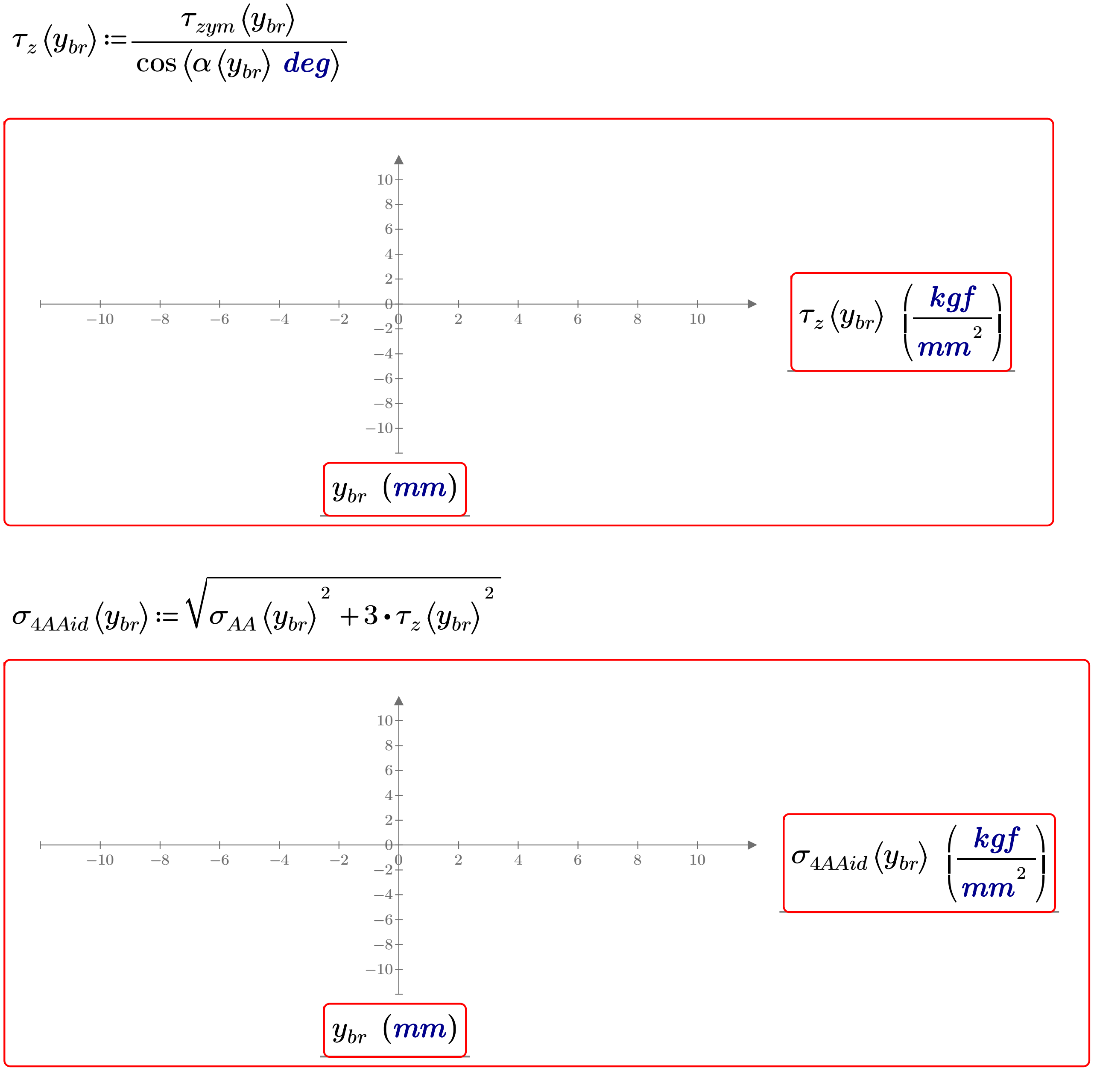
[picture p116: figure]
⎛⎝ybr⎞⎠≔――――――; τzym ⎛⎝ybr⎞⎠ cos ⎛⎝α⎛⎝ybr⎞⎠ deg⎞⎠; ybr (mm); ⎛⎝ybr⎞⎠; ―kgf―mm; σ4AAid ⎛⎝ybr⎞⎠≔; σAA ⎛⎝ybr⎞⎠ +; σ4AAid ⎛⎝ybr⎞⎠

||σAA ⎛⎝−⎛⎝R y − G⎞⎠
⎞⎠

||=15.777 ―kgf―mm

2

σ1AAid ⎛⎝H y + G

⎞⎠=16.629 ―kgf―mm

2

σ1BBid (0 mm)=7.442 ―kgf―mm

2

Sollecitazione ideale massima nella sezione C-C

σCCmax=23.255 ―kgf―mm

2

σidCCmax≔σCCmax
