arma966/ProgettazioneMeccanica2020/Mathcad/Verifica becchi.pdf

## Verifica nominale dei becchi e del gambo del gancio

Inizializzazione dei dati

Gu≔55000 kgf

vsoll≔5.5 ―m―min

t0≔5 s

apm ≔――=

vsoll
t0

0.018 ―m

s

2

apmax≔2 ⋅apm =0.037 ―m

s

2
sp≔0.5 ⋅apm ⋅t0 =

2
0.229 m

vdisc≔1.1 vsoll=6.05 ―m―min

am ≔――=

vdisc
t0

0.02 ―m

s

2
s≔0.5⋅am ⋅t0 =

2
0.252 m

amax≔2 ⋅am =0.04 ―m

s

2
Gi≔―――⋅ =

Gu
9.81 ―m

s

2

amax | 226.13 kgf
⋅ | =

――

Gi
Gu

100 0.411

Quote riferite a tabella 4.2c - Fig 4.7d

d≔165 mm
d1≔207 mm

a≔145 mm
b≔52 mm
e≔166 mm
m≔807 mm
h≔321 mm
r≔269 mm
e1≔372 mm

Dimensionamento sezione resistente trapezia

Q≔――=

Gu
2

⎛
⎝2.75 10 ⋅

4 ⎞
⎠ kgf

I≔―− =

m
2

r 134.5 mm

yA≔h r − =52 mm

xA≔―− =

e1
2

I 51.5 mm

γ≔atan | =

⎛
⎜
⎝

―I―h y − A

| ⎞ ⎟ ⎠ 26.565 deg

α≔0,―‥

γ
6

γ

β(α)≔γ α −

xC

(α)≔⎛⎝h y − A

| ⎞⎠ ⋅ tan(β(α))

yC

(α)≔0

a0

(α)≔1 tan + (β(α))

2

b0

(α)≔−2 ⋅yA − ⋅2 tan(β(α)) ⋅xA

c0

(α)≔xA + −

2
yA
| 2 ――

d1

2
4

y1

(α)≔―――――――――――

−b0 (α)+ | 2
b0

(α) −

2
⋅4 a0

(α) c0

(α)
2 ⋅a0

(α)

y2

(α)≔―――――――――――

−b0

(α)−

2
b0

(α) −

2
4⋅a0

(α) c0

(α)
2 ⋅a0

(α)

y2

(α)=

−28.098
−29.675
−31.26
−32.858
−34.475
−36.114
−37.778

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
mm α=

0
4.428
8.855
13.283
17.71
22.138
26.565

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
(α)≔||y2

(α)||

xB

(α)≔||y ⋅ 2

(α) tan(β(α))||

xB

(α)=

14.049
12.072
9.982
7.757
5.371
2.796
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
mm yB

(α)=

28.098
29.675
31.26
32.858
34.475
36.114
37.778

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
mm α=

0
4.428
8.855
13.283
17.71
22.138
26.565

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
(α)≔

2
⎛⎝xC

(α)−xB

(α)⎞⎠ +

2
⎛⎝h y − C

(α)−yA −yB

(α)⎞⎠

2

IC

(α)=

269.337
258.372
249.568
242.633
237.354
233.583
231.222

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
BO(α)≔――⋅

IC

(α)
3

―a+―2 b― a b +

AB(α)≔

2
xB

(α) +

2
yB

(α)

2

AO(α)≔BO(α)+AB(α)

xO

(α)≔−AO(α) ⋅ sin(β(α))

yO

(α)≔−AO(α) ⋅ cos (β(α))

Calcolo curvatura baricentrica

ρ (α)≔――――――――――――――――

⎛
⎜
⎜
⎝

AO(α) +

2 ⎛
⎜
⎝

―d ―dα
AO(α)

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
(AO(α)) + | −

2
2 ⋅

⎛
⎜
⎝

―d ―dα
AO(α)

⎞
⎟
⎠

2
AO(α) ⋅―d ―d

2

α

2

AO(α)

-7550

-6700

-5850

-5000

-4150

-3300

-2450

-1600

-750

-9250

-8400

100

0 | 0.045 | 0.09 | 0.135 | 0.18 | 0.225 | 0.27 | 0.315 | 0.36 | 0.405 | 0.45 | 0.495
α (rad)

ρ(α) (mm)

Calcolo dell'anomalia della curvatura rispetto ad una retta orizzontale

Θ(α)≔atan

⎛
⎜
⎜
⎜
⎜
⎝

――――

―d ―dα
yO

(α)

―d ―dα
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
δ (α)≔Θ(α)+―π
2
αnegρ≔0.448 rad

αposρ≔0.464 rad

α≔0, ‥ ――

αnegρ
10

αnegρ

Ir≔h−―=

d1
2

217.5 mm

ψ≔atan =

⎛
⎜
⎝

――

e1
2 ⋅h

⎞
⎟
⎠

30.09 °

NR≔―⋅ | =

Ir
3

―(a+―2 ―b)
a b +

91.637 mm

MR≔Ir−NR=125.863 mm

bx≔ | + | =

⎛
⎜
⎝

NR+―

d1
2

⎞
⎟
⎠

sin(ψ)

⎛
⎜
⎝

NR+―

d1
2

⎞
⎟
⎠
| | ――

2
2
2

235.816 mm

by≔ | − | =

⎛
⎜
⎝

NR+―

d1
2

⎞
⎟
⎠

cos (ψ)

⎛
⎜
⎝

NR+―

d1
2

⎞
⎟
⎠
| | ――

2
2
2

30.858 mm

Mq≔Q b⋅ x+Q b⋅ y=⎛ | ⎝7.334 10 ⋅

6 ⎞
| | ⎠ kgf ⋅mm

A≔―――=

(a b + ) Ir
2

⎛
| ⎝2.142 10 ⋅

4 ⎞
⎠ mm

2

ρ≔NR+―=

d1
2

195.137 mm

χ≔−― | =

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
―η―ρ η +

⎛
⎜
⎝

b+―a b −―Ir
(MR η + )

⎞
⎟
⎠

η 0.137

σN≔― | − | − | =

1
A

―Q―

――

2
2

sin⎛
⎜
⎝

ψ+―π
4

⎞
⎟
⎠
| | ――

Mq
A ρ⋅

―――⋅

Mq
χ A ρ ⋅ ⋅

―−NR―― ρ NR −
11.364 ―kgf―mm

2

σM ≔― | − | − | =

1
A

―Q―

――

2
2

sin⎛
⎜
⎝

ψ+―π
4

⎞
⎟
⎠
| | ――

Mq
A ρ⋅

―――⋅

Mq
χ A ρ ⋅ ⋅

―MR―― ρ MR +
−5.033 ―kgf―mm

2

⎛ ⎞

τND≔― | =

3
2

―――――――

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
ψ+―π
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
1.079 ―kgf―mm

2

τIr≔― | =

3
2

――――――

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
ψ+―π
4

⎞
⎟
⎠

b I⋅ r

1.327 ―kgf―mm

2

Considero un nuovo solido fittizio più cautelativo

a0≔1 tan +

⎛
⎜
⎝

―−π―4

⎞
⎟
⎠

2

q≔yA −tan⎛
⎜
⎝

―−π―4

⎞
⎟
⎠

xA
b0≔2 tan⎛
⎜
⎝

―−π―4

⎞
⎟
⎠

q

c0≔q −

2
h

2

x1≔―――――――=

−b0+

2
b0 −

2

### 4 a ⋅ 0

c0

### 2 a0

272.753 mm

x2≔―――――――=

−b0−

2
b0 −

2

### 4 a ⋅ 0

c0

### 2 a0

−169.253 mm

xS≔x1

yS≔tan ⋅ + =

⎛
⎜
⎝

―−π―4

⎞
⎟
⎠
x1 | q −169.253 mm
hs≔ | =

2
⎛⎝xS−xA

⎞⎠ +

2
| ⎛⎝yS−yA

⎞⎠

2
| | 312.899 mm

NU≔hs−―=

d1
2
| 209.399 mm
NV≔―― | =

NU
3

―a+―2 b― a b +
| 88.224 mm
UV≔NU NV − | =121.175 mm
bx≔ | + | =

⎛
⎜
⎝

NV+―

d1
2

⎞
⎟
⎠

sin(ψ)

⎛
⎜
⎝

NV+―

d1
2

⎞
⎟
⎠
| | ――

2
2

231.691 mm

by≔ | − | =

⎛
⎜
⎝

NV+―

d1
2

⎞
⎟
⎠

cos (ψ)

⎛
⎜
⎝

NV+―

d1
2

⎞
⎟
⎠
| | ――

2
2

30.318 mm

Mq≔Q b⋅ x+ Q b⋅ y=⎛ | ⎝7.205 10 ⋅

6 ⎞
| | ⎠ kgf ⋅mm

A≔――――=

(a b + ) ⋅NU
2

⎛
| ⎝2.063 10 ⋅

4 ⎞
⎠ mm

2

ρ≔NV+―=

d1
2

191.724 mm

χ≔−― | =

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
―η―ρ η +

⎛
⎜
⎝

b+―a b −―NU
(UV η + )

⎞
⎟
⎠

η 0.129

σN≔― | − | − | =

1
A

―Q―

――

2
2

sin⎛
⎜
⎝

ψ+―π
4

⎞
⎟
⎠
| | ――

Mq
A ρ⋅

―――⋅

Mq
χ A ρ ⋅ ⋅

―−NV―― ρ NV −
12.016 ―kgf―mm

2

σU≔― | − | − | =

1
A

―Q―

――

2
2

sin⎛
⎜
⎝

ψ+―π
4

⎞
⎟
⎠
| | ――

Mq
A ρ⋅

―――⋅

Mq
χ A ρ ⋅ ⋅

―UV―― ρ UV +
−5.459 ―kgf―mm

2

Carico applicato verticalmente, passante per O' con il nuovo solido fittizio per la verifica del gambo

ρ≔―+ =

d1
2

―d
2

186 mm

bX≔ρ⋅ | =

⎛
⎜
⎝

1+――

2
2

⎞
⎟
⎠

317.522 mm

bY≔ρ ⋅――=

2
2

131.522 mm

Mq≔Q b⋅ X − Q b⋅ Y =⎛
⎝5.115 10 ⋅

6 ⎞
⎠ kgf ⋅mm

A≔π⋅―=

d

2
4

⎛
⎝2.138 10 ⋅

4 ⎞
⎠ mm

2

χ≔―⋅ | + | + | =

1
4

⎛
⎜
⎝

―d ―2 ρ

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
―d ―2 ρ

⎞
⎟
⎠

4
――⋅

5
6 4 +

⎛
⎜
⎝

―d ―2 ρ

⎞
⎟
⎠

6
0.058
σK≔―− | + | =

Q
A

――

Mq
A ρ⋅
| ―――⋅

Mq
χ A ρ ⋅ ⋅

――d ― 2 ⋅ρ d −
| | 17.727 ―kgf―mm

2

σW ≔―− | − | =
Q A | ――

Mq
A ρ⋅

―――⋅

Mq
χ A ρ ⋅ ⋅

――d ― 2 ⋅ρ d +
−6.833 ―kgf―mm

2

Verifica del gambo del gancio

Mq≔ρ Q⋅ =⎛
⎝5.115 10 ⋅

3 ⎞
⎠ m⋅ kgf

P≔16 mm
m≔125 mm

i≔―――=

### 0.8 m

P

6.25

Gg≔1800 kgf

Gi≔――― =

Gu+Gg
9.81 ―m

s

2

amax | 233.53 kgf
⋅ | =

――

Gi
Gu

100 0.425

d3≔122.4 mm

σ≔―――――=

Gu+Gg+Gi

―――――

π⋅ ⎛⎝1.2 ⋅d3

⎞⎠

2

4

3.366 ―kgf―mm

2

τ≔1.5⋅――――=

Gu+Gi+Gg
π⋅d ⋅ ⋅ 3 P i

2.225 ―kgf―mm

2

Verifica a schiacciamento dei filetti

d≔140 mm

σ≔―――――=

Gu+Gg+Gi

i⋅―――――

π⋅

⎛
⎝d −

2
d3

2 ⎞
⎠
4

2.516 ―kgf―mm

2
