arma966/ProgettazioneMeccanica2020/Mathcad/Verifica traversa lamoni piastroni.pdf

### Verifica nominale della traversa, dei lamoni e dei piastroni

Gu≔55000 kgf

Gi≔227 kgf

Gg≔180 kgf

Dalle tabelle 4.5a - 4.1b

dt≔105 mm

A1≔220 mm

s1≔25 mm

s2≔6 mm

l1≔190 mm

S1≔s1

⋅ ⎛⎝A1−dt

⎞⎠=2875 mm

2

σ≔――――=

Gu+Gg+Gi
2 ⋅S1

9.636 ―kgf―mm

2

―=

dt
A1

0.477

―=

l1
A1

0.864

x≔

0.274
0.350
0.450
0.550
0.650
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
3.35
2.75
2.45
2.3
2.25

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
yS≔lspline(x y, )

kt≔interp | =

⎛
⎜
⎝

y , , , S x y ―

dt
A1

⎞
⎟
⎠

2.647

xc≔x , | ‥ =
0

x +
| 0 ―――

x −
5

x
0
10
| x
| 5

0.274
0.317
0.359
0.402
0.444
0.487
0.53
0.572
0.615
0.657
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
kt≔interp⎛⎝y , , , S x y xc

⎞⎠

2.65

2.85

3.05

3.25

3.45

3.65

3.85

4.05

2.25

2.45

4.25

0.27 | 0.315 | 0.36 | 0.405 | 0.45 | 0.495 | 0.54 | 0.585 | 0.63 | 0.675 | 0.72
xc

kt

kt≔interp | =

⎛
⎜
⎝

y , , , S x y ―

dt
A1

⎞
⎟
⎠

2.647

σmax≔kt

⋅σ=25.504 ―kgf―mm

2

Maggioro s1 e s2 a sensibilità personale

kt=2.647

s1≔40 mm

s2≔30 mm

S1≔s1

⋅ ⎛⎝A1−dt

⎞⎠=4600 mm

2

S2≔s2

⋅ ⎛⎝A1−dt

⎞⎠=3450 mm

2

σ≔――――=

Gu+Gi+Gg
2⋅ ⎛⎝S1+S2

⎞⎠

3.441 ―kgf―mm

2

σmax≔kt

⋅σ=9.109 ―kgf―mm

2

f (dx)≔―――――――−

interp

⎛
⎜
⎝

y , , , S x y ―

dt
A1

⎞
⎟
⎠
s ⋅ 1

⎛⎝A1−dt

⎞⎠

―――――――

interp

⎛
⎜
⎝

y , , , S x y ―

dt
dx

⎞
⎟
⎠
s ⋅ 2

⎛⎝dx d − t

⎞⎠

dx1≔A1=220 mm

dx2≔3 A1=660 mm

dxS≔ root ⎛⎝f (dx) ,dx dx , 1
,dx2

⎞⎠=297.862 mm

dx≔dx1

,dx1+―――‥

dx2−dx1
50

dx2

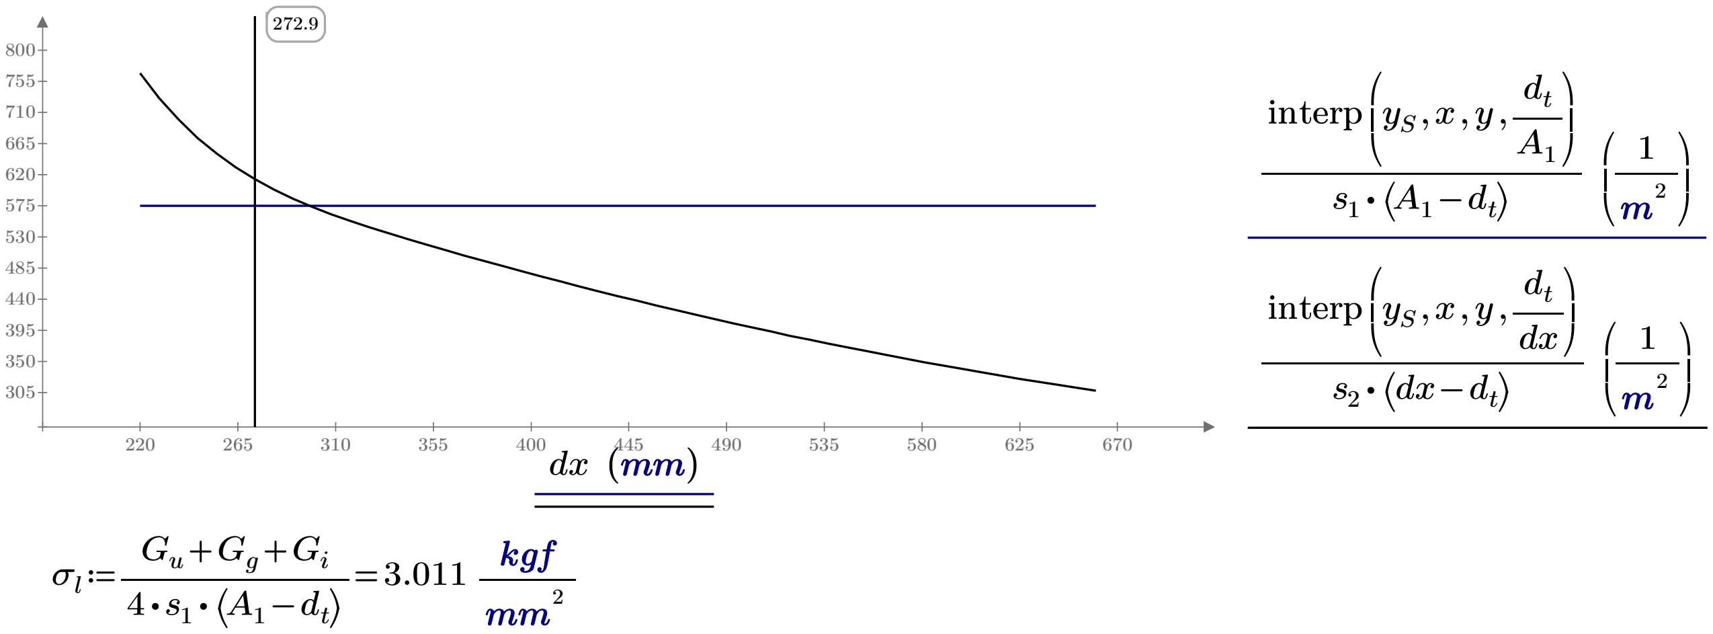
[picture p117: figure]
interp; 3.011 ―kgf―mm

σp≔―――――=

Gu+Gg+Gi
4⋅ s ⋅ 2

⎛⎝dxS−dt

⎞⎠

2.394 ―kgf―mm

2

ktl≔interp | =

⎛
⎜
⎝
y , | ,, S x y ― dt A1 ⎞ ⎟ ⎠
| 2.647
ktp≔interp | =

⎛
⎜
⎝

y , , , S x y ――

| dt dxS ⎞ ⎟ ⎠
3.329

σmaxl≔ktl

⋅σl=7.97 ―kgf―mm

2

σmaxp≔ktp

⋅σp=7.97 ―kgf―mm

2

α≔―− | =

π
atan

⎛
⎜
⎝

―――

dxS−A1
⋅2 l1

⎞
⎟
⎠

### 78.42 deg

a≔s1+s2=70 mm

Bt ≔245 mm

d2≔130 mm

c≔―――=

Bt+d2
2

187.5 mm

T≔84 mm

b≔―――――=

3 ⋅T+5 mm−c
2

### 34.75 mm

I≔3⋅T+5 mm+2⋅ a=397 mm

q≔――――=

Gu+Gg+Gi

c

295.504 ―kgf―mm

qp≔――――=

Gu+Gg+Gi

### 2 a

395.764 ―kgf―mm

MCC≔qp

⋅―=

a

2
2

969622.5 kgf ⋅mm

MBB≔−q ⋅―+ | =

c

2
8

a q⋅ ⋅ p

⎛
⎜
⎝

―+ +

c
2

b ―a
2

⎞
⎟
⎠

3230920.688 ⋅ kgf mm

TCC≔qp

⋅a=27703.5 kgf

Ht≔130 mm

At≔400 mm

df≔145 mm

s≔―――

⎛⎝At−df

⎞⎠
2
JXX≔2 ⋅―――=

s H⋅ t

3
12

46686250 mm

4

σmaxBB≔――=

MBB

――

JXX

―

Ht
2

4.498 ―kgf―mm

2

σmaxCC≔―――=

MCC

π⋅――

dt

3
32

8.532 ―kgf―mm

2

τmaxCC≔― | =

4
3

―――

TCC

π⋅――

dt

2
4

4.266 ―kgf―mm

2

z≔0 mm, | ‥ ― | =

60
50

mm 50 mm

0
⋮

⎡
⎣

⎤
⎦

mm

τsCC (z)≔ | ⋅

⎛
⎜
⎜
⎝
| ――――

4 ⋅TCC

3 ⋅π⋅

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
―z ―

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
σCC (z)≔―――⋅

MCC

π⋅――

dt

4
64

z

σid (z)≔

σCC (z) +

2

### 3 τsCC (z)

2

σid (z)=

72457976.31
⋮

⎡
⎣

⎤
⎦ ―kg―m⋅ s

2

τsCC (z)=

41833632.128
⋮

⎡
⎣

⎤
⎦ ―kg―m⋅ s

2

σCC (z)=

0
⋮

⎡
⎣

⎤
⎦ ―kg―m⋅ s

2

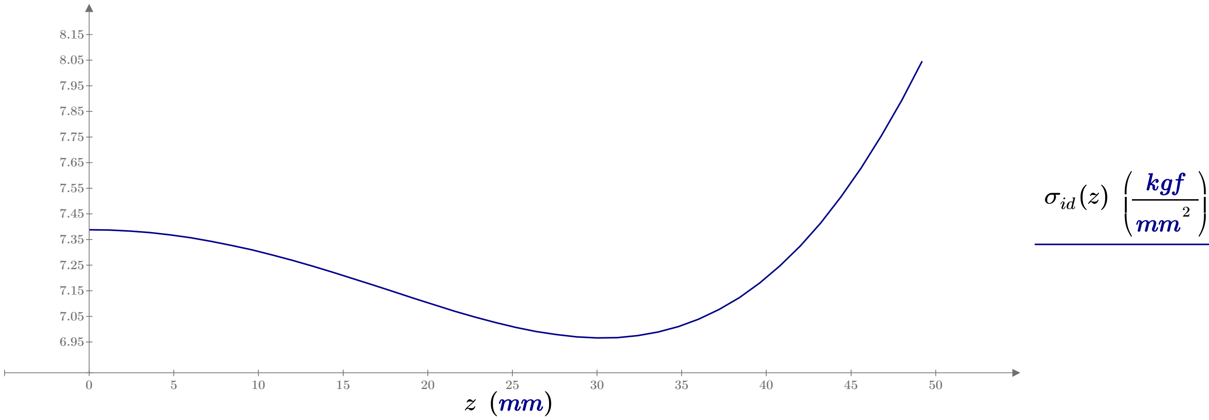
[picture p118: figure]
σid (z); ―kgf―mm

⎞
⎟
⎠

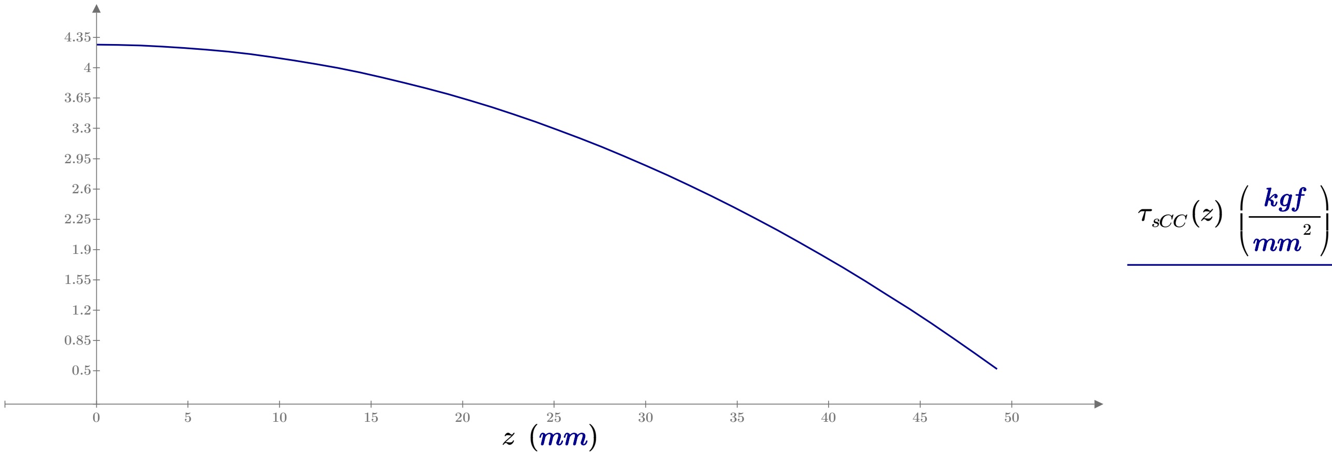
[picture p119: figure]
τsCC (z); ―kgf―mm

⎞
⎟
⎠

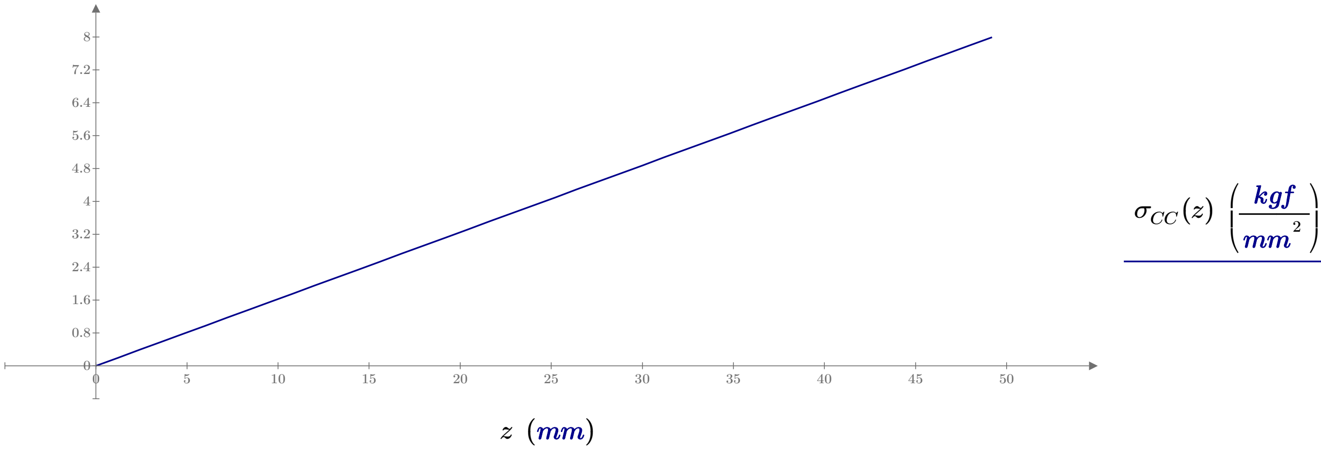
[picture p120: figure]
σCC (z); ―kgf―mm

⎞
⎟
⎠
σid | =

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
8.532 ―kgf―mm

2

―=

a
dt

0.667

p≔――――=

Gu+Gg+Gi
2⋅a d⋅ t

3.769 ―kgf―mm

2

τmaxl≔―⋅ | =

3
2

―――――

Gg+Gu+Gi

4⋅ s ⋅ 1

⎛
⎜
⎝

l1−―

dt

⎞
⎟
⎠

3.778 ―kgf―mm

2

τmaxp≔―⋅ | =

3
2

―――――

Gg+Gu+Gi

4⋅ s ⋅ 2

⎛
⎜
⎝

l1−―

dt

⎞
⎟
⎠

5.037 ―kgf―mm

2

dc≔120 mm

―=

l1
A1

0.864 ―=

dc
A1

0.545

kt≔interp

⎛
⎜
⎝

y , ,, S x y ―

dc
A1

⎞
⎟
⎠

σ≔―――――――=

Gu+Gg+Gi
2 ⎛⎝s + ⋅ 1
s2

⎞⎠

⎛⎝A1−dc

⎞⎠

3.958 ―kgf―mm

2

σmaxDD≔σ k⋅ t=9.734 ―kgf―mm

2

dx1≔A1=220 mm

dx2≔3 A1=660 mm

dxp≔dx1, | ‥ dx1+―dx2 dx1 ―− ―― 50
dx2

f (dxp)≔―――――――−

interp

⎛
⎜
⎝

y , , , S x y ―

dc
A1

⎞
⎟
⎠
s ⋅ 1

⎛⎝A1−dc

⎞⎠

―――――――

interp

⎛
⎜
⎝

y , ,, S x y ――

dc
dxp

⎞
⎟
⎠
s ⋅ 2

⎛⎝dxp d − c

⎞⎠

dxs≔root (f (dxp) ,dxp dx1 dx2 , | , | )=270.561 mm

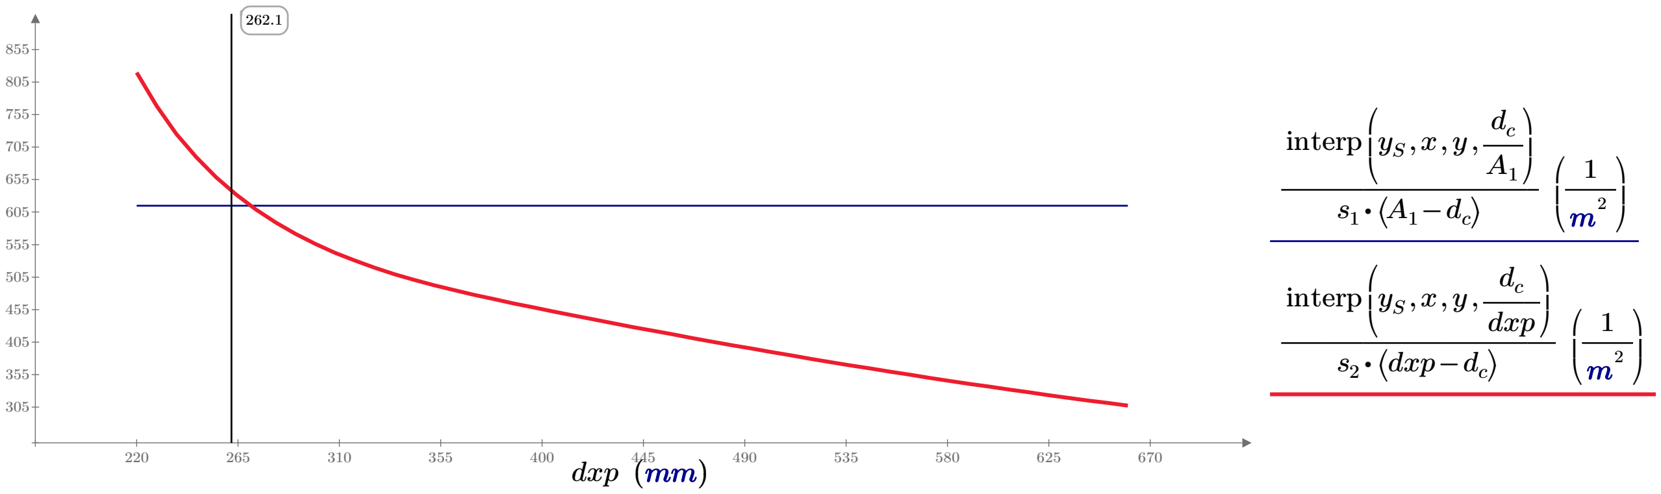
[picture p121: figure]
dxp (mm); interp; dxp; ⎛⎝dxp d − c

σl≔―――――=

Gu+Gg+Gi
4⋅ s ⋅ 1

⎛⎝A1−dc

⎞⎠

3.463 ―kgf―mm

2

σp≔―――――=

Gu+Gg+Gi
⋅4 s ⋅ 2

⎛⎝dxs d − c

⎞⎠

3.067 ―kgf―mm

2

ktl≔interp | =

⎛
⎜
⎝

y , , , S x y ―

| dc A1 ⎞ ⎟ ⎠
| 2.46
ktp≔interp | =

⎛
⎜
⎝

y , ,, S x y ―― dc dxs ⎞ ⎟ ⎠
2.777

σlmax≔ktl

⋅σl=8.517 ―kgf―mm

2

σpmax≔ktp

⋅σp=8.517 ―kgf―mm

2

yp≔―――=

dxs A− 1
25.281 mm

l2≔225 mm

αp≔atan =

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
83.589 deg

Verifica della sezione E-E

l2=225 mm

l2≔235 mm

s1=40 mm

s2=30 mm

τmaxp≔―⋅ | =

3
2

―――――

Gg+Gu+Gi

4 ⋅ s ⋅ 2

⎛
⎜
⎝

l2−―

dc
2

⎞
⎟
⎠

3.958 ―kgf―mm

2

τmaxl≔―⋅ | =

3
2

―――――

Gg+Gu+Gi

4⋅ s ⋅ 1

⎛
⎜
⎝

l2−―

dc
2

⎞
⎟
⎠

2.968 ―kgf―mm

2
