arma966/ProgettazioneMeccanica2020/SolidWorks/Simulazioni/AsseSim-VerificaForo90-BenchMark-Solver.txt

Solver 7.050 Linear-static-solver-Start 0 0 0 0 0 0 0 0 0 0 0 0 0 0 0 0 0 0 0 0 0 0 0 0 0 0 0 0
Solver 7.050 Loading-and-preparing-input-data-Start 0 0 0 0 0 0 0 0 0 0 0 0 0 0 0 0 0 0 0 0 0 0 0 0 0 0 0 0
Solver 7.912 Loading-and-preparing-input-data-End 0 0 0 0 0 0 0 0 0 0 0 0 0 0 0 0 0 0 0 0 0 0 0 0 0 0 0 0
Solver 7.912 Computing-load-vector-Start 0 0 0 0 0 0 0 0 0 0 0 0 0 0 0 0 0 0 0 0 0 0 0 0 0 0 0 0
Solver 7.984 Computing-load-vector-End 0 0 0 0 0 0 0 0 0 0 0 0 0 0 0 0 0 0 0 0 0 0 0 0 0 0 0 0
Solver 8.013 FFEPlus-Solver-start 0 0 0 0 0 0 0 0 0 0 0 0 0 0 0 0 0 0 0 0 0 0 0 0 0 0 0 0
Solver 11.398 FFEPlus-Solver-End 0 0 0 0 0 0 0 0 0 0 0 0 0 0 0 0 0 0 0 0 0 0 0 0 0 0 0 0
Solver 12.769 Computing-stresses-for-load-case=1-Start 0 0 0 0 0 0 0 0 0 0 0 0 0 0 0 0 0 0 0 0 0 0 0 0 0 0 0 0
Solver 12.776 Computing-reaction-forces-for-load-case(LCASE)=1-Start 0 0 0 0 0 0 0 0 0 0 0 0 0 0 0 0 0 0 0 0 0 0 0 0 0 0 0 0
Solver 15.076 Computing-reaction-forces-for-load-case(LCASE)=1-End 0 0 0 0 0 0 0 0 0 0 0 0 0 0 0 0 0 0 0 0 0 0 0 0 0 0 0 0
Solver 15.114 Computing-stresses-for-load-case=1-End 0 0 0 0 0 0 0 0 0 0 0 0 0 0 0 0 0 0 0 0 0 0 0 0 0 0 0 0
Solver 15.155 Linear-static-solver-End 0 0 0 0 0 0 0 0 0 0 0 0 0 0 0 0 0 0 0 0 0 0 0 0 0 0 0 0
SOLVER TYPE= FFEPlus (PCG Iterative Solver)
Number of Equations (NEQ)=260382
Number of Nodal points (NUMNP)=86795
Number of Pseudo nodes (NUMPS)=0
Number of Elements (NUME)=60896
Number of Pseudo Elements (NUMP)=0
SOLUTION TIME LOG
Time for Input Data Transfer from Database =1.065000
TIME FOR CALCULATION OF STRUCTURE STIFFNESS MATRIX (STF_PHASE)=0.011000
TIME FOR FFEPlus (PCG ITERATIVE SOLVER) =3.387000
TIME FOR GAP & CONTACT ITERATIONS (CNT_PHASE)=0.000000
TIME FOR REACTION FORCE & DISP UPDATE TO POST (REC_PAHS)=1.364000
TIME FOR STRESS CALCULATION (STS_PHASE)=2.345000
TIME FOR WRITING POST PROCESSING INFORMATION (PST_PHASE)=0.007000
TOTAL SOLUTION TIME (TOT_TIME)=8.194000
