arma966/ProgettazioneMeccanica2020/SolidWorks/Simulazioni/AsseSim-VerificaForo90-BenchMark.txt

MeshAndRun BenchMark 

Host = 

CPU = Intel(R) Core(TM) i7-7700HQ CPU @ 2.80GHz 10000MHz

Number of CPU = 8

Physical Memory = 16GB

OS = Windows 10 18363

SWVersion = SOLIDWORKS 2018_SP3.0

User = Davide

Mesher Type = STD

Element Size =  0.0106421m

Tolerance =  0.000532104m

Mesh 0.000 CreateMesh-Start 0 0 0 0 0 0 0 0 0 0 0 0 0 0 0 0 0 0 0 0 0 0 0 0 0 0 0 0

Mesh 0.000 MeshPreprocessing-Start 0 0 0 0 0 0 0 0 0 0 0 0 0 0 0 0 0 0 0 0 0 0 0 0 0 0 0 0

Mesh 0.000 MeshPreparation-Start 0 0 0 0 0 0 0 0 0 0 0 0 0 0 0 0 0 0 0 0 0 0 0 0 0 0 0 0

Mesh 0.024 MeshPreparation-End 0 0 0 0 0 0 0 0 0 0 0 0 0 0 0 0 0 0 0 0 0 0 0 0 0 0 0 0

Mesh 0.024 JointContactCheck-Start 0 0 0 0 0 0 0 0 0 0 0 0 0 0 0 0 0 0 0 0 0 0 0 0 0 0 0 0

Mesh 0.024 JointContactCheck-End 0 0 0 0 0 0 0 0 0 0 0 0 0 0 0 0 0 0 0 0 0 0 0 0 0 0 0 0

Mesh 0.024 MeshPreprocessing-End 0 0 0 0 0 0 0 0 0 0 0 0 0 0 0 0 0 0 0 0 0 0 0 0 0 0 0 0

Mesh 0.026 SolidMesh-Start 0 0 0 0 0 0 0 0 0 0 0 0 0 0 0 0 0 0 0 0 0 0 0 0 0 0 0 0

Mesh 0.355 SetMemoryCopySolid-Start 0 0 0 0 0 0 0 0 0 0 0 0 0 0 0 0 0 0 0 0 0 0 0 0 0 0 0 0

Mesh 0.387 SetMemoryCopySolid-End 0 0 0 0 0 0 0 0 0 0 0 0 0 0 0 0 0 0 0 0 0 0 0 0 0 0 0 0

Mesh 0.387 ImprintAndSplit-Start 0 0 0 0 0 0 0 0 0 0 0 0 0 0 0 0 0 0 0 0 0 0 0 0 0 0 0 0

Mesh 0.388 ImprintAndSplit-End 0 0 0 0 0 0 0 0 0 0 0 0 0 0 0 0 0 0 0 0 0 0 0 0 0 0 0 0

Mesh 0.388 TransferMeshControl-Start 0 0 0 0 0 0 0 0 0 0 0 0 0 0 0 0 0 0 0 0 0 0 0 0 0 0 0 0

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
TOTAL SOLUTION TIME (TOT_TIME)=8.194000

Solver 15.390 Solver-End 0 0 0 0 0 0 0 0 0 0 0 0 0 0 0 0 0 0 0 0 0 0 0 0 0 0 0 0

Post 15.426 ShowFirstPlot-Start 0 0 0 0 0 0 0 0 0 0 0 0 0 0 0 0 0 0 0 0 0 0 0 0 0 0 0 0

Post 16.652 ShowFirstPlot-End 0 0 0 0 0 0 0 0 0 0 0 0 0 0 0 0 0 0 0 0 0 0 0 0 0 0 0 0

!Phase,Wall,Mark,UCPU,SCPU,WSP,WS,CPU,QPPP,QPP,QNPPP,QNPP,PF,PPF,HNDL,VB,PVB,PID,0,FP,MaxFP,Read,Write,Sim_Read_Calls,Sim_Read_Time,BulkReadBytesReq,Sim_Read_Bytes,Sim_Write_Calls,Sim_Write_time,BulkWriteBytesReq,Sim_Write_Bytes  

!Only Phase, Wall, Mark are valid output.
