arma966/ProgettazioneMeccanica2020/Relazione/imgs/Golf2.pdf

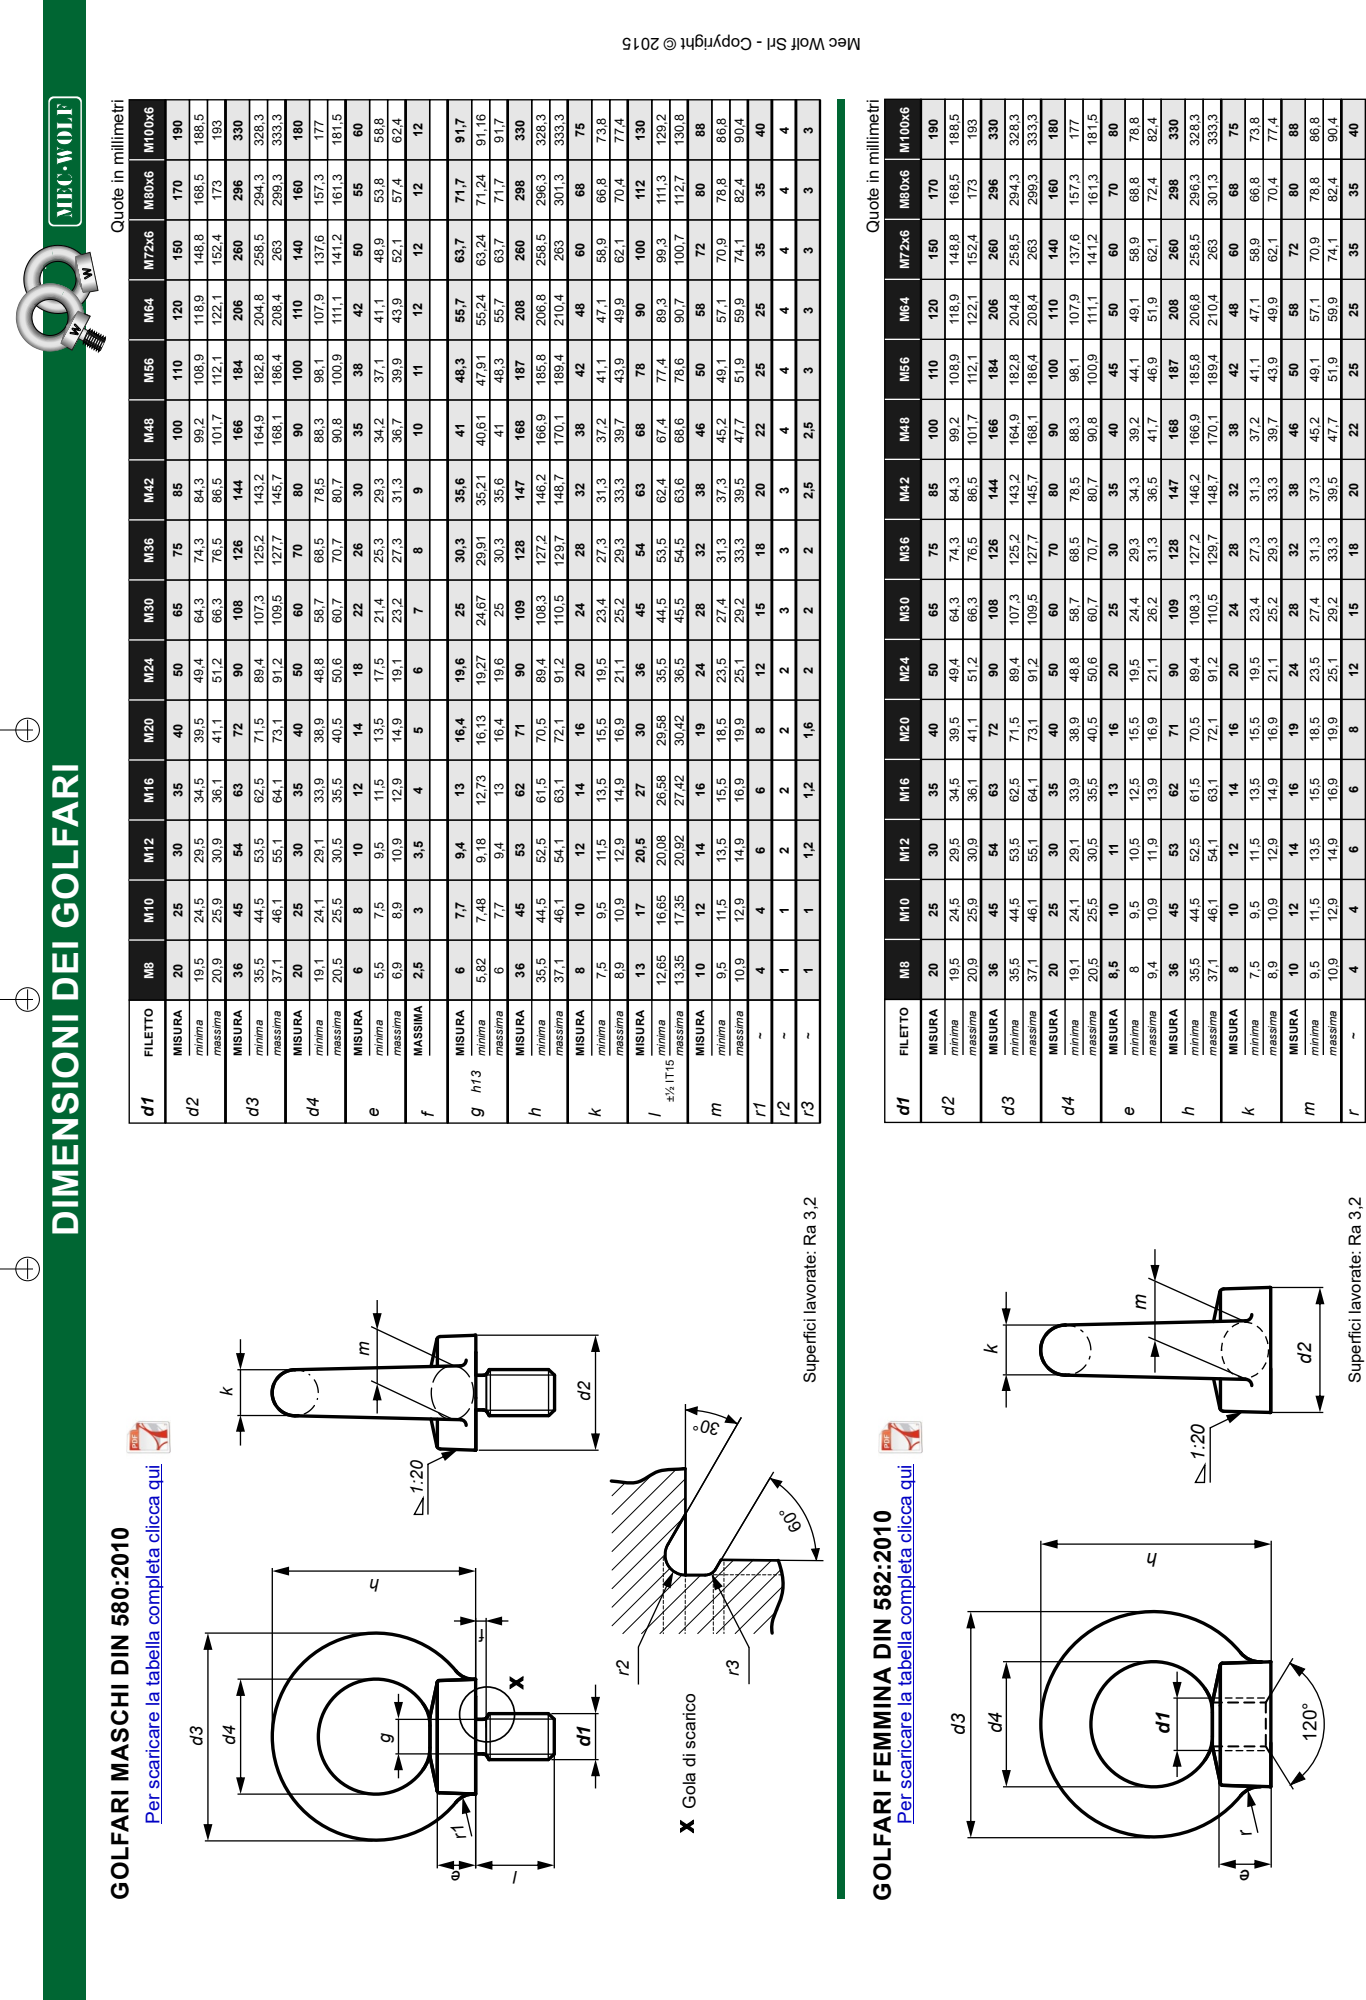
[picture p122: page 1]
FILETTO d1; MISURA; MASSIMA; minima; massima

Quote in millimetri

DIMENSIONI DEI GOLFARI

Superfici lavorate: Ra 3,2

Per scaricare la tabella completa clicca qui

GOLFARI FEMMINA DIN 582:2010

GOLFARI MASCHI DIN 580:2010

Gola di scarico
