arma966/ProgettazioneMeccanica2020/Relazione/imgs/MathAsse2_1.pdf

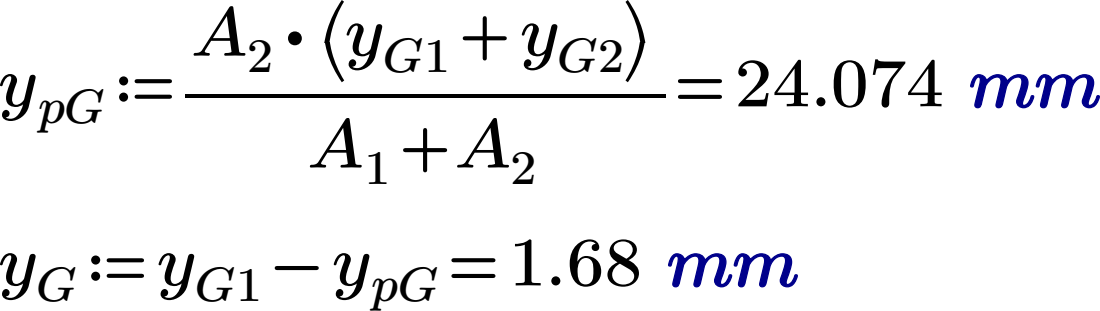
[picture p123: page 1]
ypG≔―――――= A ⋅ 2

yG≔yG1−ypG =1.68 mm
