arma966/ProgettazioneMeccanica2020/SolidWorks/Ref/carter_circolare_00_disegno_tecnico.pdf

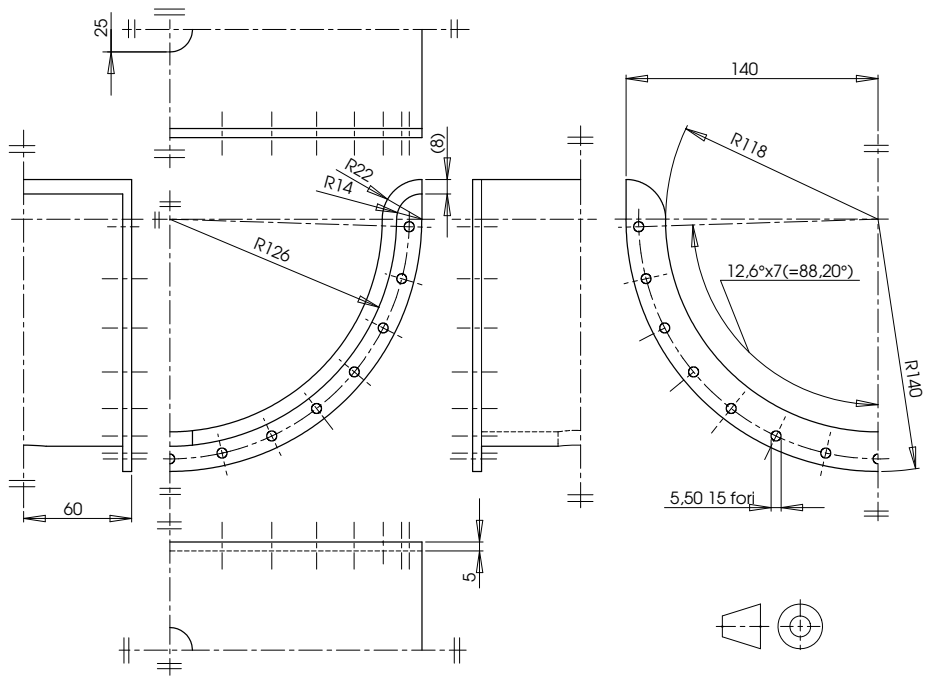
[picture p124: page 1]
5,50 15 fori
