arma966/ProgettazioneMeccanica2020/SolidWorks/Ref/irrigidimento_circolare_esterno_00_disegno_tecnico.pdf

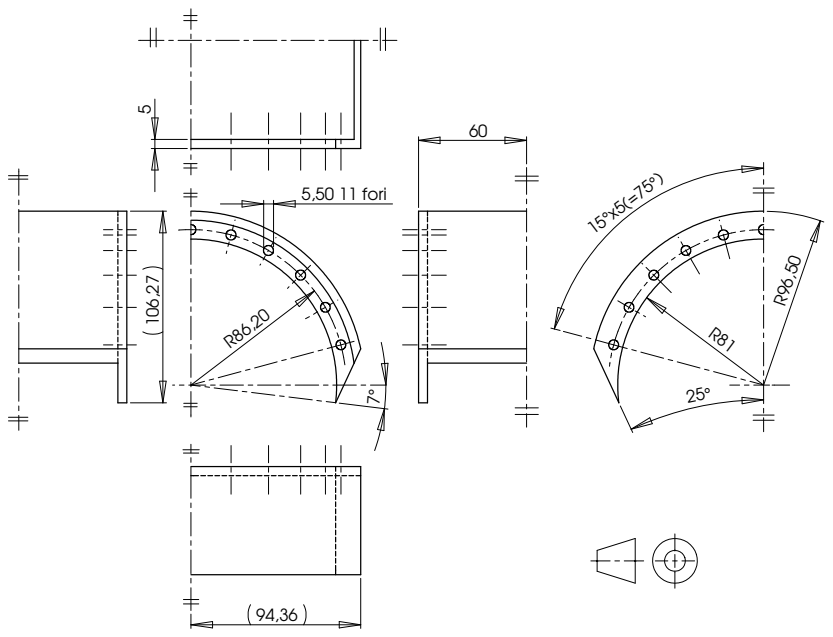
[picture p125: page 1]
5,50 11 fori
