arma966/ProgettazioneMeccanica2020/SolidWorks/Ref/irrigidimento_esterno_00_disegno_tecnico.pdf

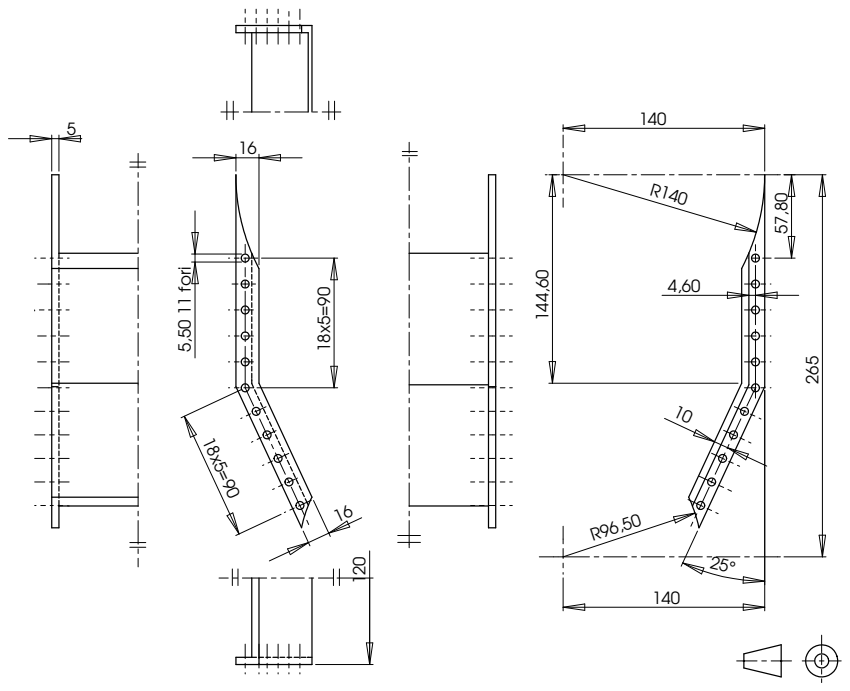
[picture p126: page 1]
5,50 11 fori
