arma966/ProgettazioneMeccanica2020/SolidWorks/Ref/piastrone_00_disegno_tecnico.pdf

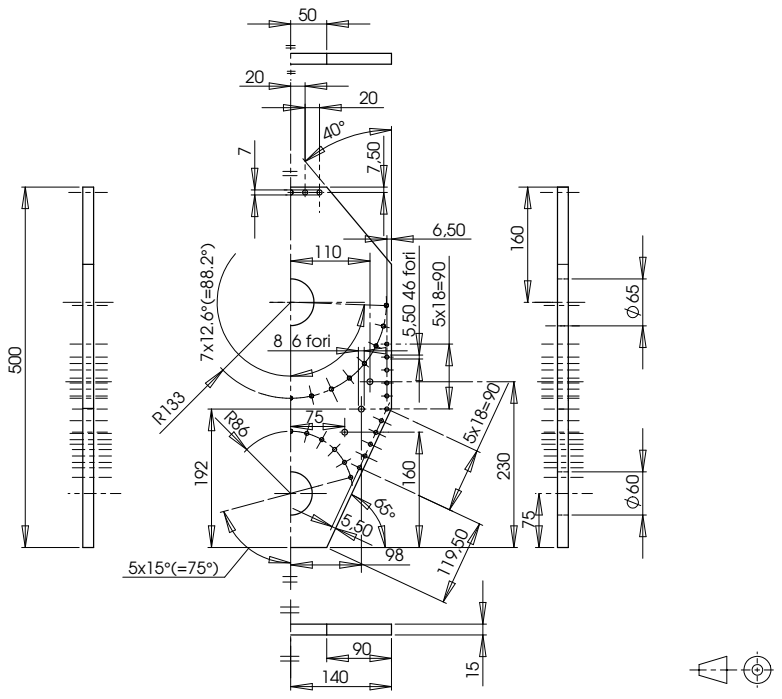
[picture p127: page 1]
6 fori; 46 fori
