arma966/ProgettazioneMeccanica2020/SolidWorks/Ref/puleggia_00_disegno_tecnico.pdf

A

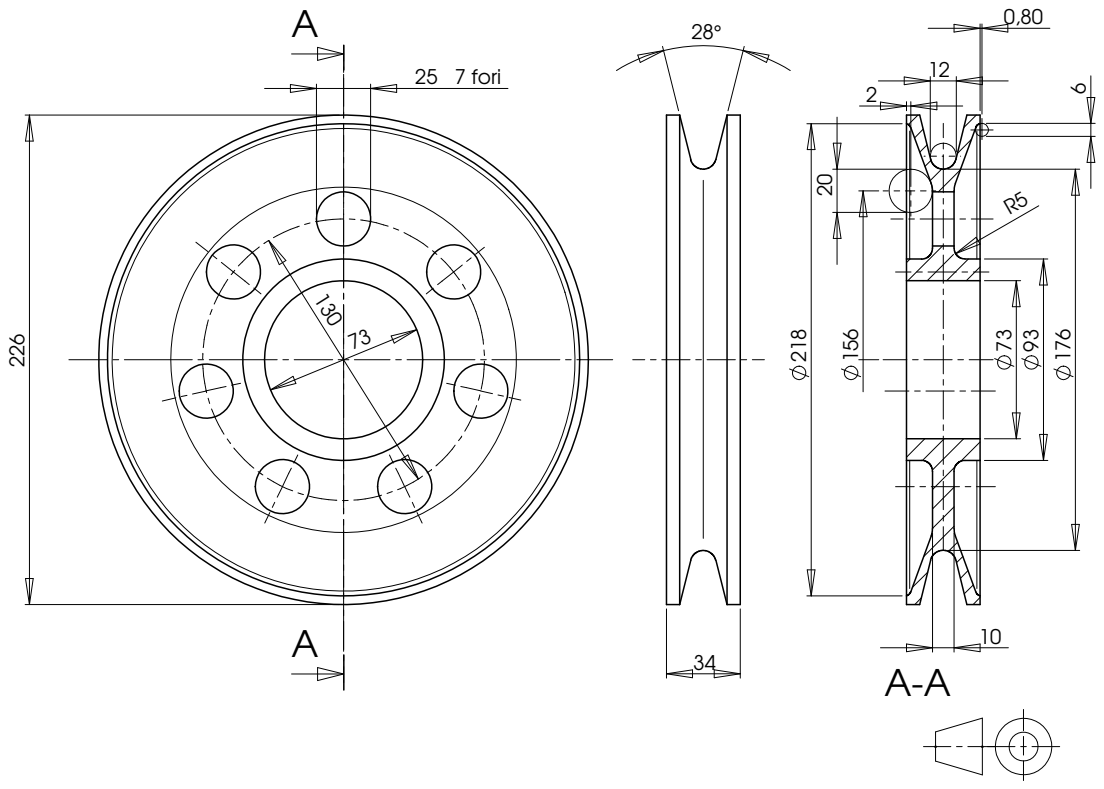
[picture p128: page 1]
25 7 fori
