arma966/ProgettazioneMeccanica2020/SolidWorks/Ref/traversa_00 - disegno_tecnico.pdf

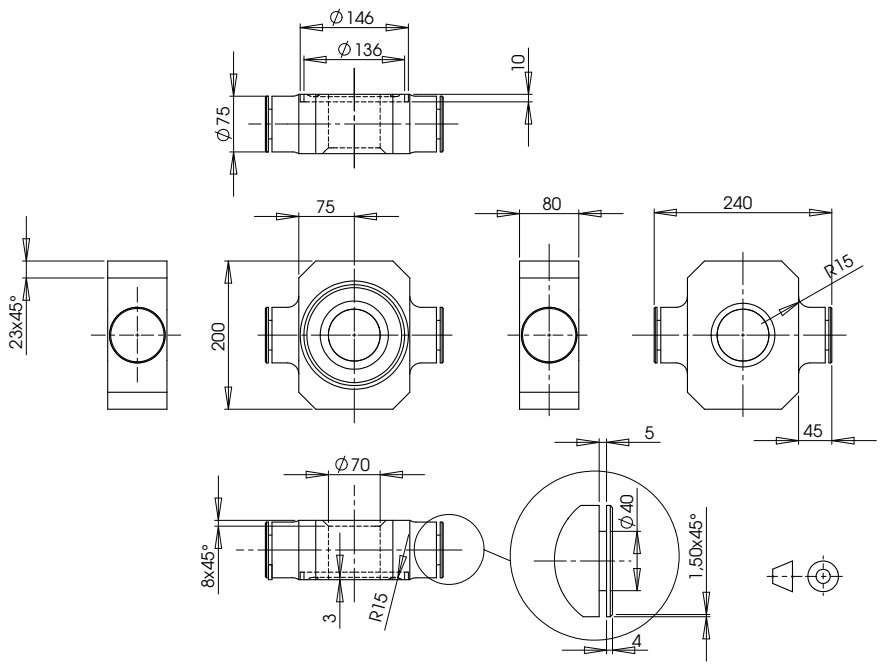
[picture p129: page 1]
