arma966/ProgettazioneMeccanica2020/Relazione/imgs/Carr1.pdf

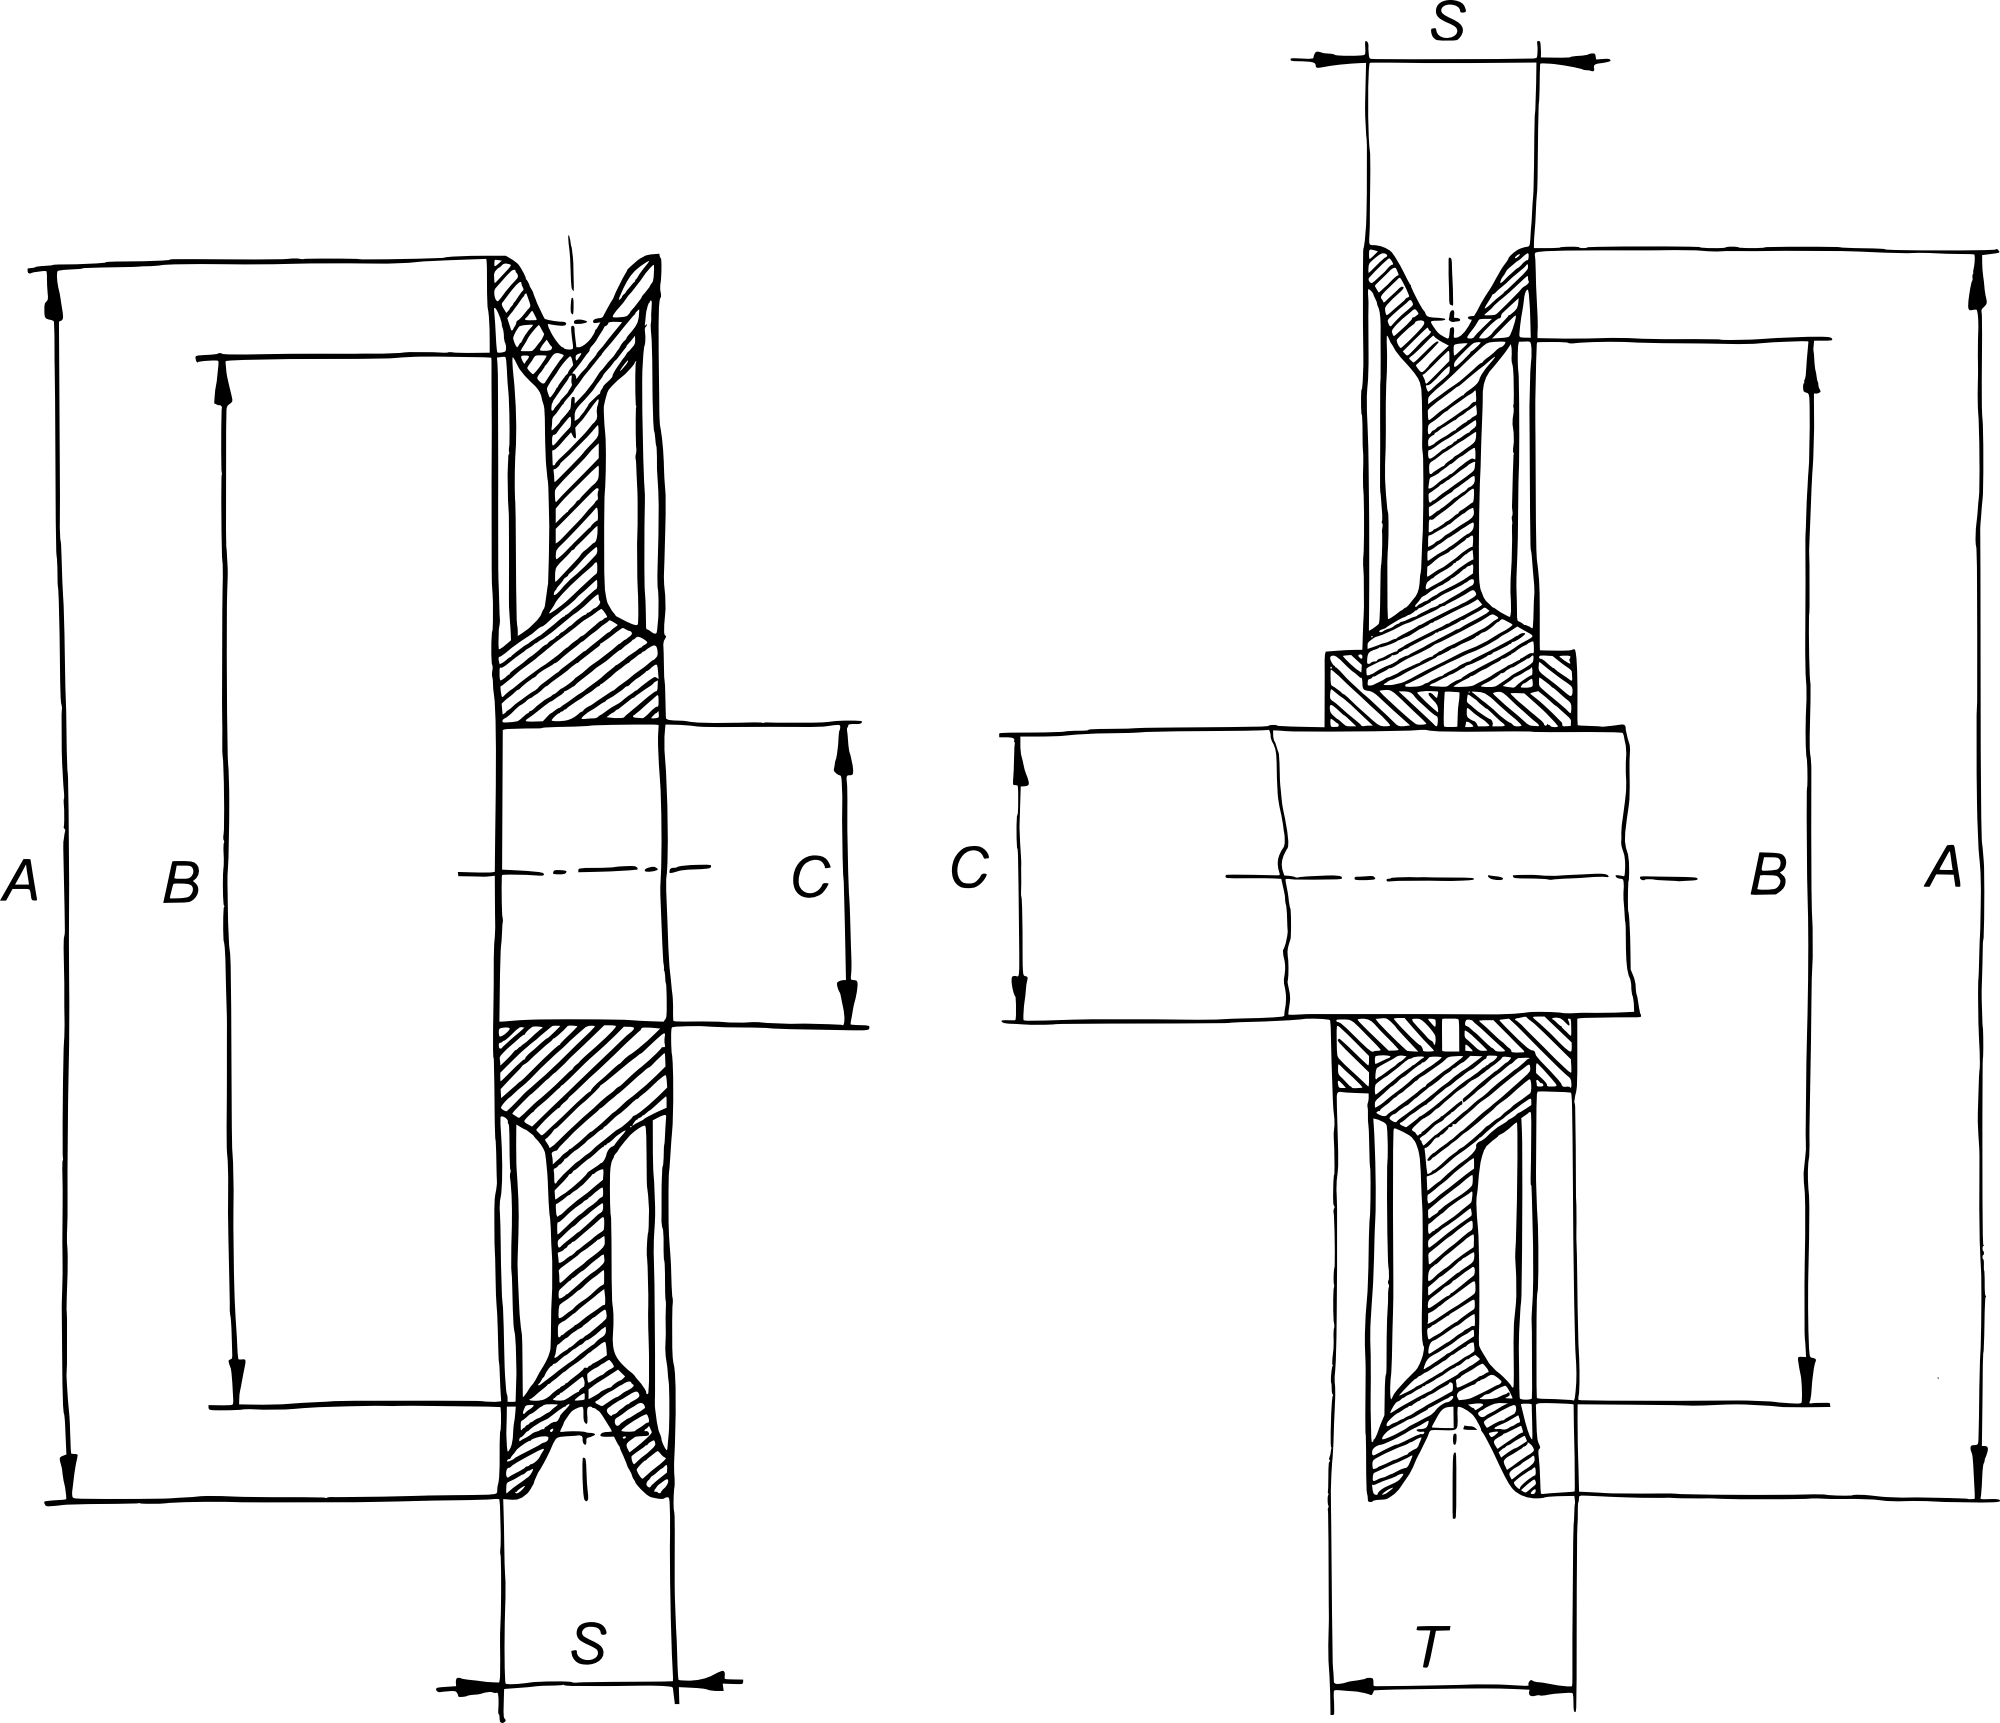
[picture p130: page 1]
