arma966/ProgettazioneMeccanica2020/Relazione/imgs/Carr2.pdf

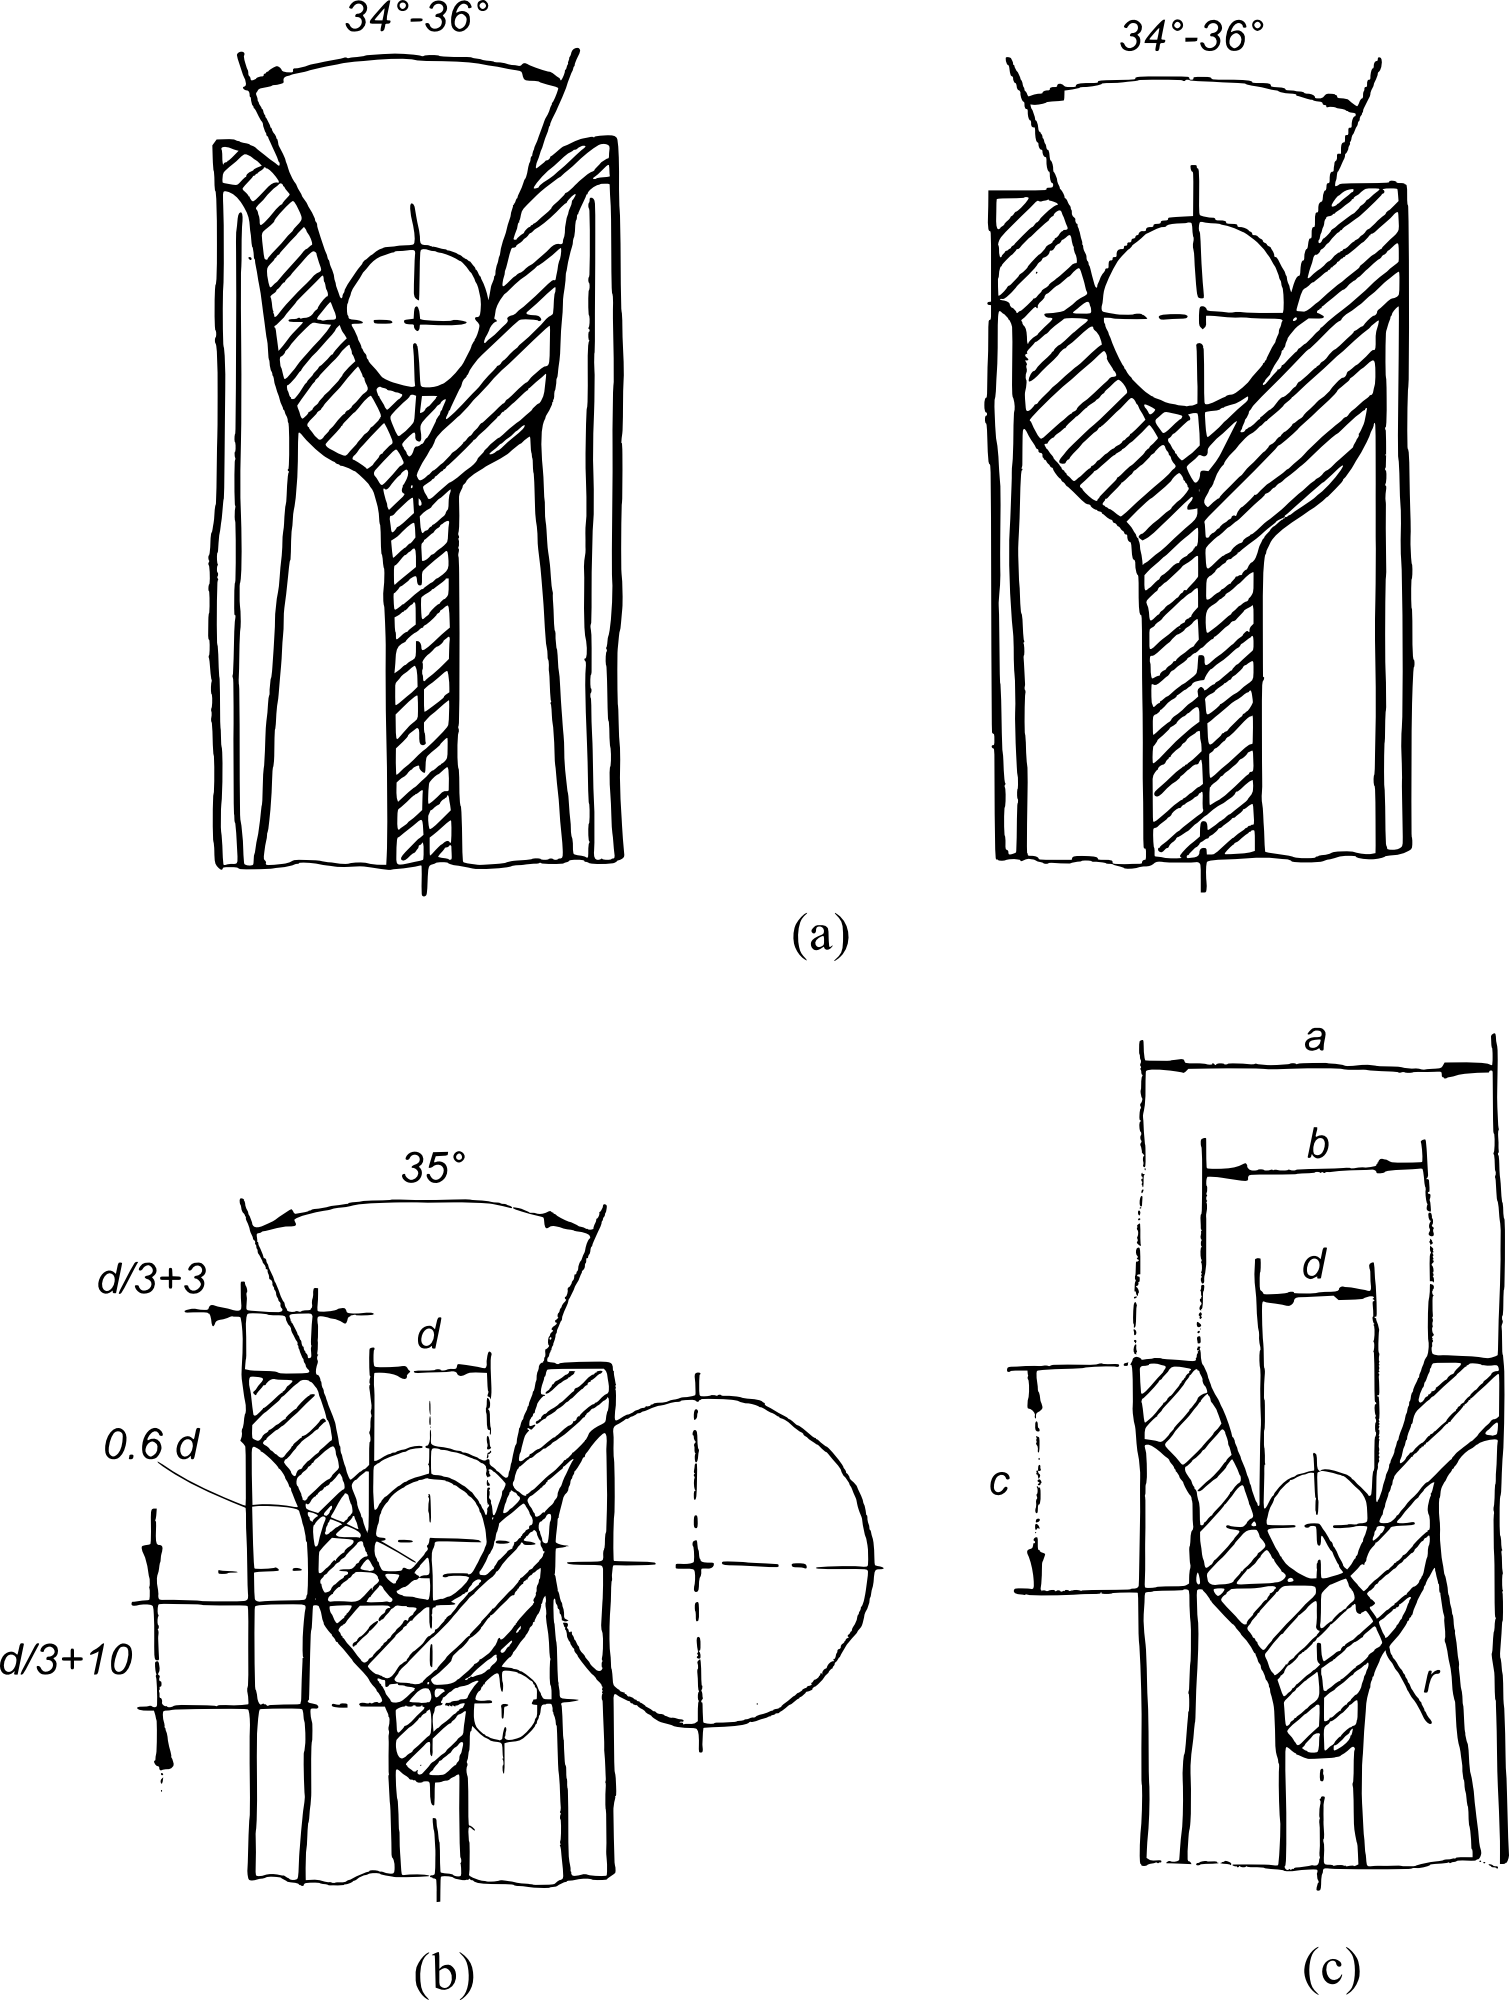
[picture p131: page 1]
