arma966/ProgettazioneMeccanica2020/Relazione/imgs/Golf1.pdf

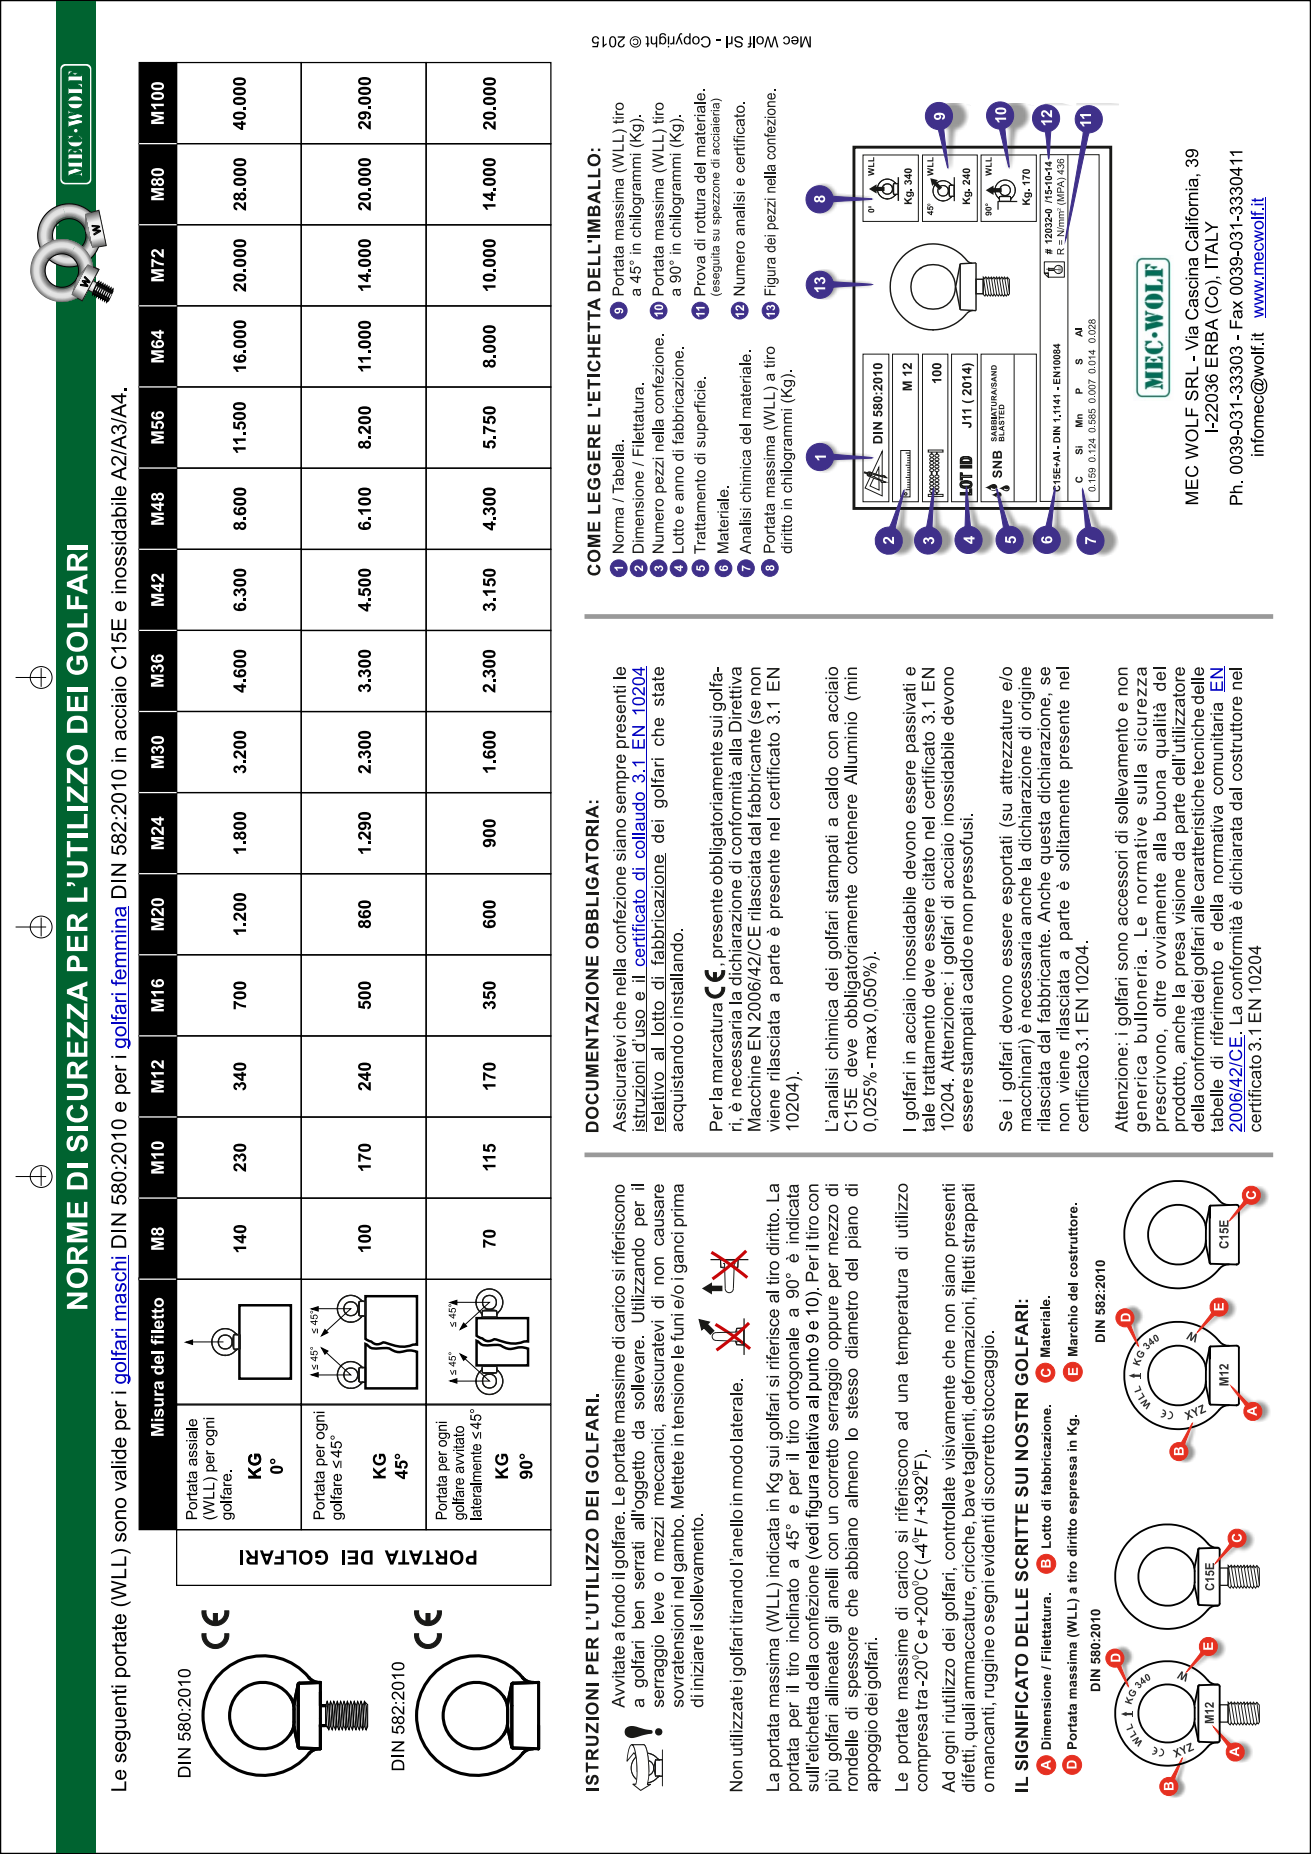
[picture p132: page 1]
