arma966/ProgettazioneMeccanica2020/Relazione/imgs/MathAsse1.pdf

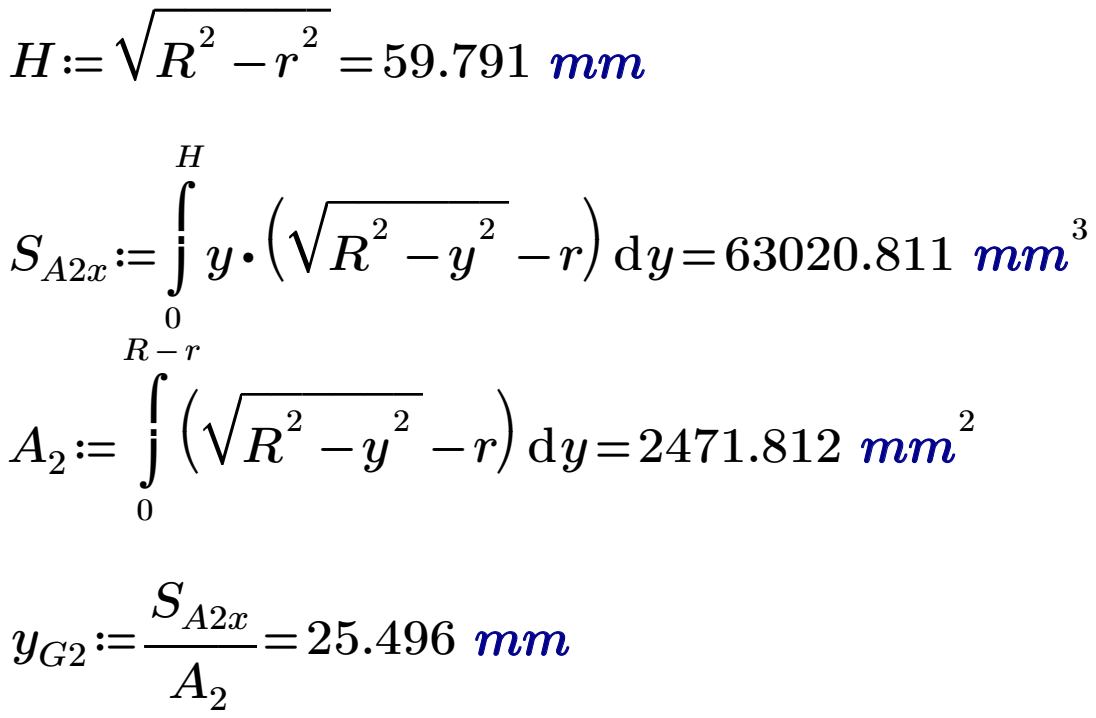
[picture p133: page 1]
