arma966/ProgettazioneMeccanica2020/Relazione/imgs/MathAsse3.pdf

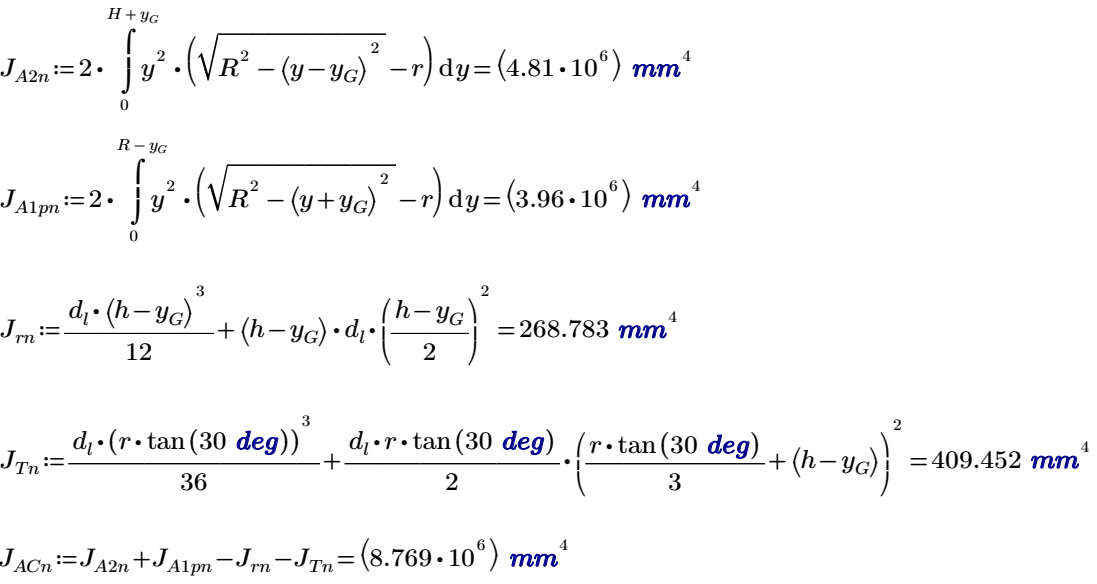
[picture p134: page 1]
Jrn≔――――+; JTn≔―――――――+; r ⋅ tan; ( 30 deg; ――――――⋅ d ⋅ ⋅ l r tan; 30 deg; JACn≔JA2n; JA1pn−Jrn−JTn=⎛ ⎝
