arma966/ProgettazioneMeccanica2020/Relazione/imgs/MathAsse4_1.pdf

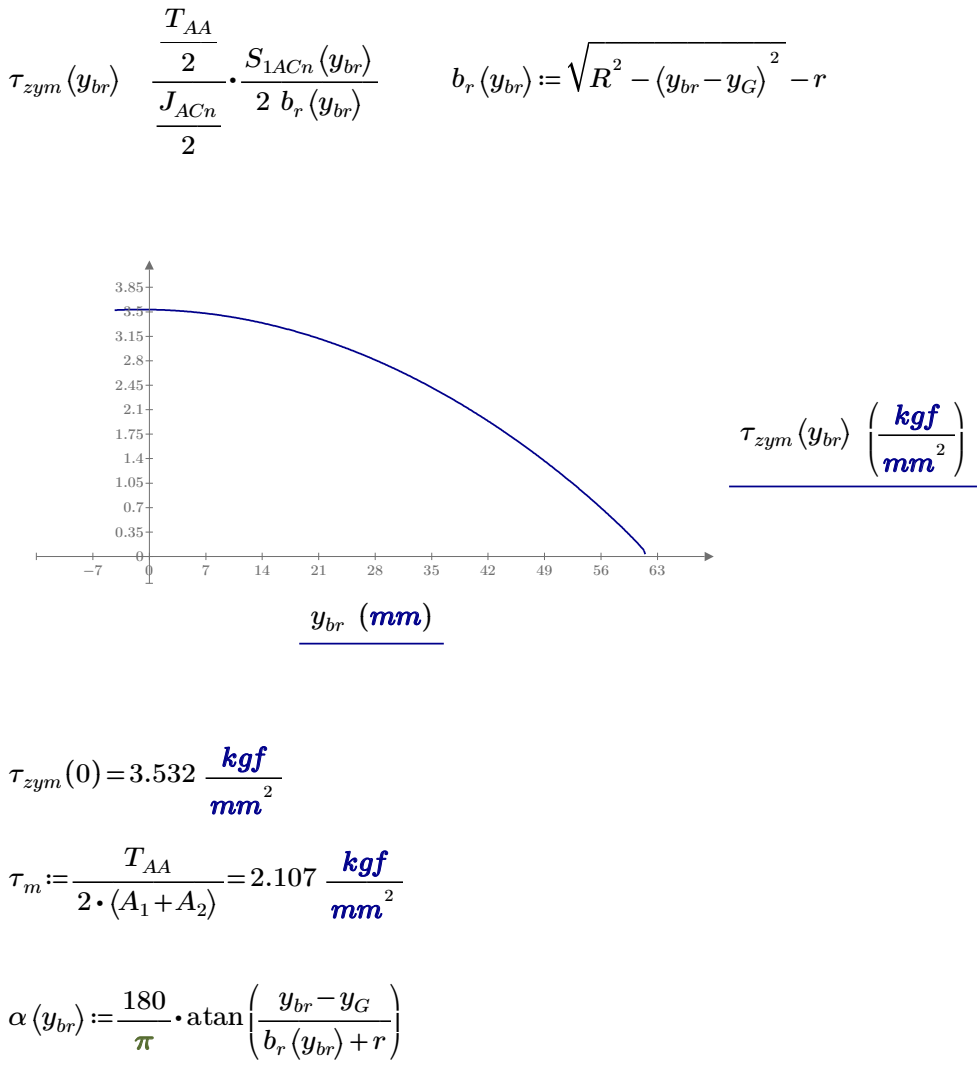
[picture p135: page 1]
τzym; ybr; ――TAA 2 ――JACn 2; ―――― S1ACn; τm ≔――――= TAA 2⋅ ⎛ ⎝; atan⎛ ⎜ ⎝; ―――― ybr−yG br ⎛ ⎝; ybr−yG
