arma966/ProgettazioneMeccanica2020/Relazione/imgs/MathAsse4_2.pdf

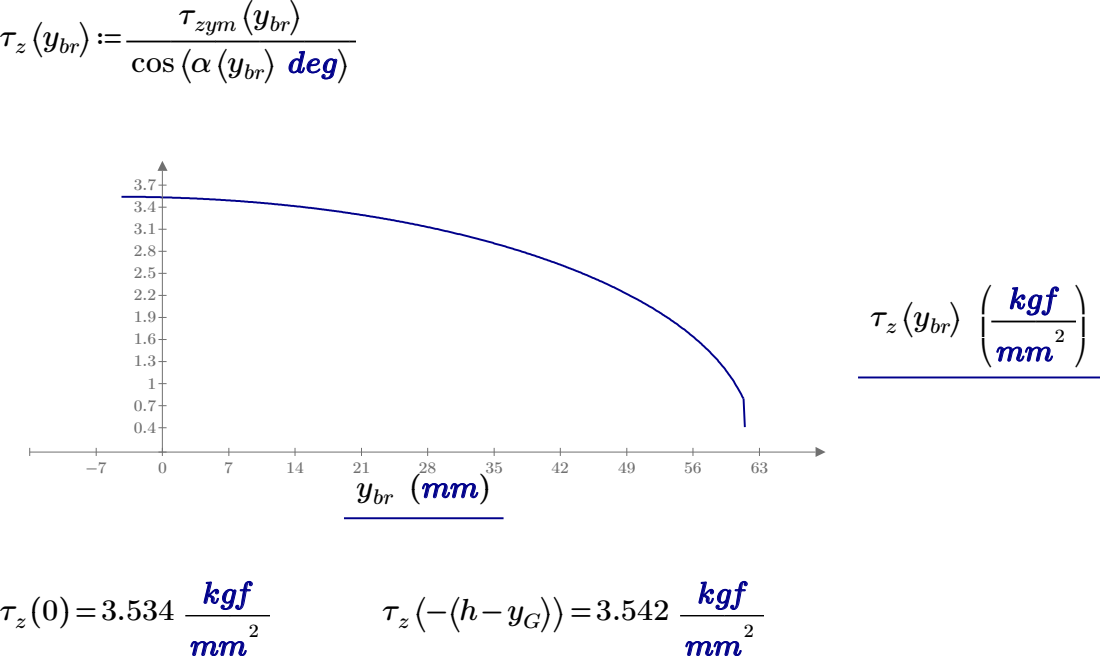
[picture p136: page 1]
ybr; ⎞⎠≔―――――― τzym; cos; deg; ⎝ybr⎞⎠
