arma966/ProgettazioneMeccanica2020/Relazione/imgs/MathAsse5_2.pdf

### τzym

⎛

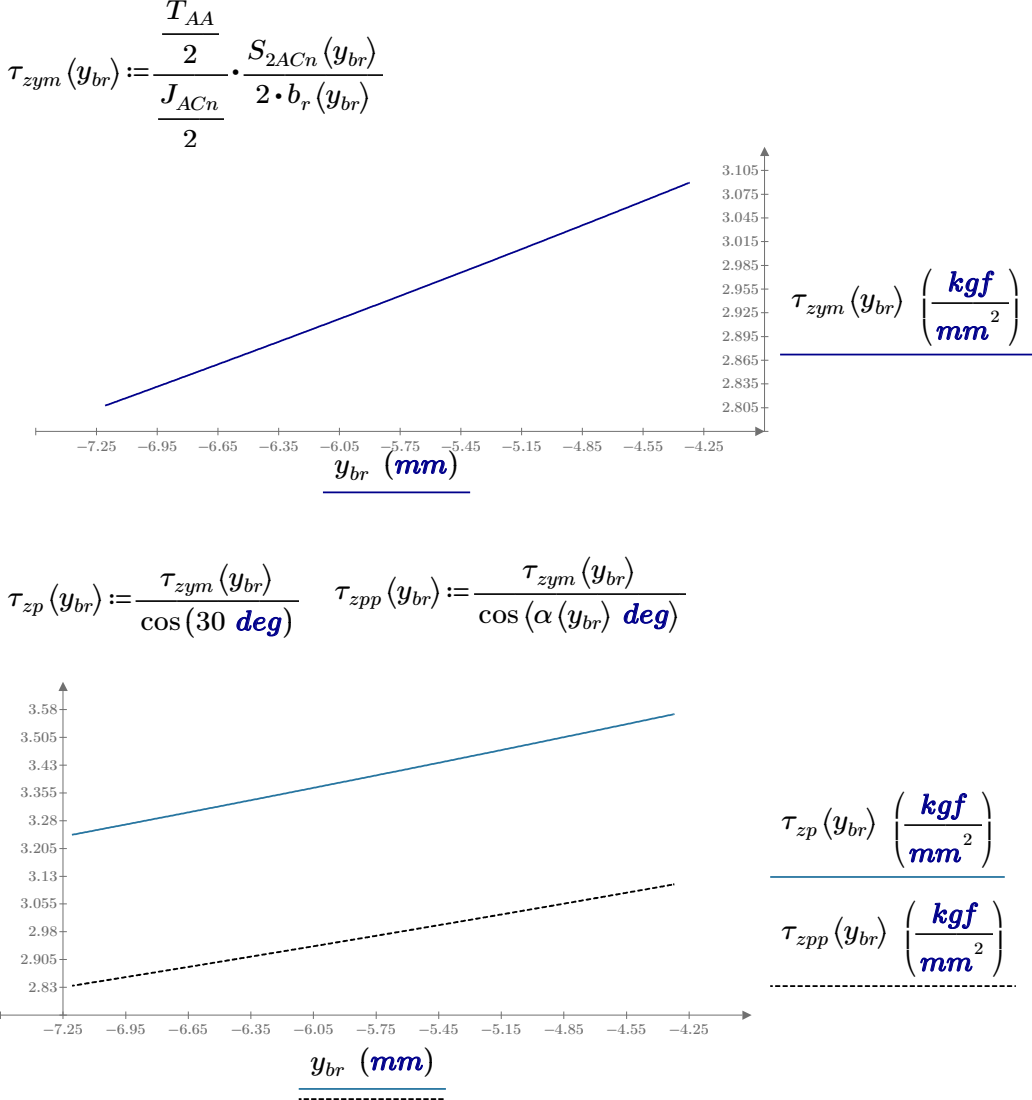
[picture p137: page 1]
ybr; ――TAA 2 ――JACn 2; ―――― S2ACn; -7.25 -6.95 -6.65 -6.35 -6.05 -5.75 -5.45 -5.15 -4.85 -4.55 -4.25 ybr; τzym; τzp; ⎞⎠≔―――― τzym; cos; (( 30 deg; τzpp; ⎞⎠≔―――――― τzym; deg
