arma966/ProgettazioneMeccanica2020/Relazione/imgs/MathAsse6_2.pdf

### τzym

⎛

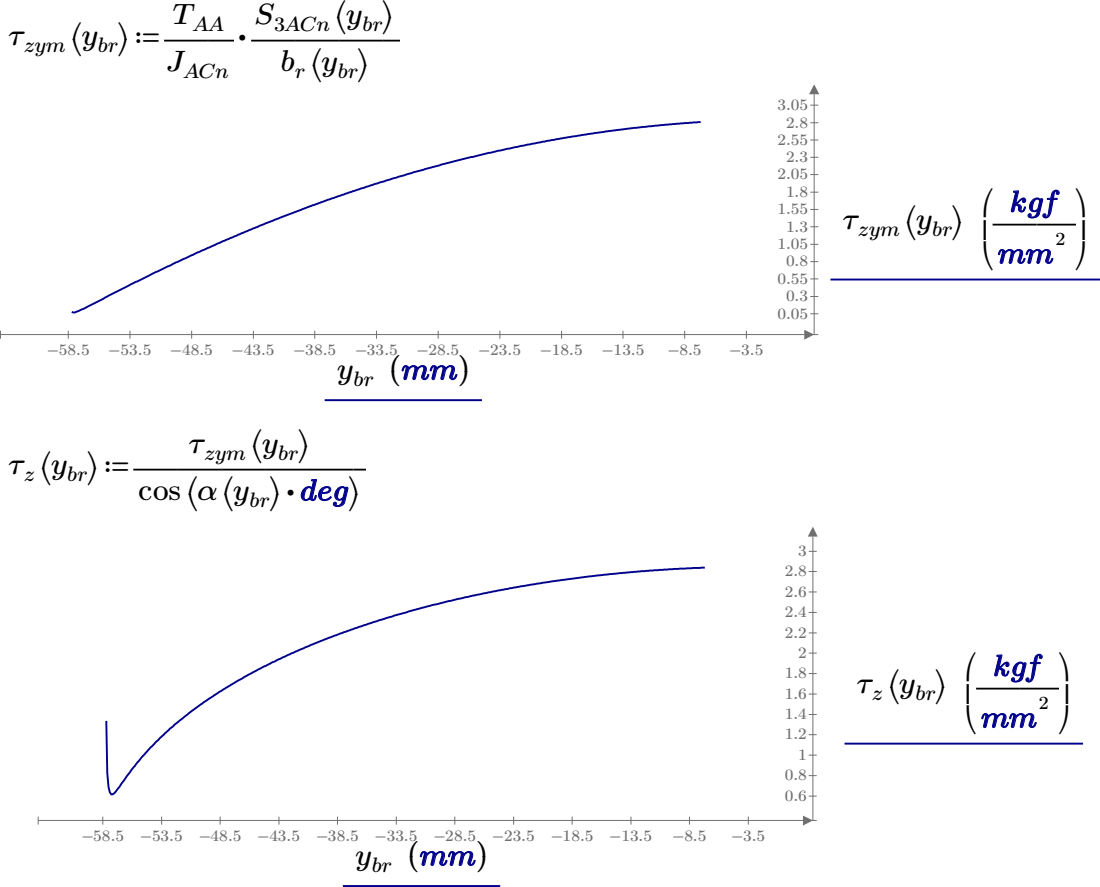
[picture p138: page 1]
ybr; ⎞⎠≔――⋅ TAA; JACn; ―――― S3ACn; τzym; ⎞⎠≔―――――― τzym ⎛; ⎝ybr⎞⎠; cos; deg
