arma966/ProgettazioneMeccanica2020/Relazione/imgs/MathAsse7_1.pdf

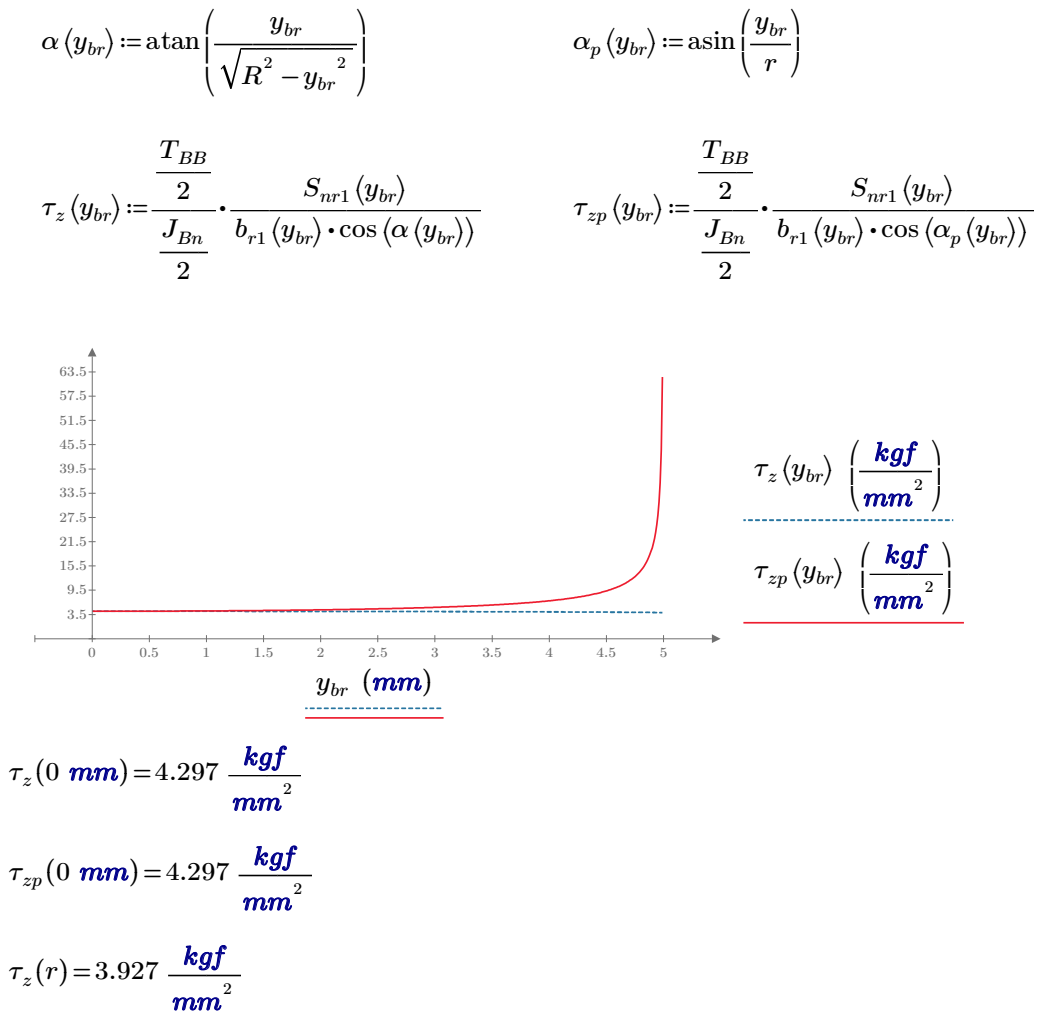
[picture p139: page 1]
ybr; ⎞⎠≔atan⎛ ⎜ ⎝; ―――― ybr; ⎞⎠≔asin⎛ ⎜ ⎝; ――ybr r; ――TBB 2 ――JBn 2; ――――――― Snr1; cos; τzp
