arma966/ProgettazioneMeccanica2020/Relazione/imgs/MathAsse8_0.pdf

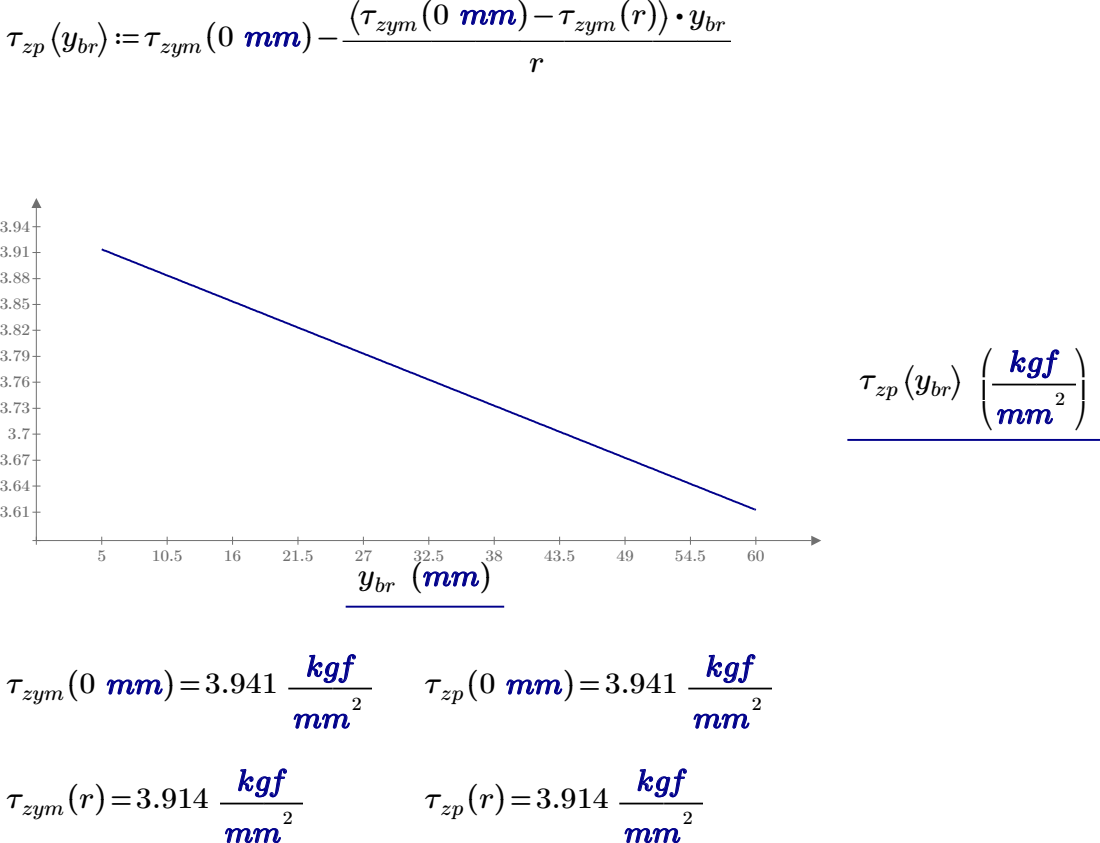
[picture p140: page 1]
τzp; ybr; ⎞⎠≔τzym; ⋅ zym; τzym
