arma966/ProgettazioneMeccanica2020/Relazione/imgs/MathAsse8_1.pdf

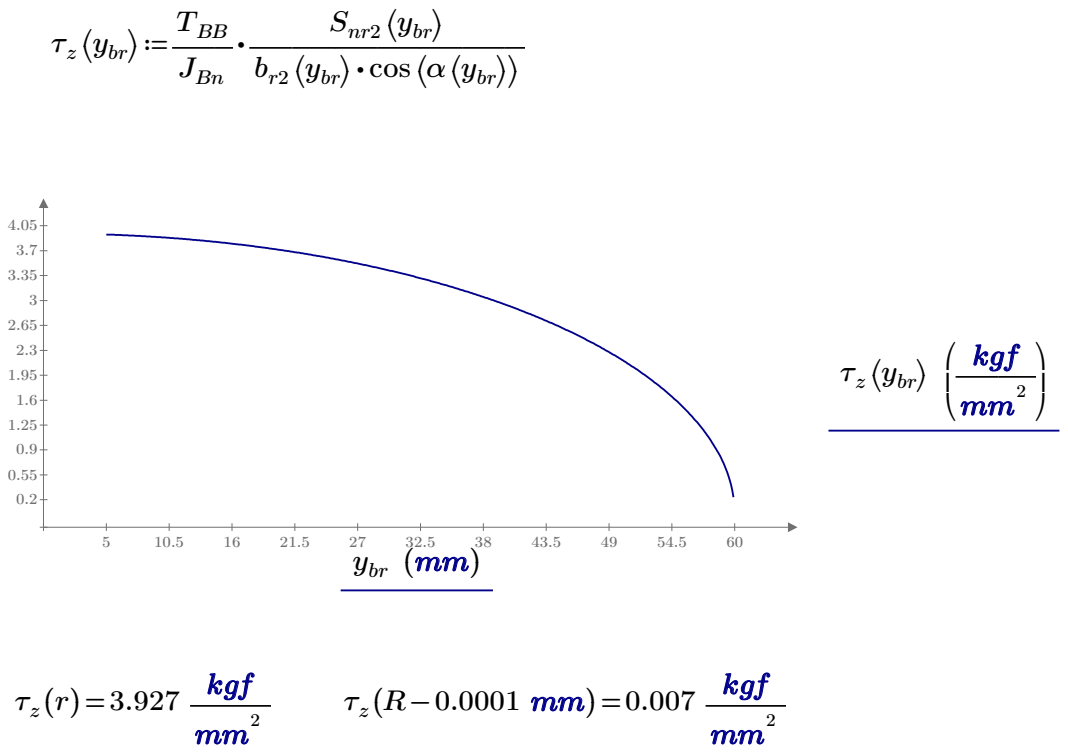
[picture p141: page 1]
ybr; ⎞⎠≔――⋅ TBB; JBn; ――――――― Snr2; cos
