arma966/ProgettazioneMeccanica2020/Relazione/imgs/MathAsse8_2.pdf

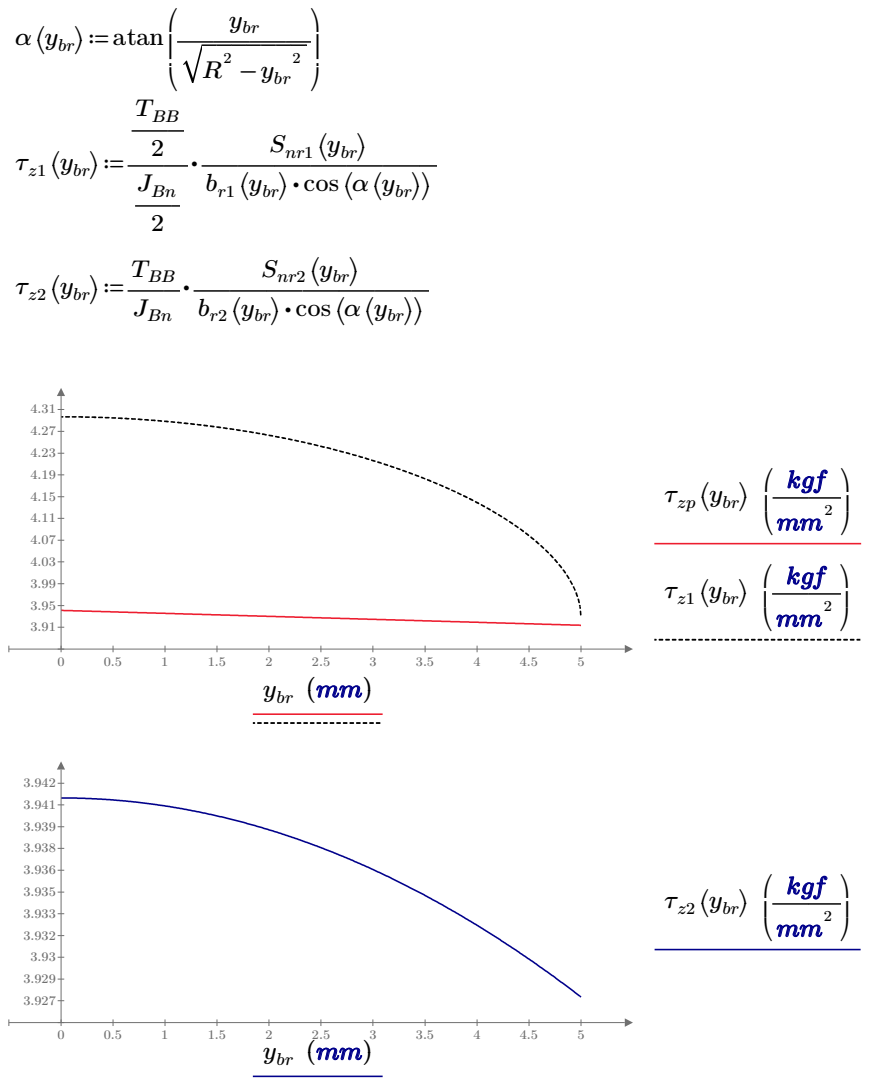
[picture p142: page 1]
ybr; ⎞⎠≔atan⎛ ⎜ ⎝; ―――― ybr; ――TBB 2 ――JBn 2; ――――――― Snr1; cos; ⎞⎠≔――⋅ TBB; JBn; ――――――― Snr2; τzp
