arma966/ProgettazioneMeccanica2020/Relazione/imgs/MathAsse9_0.pdf

### σBB

⎛

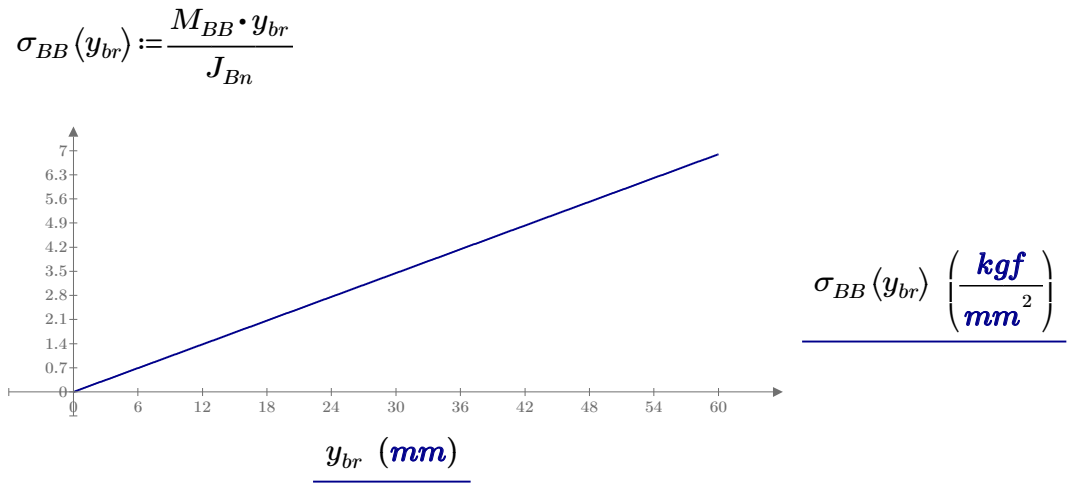
[picture p143: page 1]
ybr; ⎞⎠≔――― MBB ⋅ybr; JBn; σBB
