arma966/ProgettazioneMeccanica2020/Relazione/imgs/MathAsse9_1.pdf

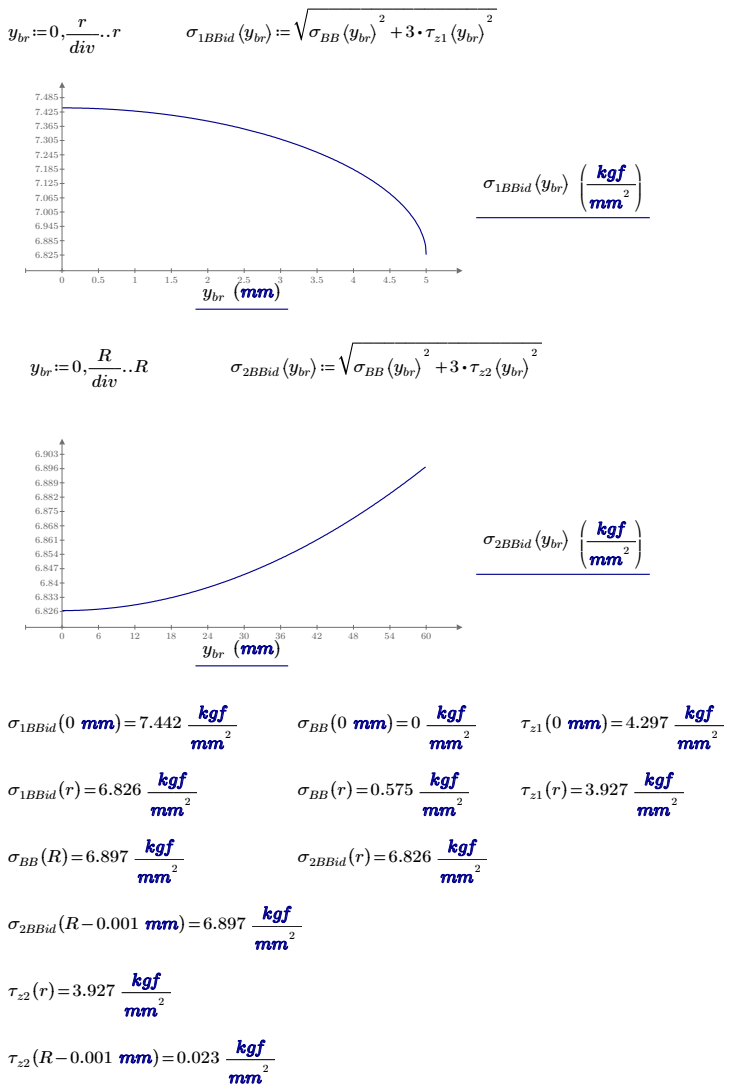
[picture p144: page 1]
σ1BBid; ybr; ⎞⎠≔ σBB; σ2BBid; ybr≔0,――‥ r div; ybr≔0,――‥ R div; σ2BBid ⎛; ⎝ybr⎞⎠; σBB
