arma966/ProgettazioneMeccanica2020/Relazione/imgs/MathAsse9_2.pdf

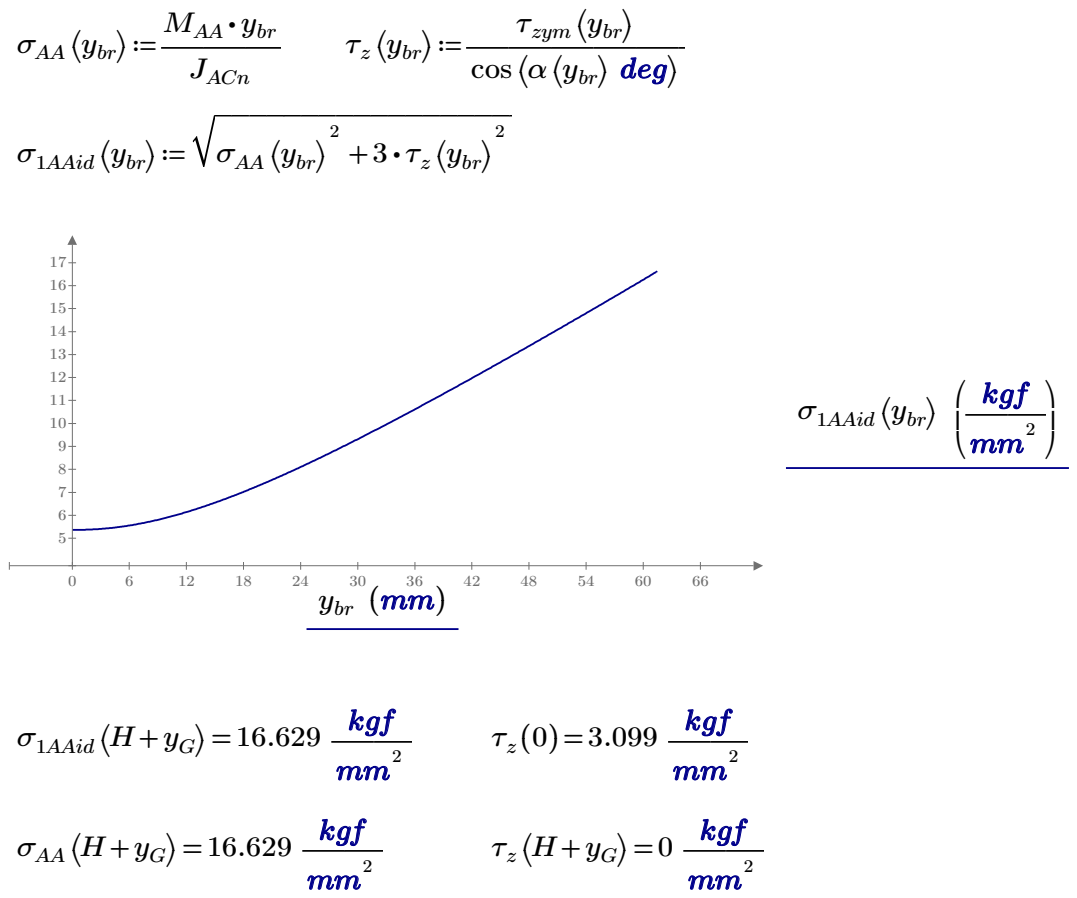
[picture p145: page 1]
ybr; ⎞⎠≔―――――― τzym; cos; deg; σ1AAid; σAA; ⎞⎠≔――― MAA ⋅ybr; JACn; ⎞⎠≔ σAA
