arma966/ProgettazioneMeccanica2020/Relazione/imgs/MathAsse9_3.pdf

### σ2AAid

⎛

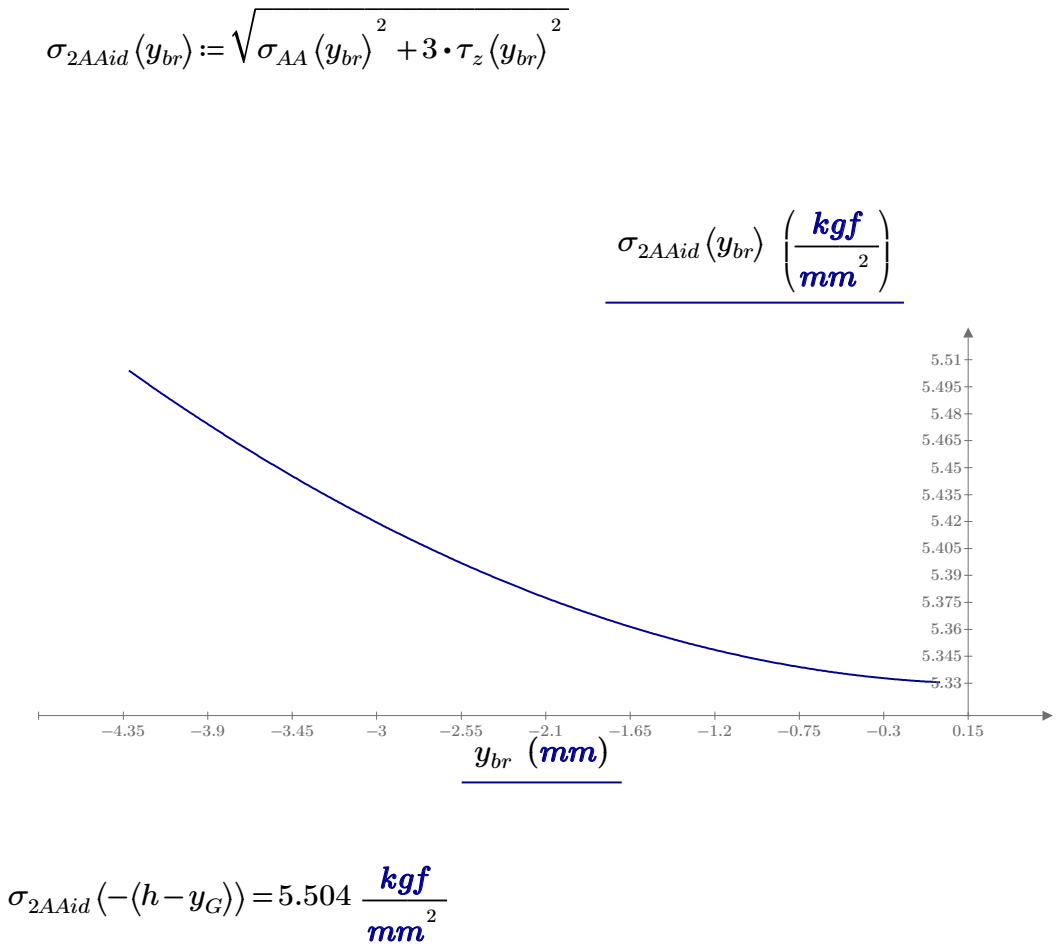
[picture p146: page 1]
ybr; ⎞⎠≔ σAA; σ2AAid
