arma966/ProgettazioneMeccanica2020/Relazione/imgs/MathAsse9_4.pdf

### σp3AAid

⎛

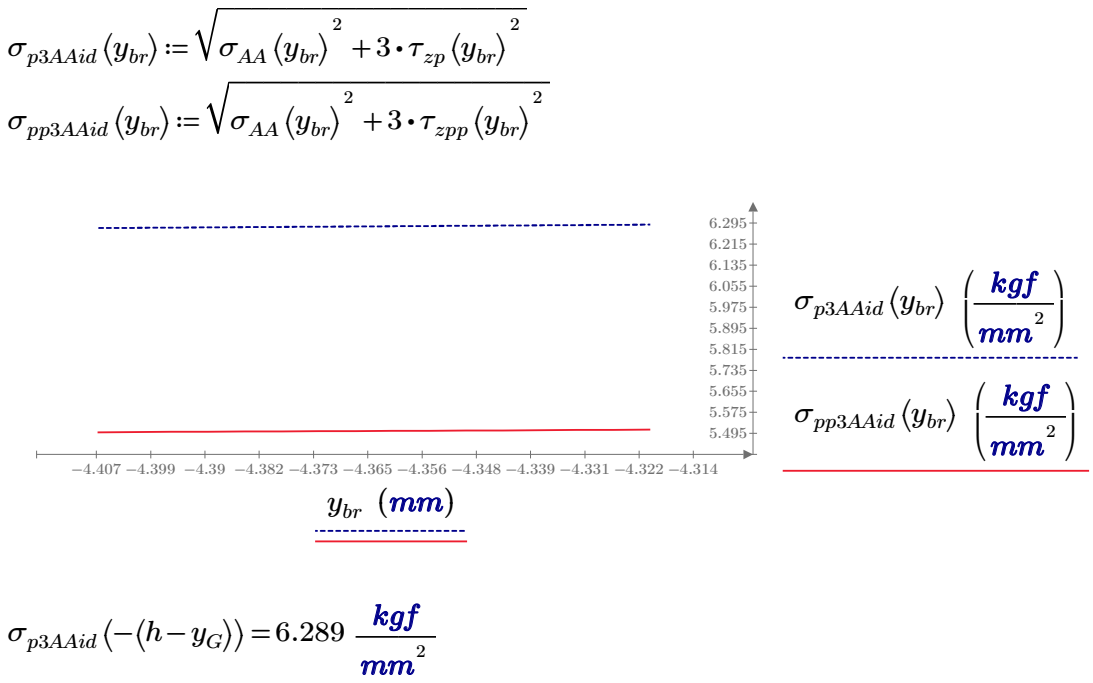
[picture p147: page 1]
ybr; ⎞⎠≔ σAA; 3⋅τzp; σpp3AAid; 3⋅τzpp; -4.407 -4.399 -4.39 -4.382 -4.373 -4.365 -4.356 -4.348 -4.339 -4.331 -4.322 -4.314 ybr; σp3AAid
