arma966/ProgettazioneMeccanica2020/Relazione/imgs/Mathcad1.pdf

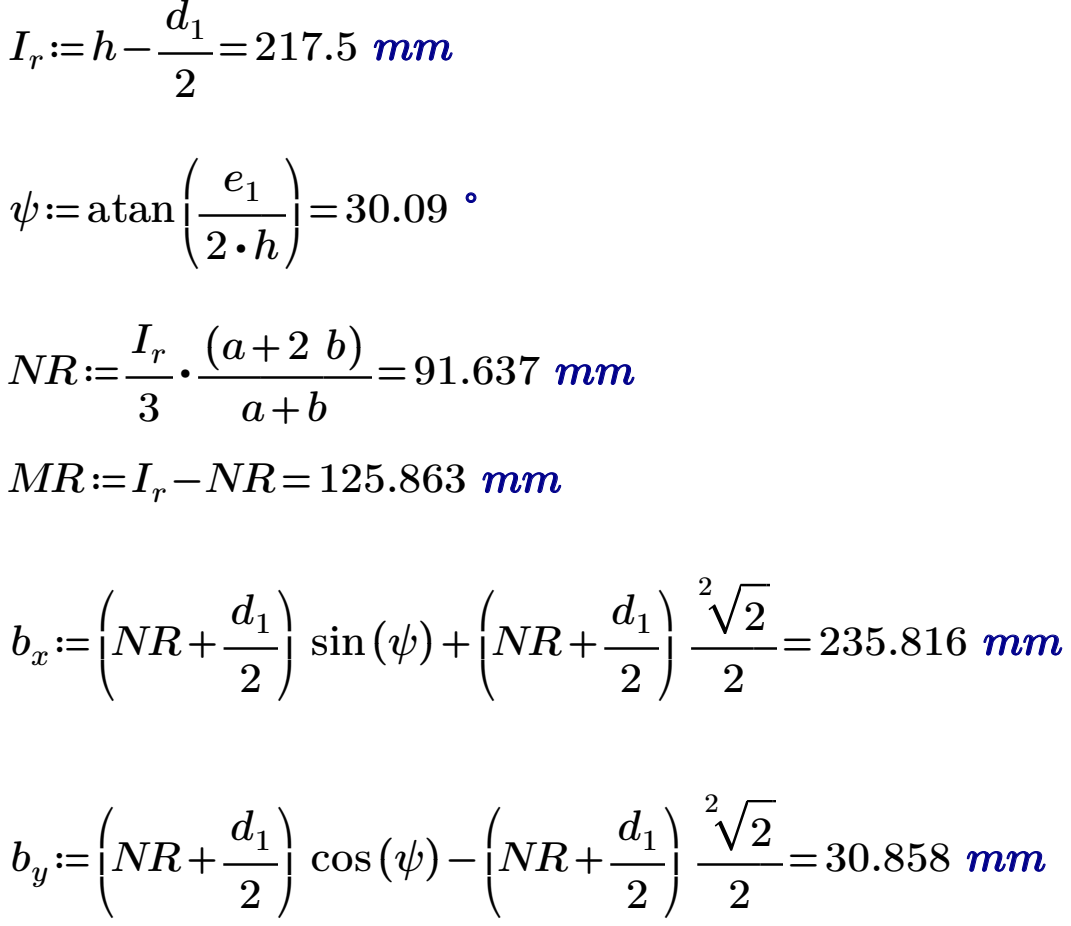
[picture p148: page 1]
=atan⎛; sin; cos (( ψ
