arma966/ProgettazioneMeccanica2020/Relazione/imgs/Mathcad2.pdf

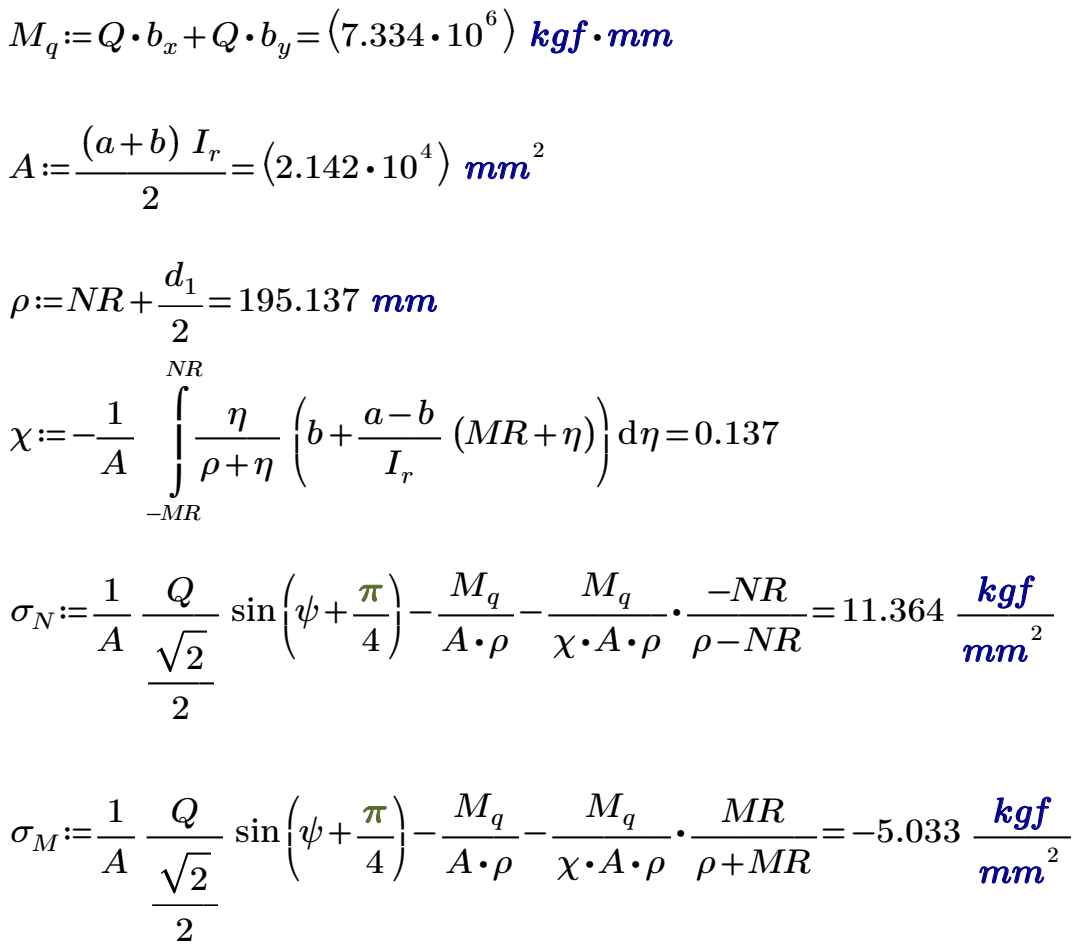
[picture p149: page 1]
kgf ⋅mm; 2.142 10 ⋅ 4 ⎞ ⎠ mm²; sin⎛ ⎜ ⎝; ―f mm²
