arma966/ProgettazioneMeccanica2020/Relazione/imgs/Mathcad3.pdf

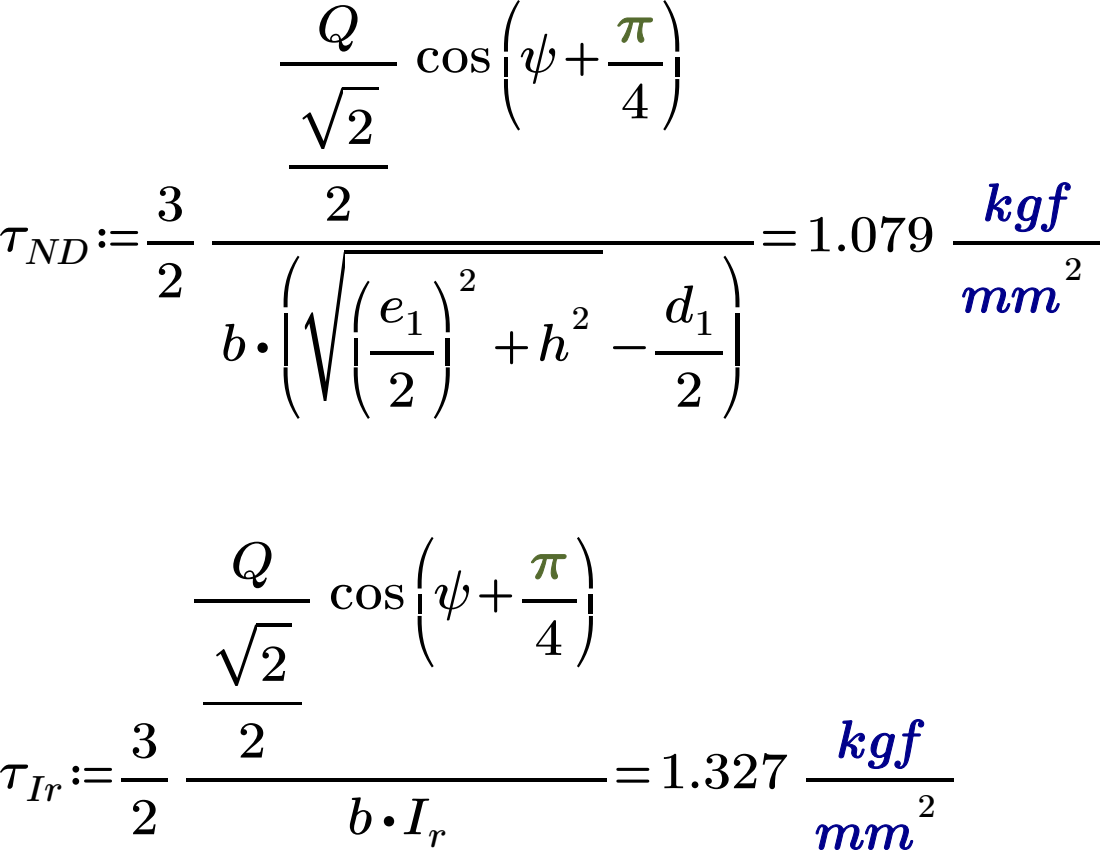
[picture p150: page 1]
τND≔―; cos ⎛ ⎜ ⎝; τIr≔―
