arma966/ProgettazioneMeccanica2020/Relazione/imgs/Mathcad4.pdf

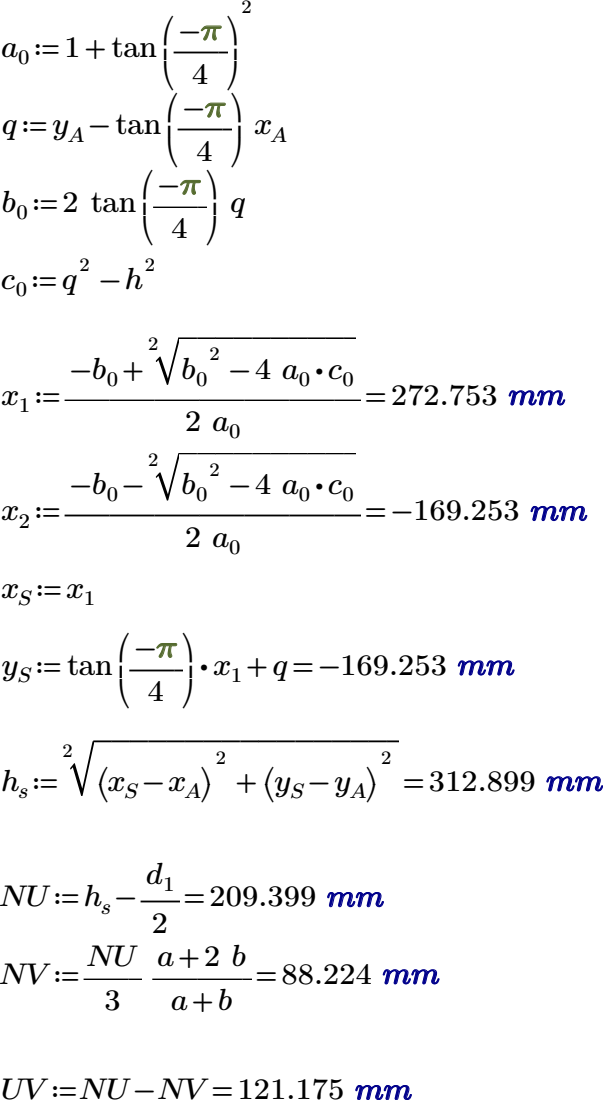
[picture p151: page 1]
a0≔ +1 tan⎛ ⎜ ⎝; q≔yA −tan⎛ ⎜ ⎝; b0≔2 tan⎛ ⎜ ⎝; yS≔tan
