arma966/ProgettazioneMeccanica2020/Relazione/imgs/MathLP1.pdf

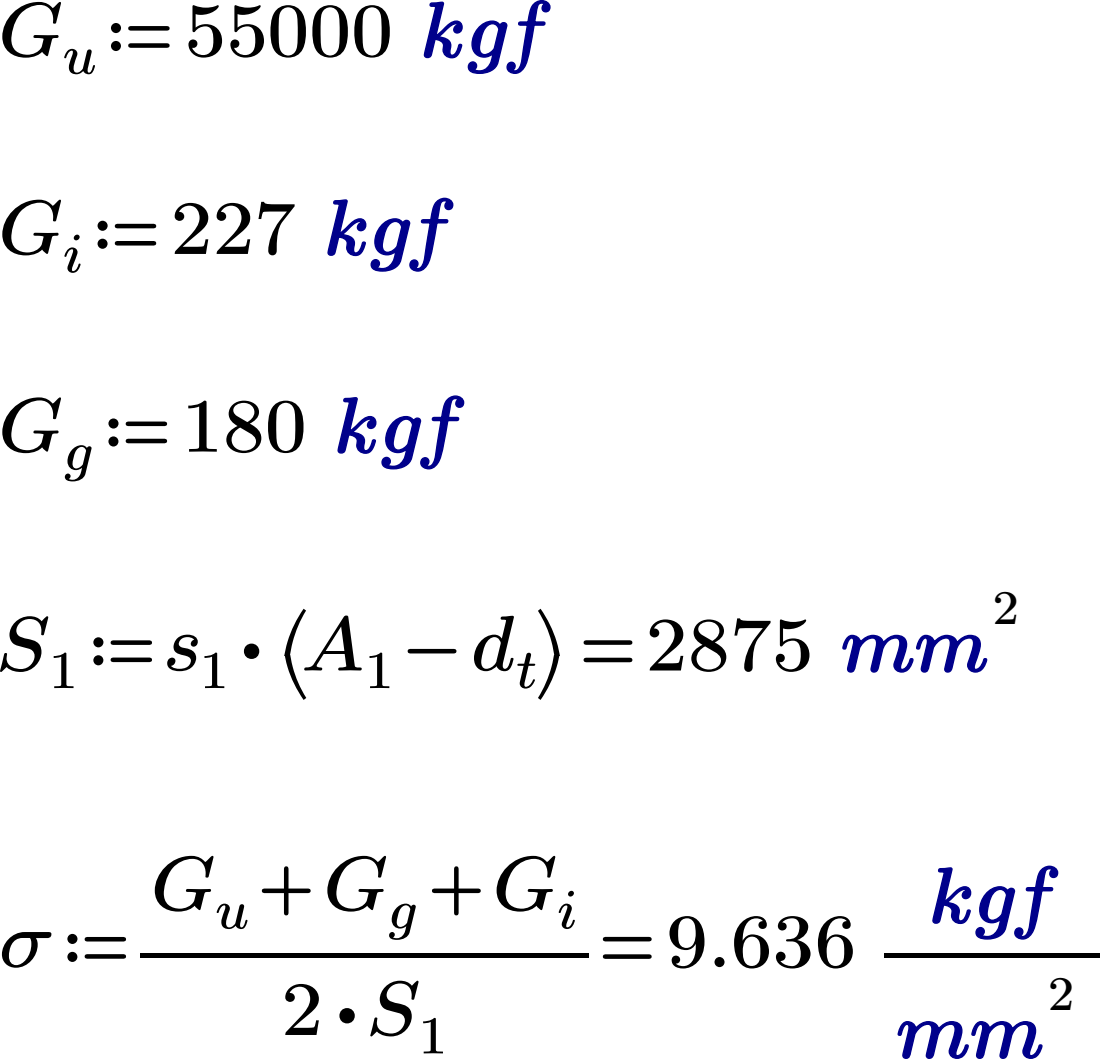
[picture p152: page 1]
Gu≔55000 kgf; Gi≔227 kgf; Gg≔180 kgf
