arma966/ProgettazioneMeccanica2020/Relazione/imgs/MathLP2.pdf

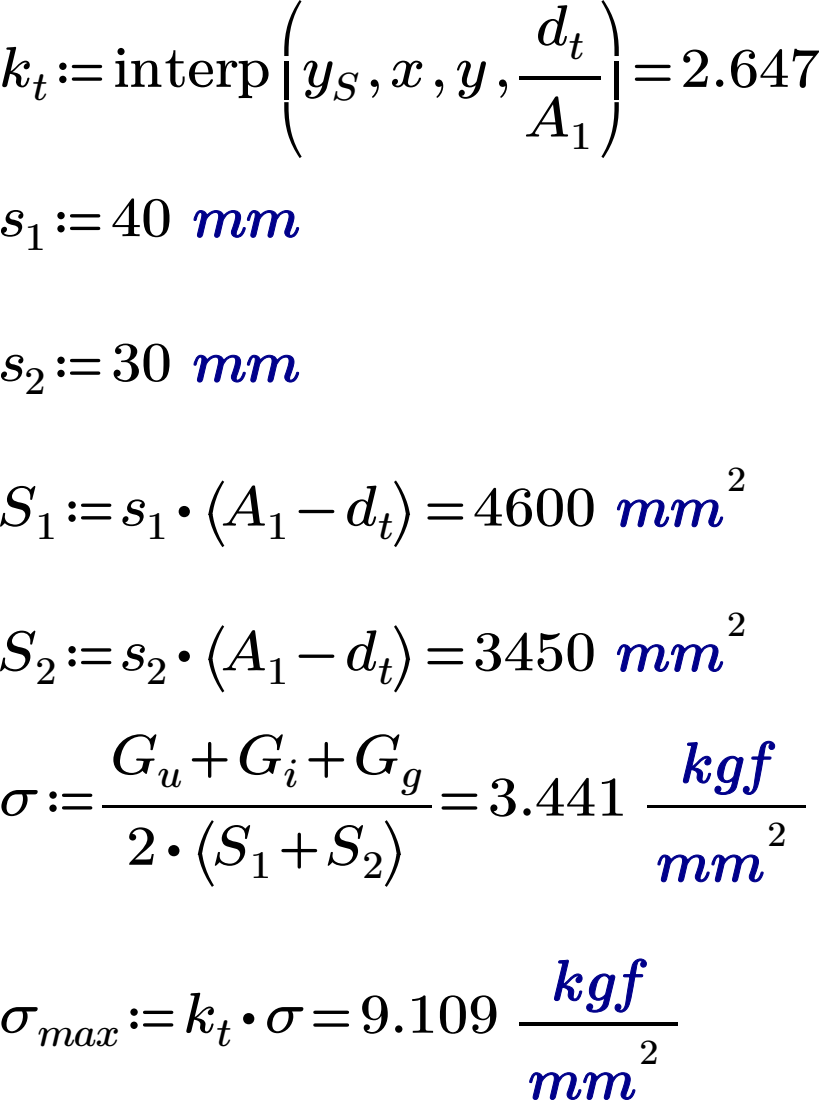
[picture p153: page 1]
kt≔interp; σmax≔kt⋅σ=9.109 ―kg
