arma966/ProgettazioneMeccanica2020/Relazione/imgs/MathLP3.pdf

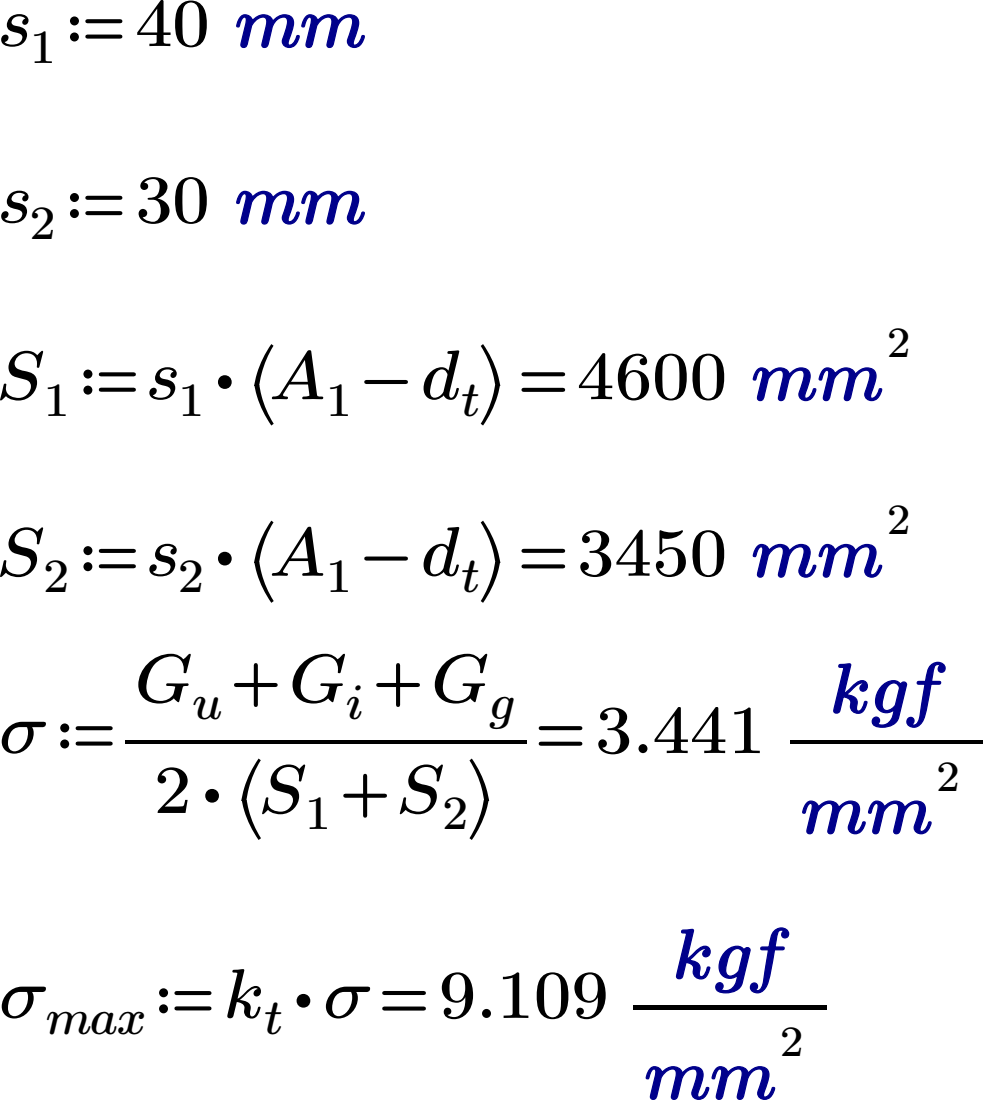
[picture p154: page 1]
σmax≔kt⋅σ=9.109 ―kg
