arma966/ProgettazioneMeccanica2020/Relazione/imgs/MathTrav2.pdf

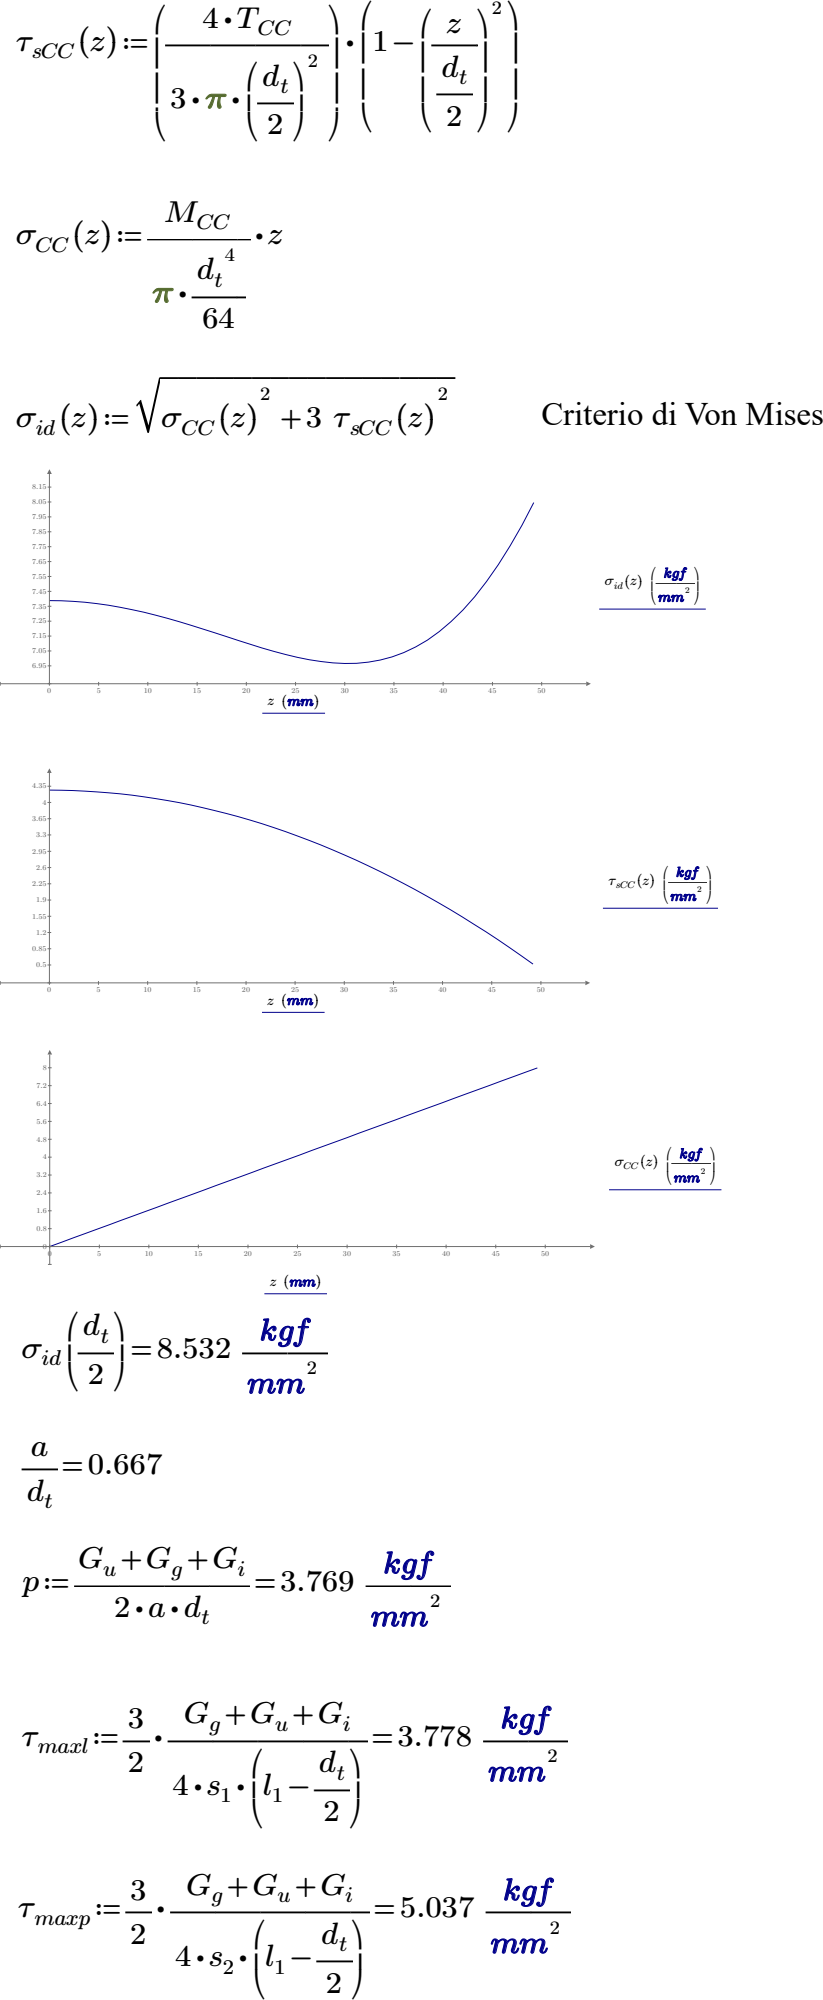
[picture p155: page 1]
τsCC; ―――― 4 ⋅TCC; σCC; ))≔―――⋅ MCC; σid; )≔ σCC; 3 τsCC; σid ((z)); ―f mm²; τsCC ((z)); σCC (z); τmaxl≔―⋅; τmaxp≔―⋅

Criterio di Von Mises
