arma966/ProgettazioneMeccanica2020/Relazione/imgs/MathTrav3.pdf

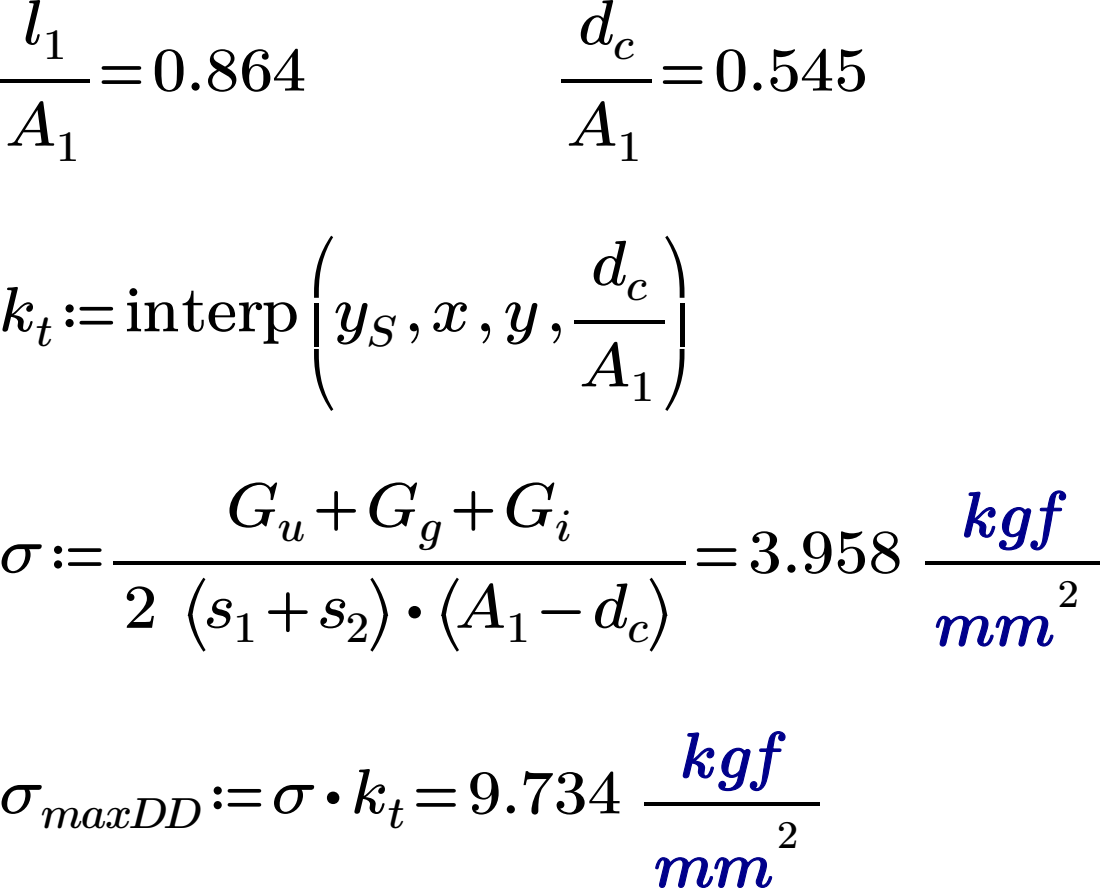
[picture p156: page 1]
kt≔interp⎛ ⎜ ⎝; σmaxDD≔σ⋅kt=9.734 ―kg
