arma966/ProgettazioneMeccanica2020/Relazione/imgs/MathTrav5.pdf

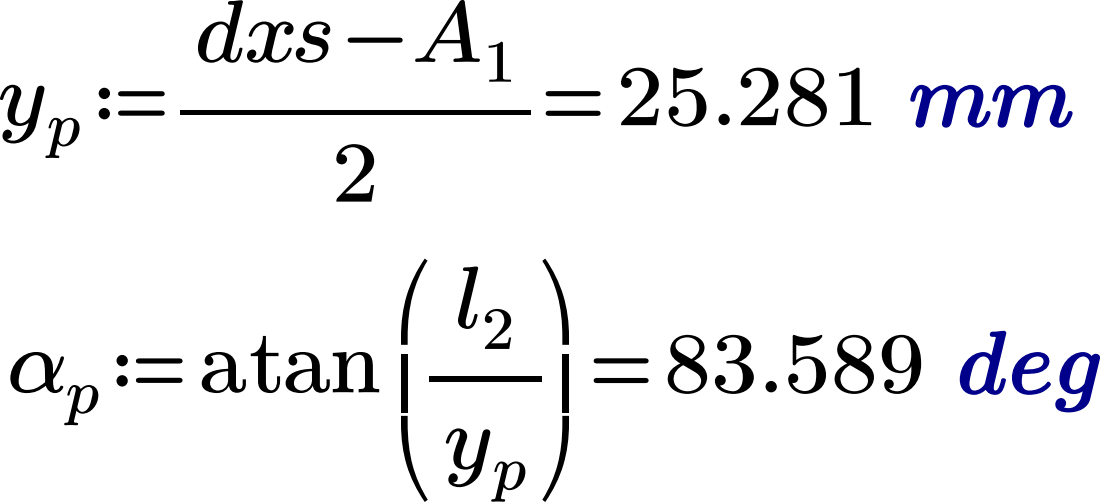
[picture p157: page 1]
yp≔―――= dxs A− 1 2; αp≔atan; 83.589 deg
