arma966/ProgettazioneMeccanica2020/Relazione/imgs/MathTrav6.pdf

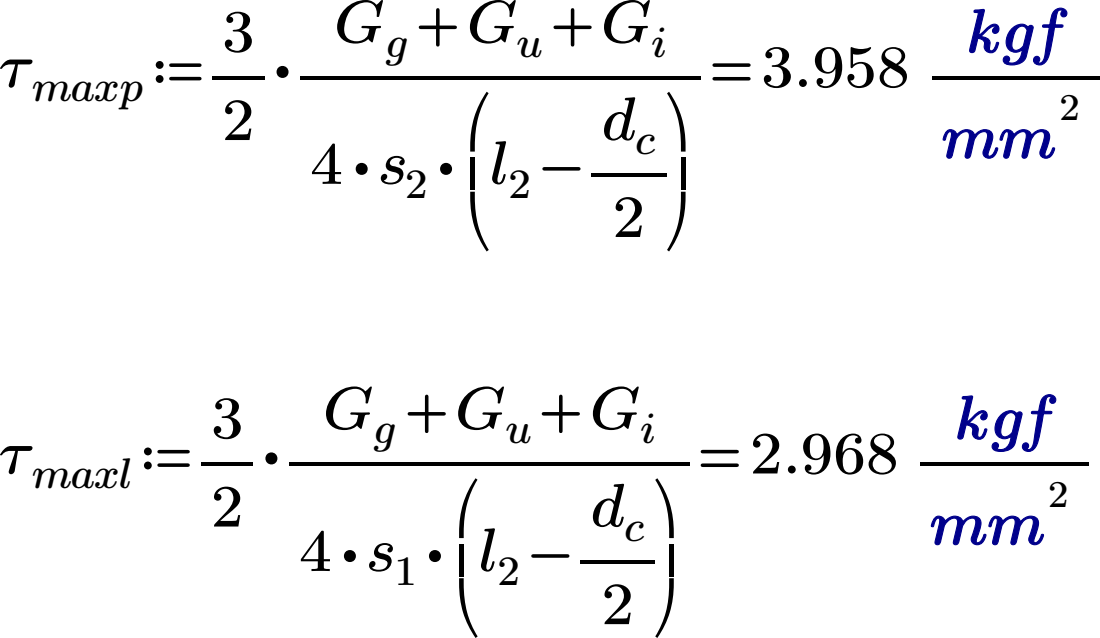
[picture p158: page 1]
τmaxp≔―⋅; τmaxl≔―⋅
