arma966/ProgettazioneMeccanica2020/(commit log)

2020-09-05 Commit relazione
    [Asse.SLDPRT, Interpolazioni.xlsx, Piastrone.SLDPRT, Traversa.SLDPRT]
2020-09-05 solidworks files
    [Asse.SLDPRT, Assembly.SLDASM, Boccola.SLDPRT, Dado.SLDPRT, Gancio.SLDPRT, Golfare.SLDPRT, M10 - 50mm.SLDPRT, M10 - Corta.SLDPRT]
